TravMcKee/Satellite-UHF-Radio-Beacon-system/VIVA and Interim report/VIVA Presentation/solar panels.jpg

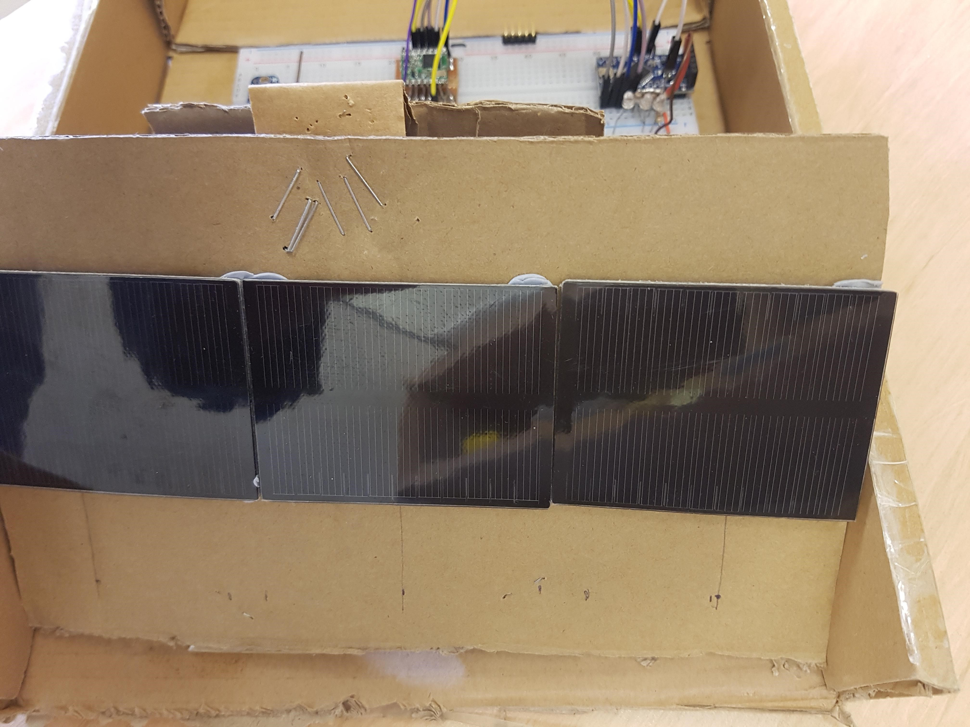
VIVA and Interim report/VIVA Presentation/solar panels.jpg
