TravMcKee/Satellite-UHF-Radio-Beacon-system/VIVA and Interim report/VIVA Presentation/complete system.jpg

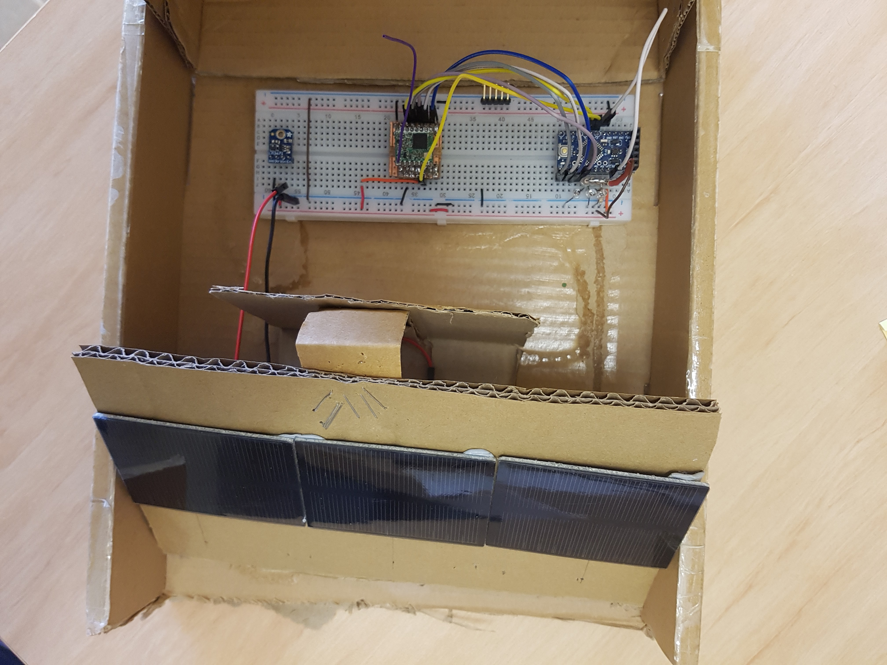
VIVA and Interim report/VIVA Presentation/complete system.jpg
