TravMcKee/Satellite-UHF-Radio-Beacon-system/README.md

# Satellite-UHF-Radio-Beacon-system
Satellite UHF Radio Beacon system for Identification, Telemetry, Tracking and Control

This repository provides all the data, testing files, results, softwar programs and documentation that was produced as part of the thesis project.
