TravMcKee/Satellite-UHF-Radio-Beacon-system/Additional resources/LoRa RFM95 Breadboard/RFM95LORA_Breadboard-master/README.md

# RFM95LORA_Breadboard
This is a KICAD project to create a RFM95 Breadboard PCB for LORAWAN operations

Here are the diagram and gerber files
