TravMcKee/Satellite-UHF-Radio-Beacon-system/project seminar/presentation.pdf

4/06/2020

# Design of a small satellite UHF radio

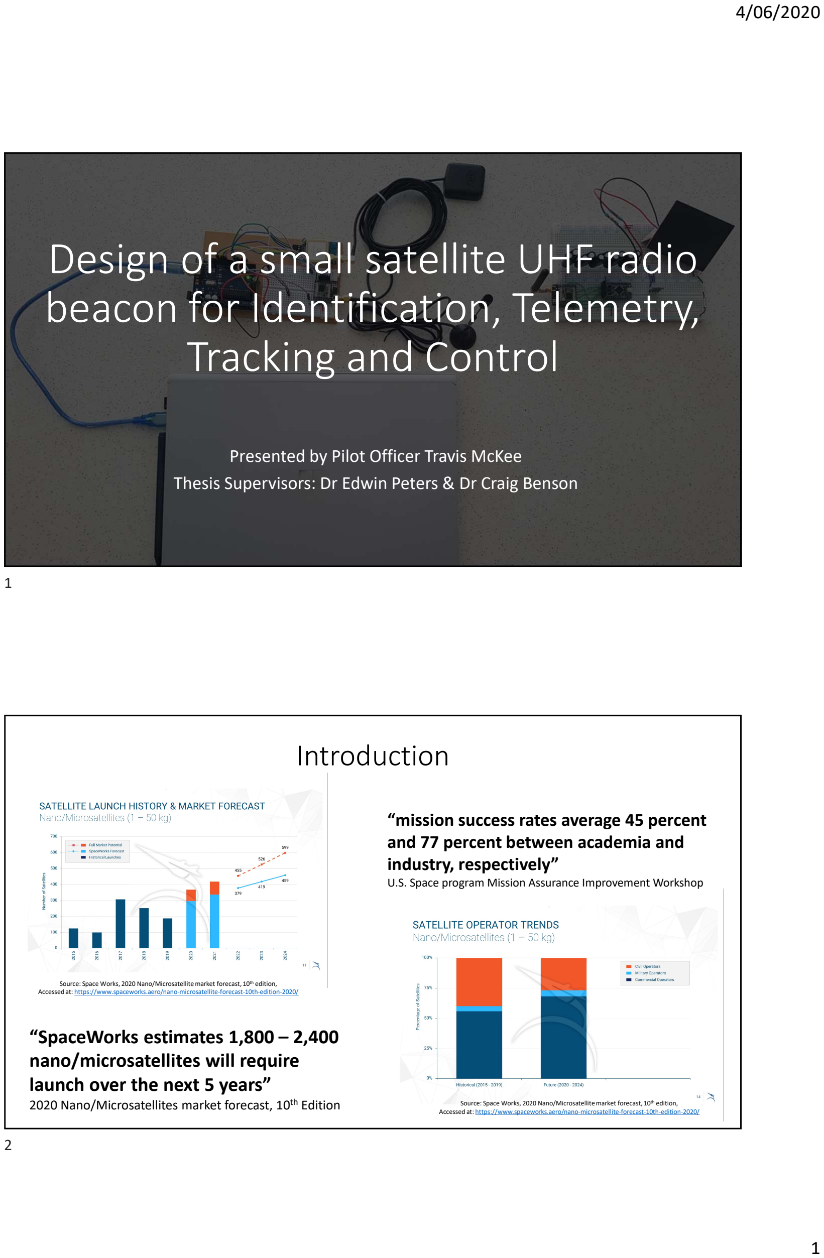
[picture p20: page 1]

1

beacon for Identification, Telemetry,

# Tracking and Control

### Presented by Pilot Officer Travis McKee Thesis Supervisors: Dr Edwin Peters & Dr Craig Benson

# Introduction

Source: Space Works, 2020 Nano/Microsatellite market forecast, 10th edition,
Accessed at: https://www.spaceworks.aero/nano-microsatellite-forecast-10th-edition-2020/ “SpaceWorks estimates 1,800 – 2,400

## nano/microsatellites will require launch over the next 5 years”

2020 Nano/Microsatellites market forecast, 10th Edition

### “mission success rates average 45 percent and 77 percent between academia and industry, respectively”

U.S. Space program Mission Assurance Improvement Workshop

Source: Space Works, 2020 Nano/Microsatellite market forecast, 10th edition, Accessed at: https://www.spaceworks.aero/nano-microsatellite-forecast-10th-edition-2020/

1

2

2

# Introduction

## 1. Increased demand on resource expensive space monitoring equipment to maintain Space situational awareness (SSA)

## 2. An increase in space debris due to a large failure rate of small satellites

## 3. Difficulties in identifying small objects in the LEO environment

## Additional challenges for monitoring and operating in the Low Earth Orbit (LEO) environment:

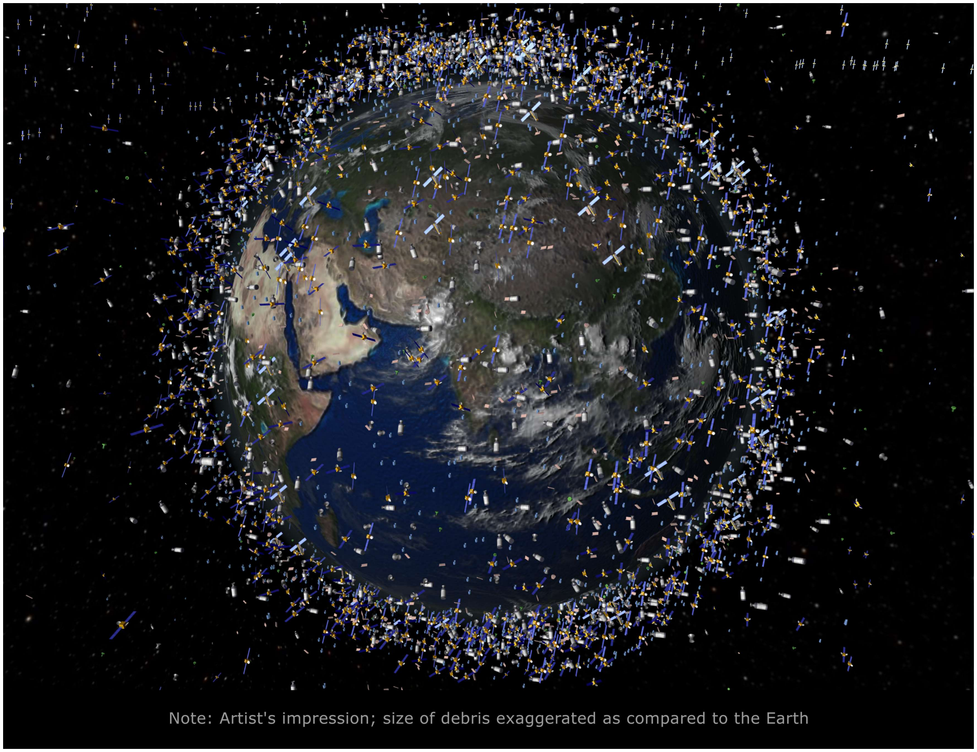
[picture p21: figure]

Image source: Universe Today, Space and astronomy news
Accessed at: https://www.universetoday.com/85322/what-is-low-earth-orbit/

# Introduction

The purpose of this project is to design a satellite UHF radio beacon system which provides: 1. A better technique of uniquely identifying an object in LEO 2. A cost-effective system of tracking objects 3. A method of obtaining satellite telemetry data irrespective of a failure in any other system 4. An alternative communications pathway for satellite control

3

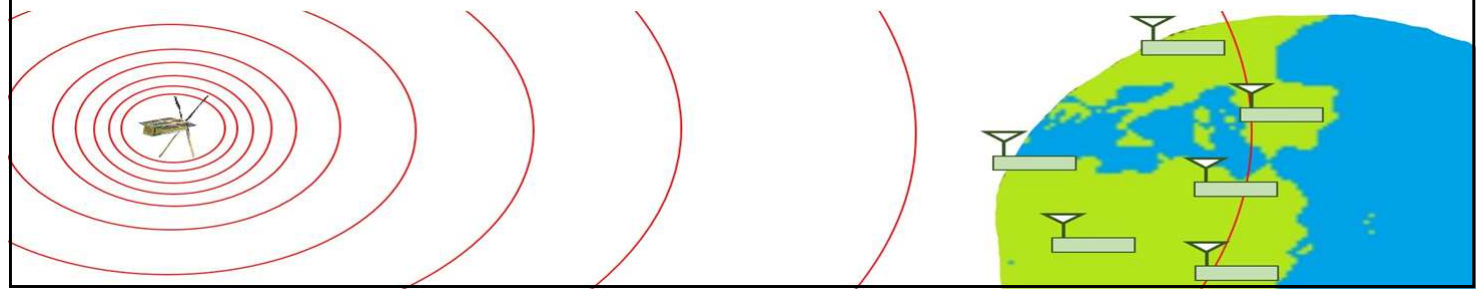
[picture p22: figure]

4

3

# Theory

of

# Operation

The Satellite UHF radio beacon system will be separated into 3 components: • The satellite radio beacon – A self-sustained system that can operate

independently of all other satellite systems

- The communications link – Supports the transmission of data from the radio beacon in LEO to a ground receiving station (2000km slant range) • The ground receiving station – Captures the transmitted data, records

the precise time of arrival (TOA) and passes data to a peripheral device.

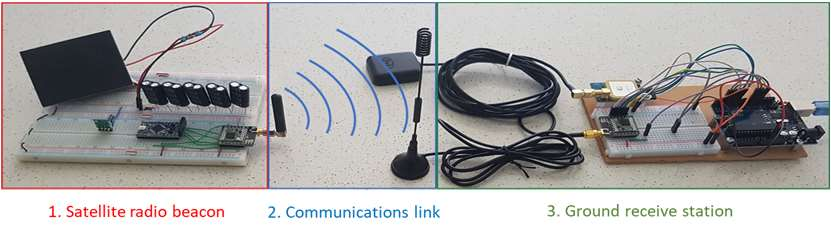
[picture p23: figure]

# Theory of operation

### - The satellite beacon periodically transmits the collected

telemetry data and a unique address from the UHF radio • Followed by a period where command data can be received

### - The transmitted data is collected with the measured time of

arrival at multiple graphically dispersed ground stations • The collected data and timestamps are passed along to a

peripheral device for processing. • The time difference of arrival (TDOA) between the three

### ground stations allows for the calculation of the satellites estimated position

5

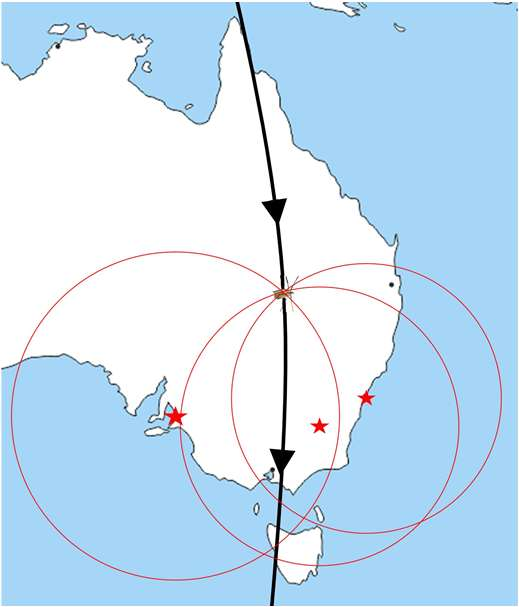
[picture p24: figure]

6

4

# Satellite Radio Beacon

The satellite radio beacon must be self-sustaining and independent of all other satellite systems

To achieve these aims the beacon contains its own: • Processor –Arduino Pro Mini (APM) module containing an ATMEGA328

processor • Radio Transceiver –RFM96 LoRa radio module, which uses an ultra-long

range spread spectrum communication techniques

- Power Generation, Storage and Regulation – 0.5W Silicon solar panel, super-capacitor storage system and a buck converter regulator

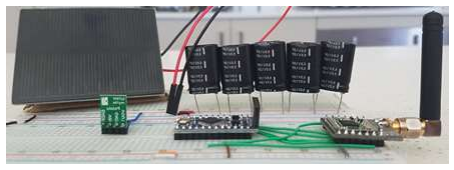
[picture p25: figure]

# Satellite Radio Beacon

The software cycle for the satellite radio beacon was developed to comply with the following requirements: • Maintain radio silence 30 minutes after release from

the launch vehicle

- A receive period to receive a command to cease radio transmissions as required by ACMA and ITU
- A variable period for the power down phase to prevent transmission synchronisation

7

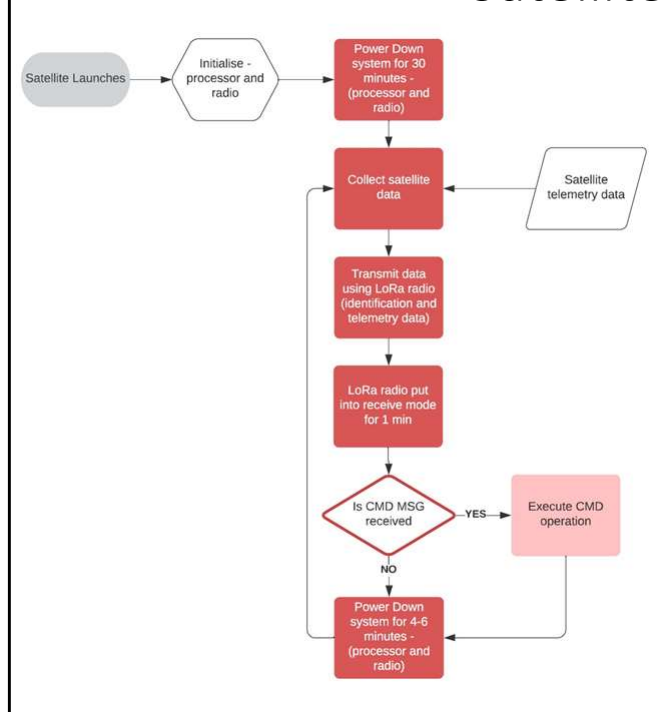
[picture p26: figure]

8

5

# Satellite Radio Beacon

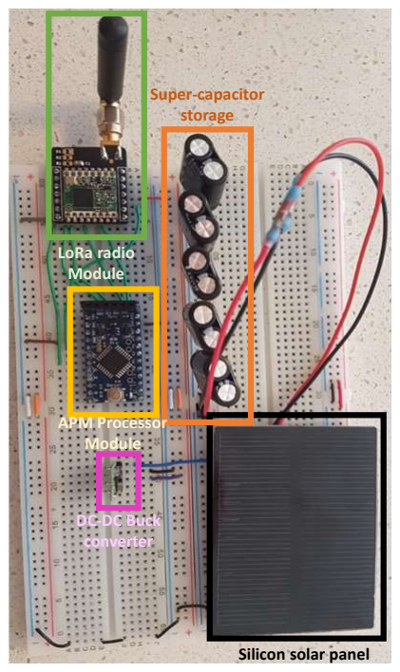
[picture p27: figure]
Super-capacitor storage; LoRa radio Module; APM Processor Module; DC-DC Buck converter; Silicon solar panel

### Manufacture of the satellite radio beacon prototype (see right) was a result of the testing carried out to minimise the Size, Weight and Power (SWaP) of each component

Methods to reduce the beacon current consumption: • Placing the LoRa module into sleep mode • Placing the processor into low power mode

- Minimizing the receive and transmit phase • Decreasing the TX power and data packet size

Additional observations during the testing: • One solar panel could not support beacon operation without

supplementary power • The super-capacitors introduce an 8 and ½ min delay to initialisation • Several radio packets were dropped by the LoRa radio module

(investigated in the communications link testing)

# Satellite Radio Beacon

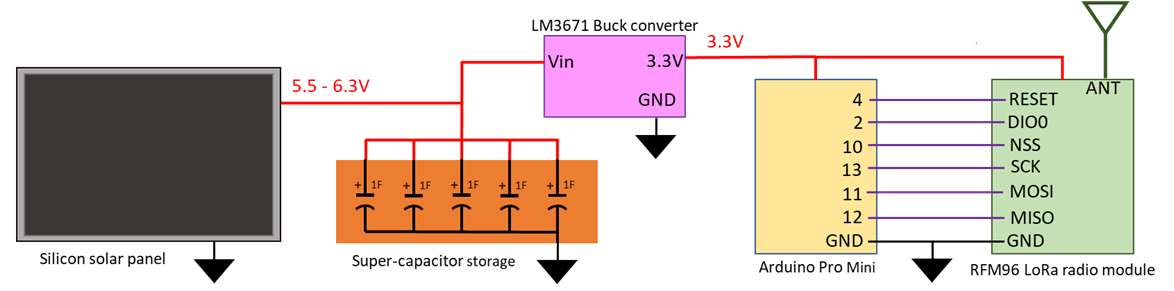
[picture p28: figure]

## Satellite UHF radio beacon conclusion

- A single solar panel can sustain beacon operation when using the super-capacitor storage
- The power storage system provides 74 minutes of operation when no power is being generated
- A combination of connections remaining to collect satellite telemetry data
- Over 50% of the system memory remains for additional software development

### Investigation of space-ready components and a PCB design is required before mission-readiness testing can be commenced

9

10

6

# Communications Link

The parameters for the communication link testing are based on a sun-synchronous LEO orbit with an orbital height of 600km and a 98° inclination.

Resultant Orbital characteristics: • 90-minute orbital period

- ~9-minute view window
- 2000km maximum slant range
- 151.3dB Free Space Path Loss (at 2000km)

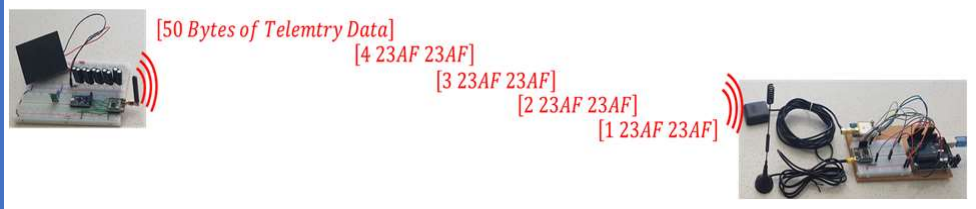
[picture p29: figure]

# Communications Link

First investigation
Determine why the LoRa radio module was dropping received packets

Result • The reason could not be determined due to proprietary nature of the LoRa module software • No methods could be found to bypass the LoRa software receive process

- Analysing over 1 million Bytes of data found a Packet Error Rate (PER) of ~1%

Mitigation
- The PER changed how the identification and address data was transmitted
- Separating the data packets results in a 0.00001% probability of not receiving the identification data

11

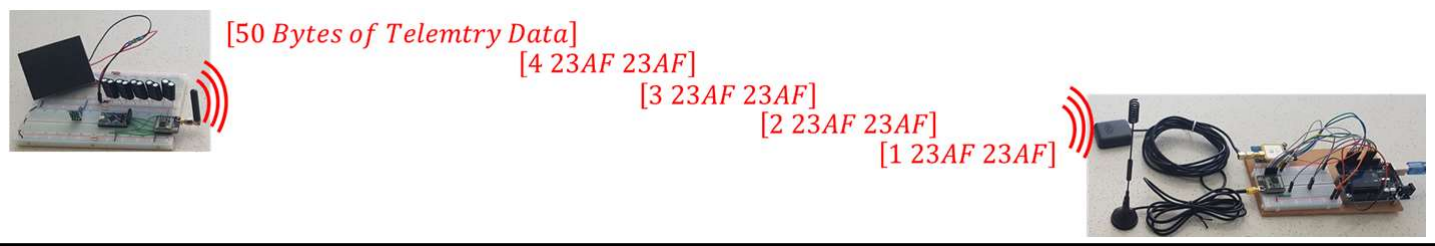
[picture p30: figure]

12

7

# Communications Link

Second investigation
Verify the UHF communications link for a 2000km slant range (151.3dB FSPL) and determine the LoRa radio software settings and TX power.

Testing procedure
1. Receiver sensitivity estimated using the LoRa modem calculator tool (available from Semtech)

### 2. The link budget was calculated for various TX power (5, 10, 15 and 20dBm) 3. The results were verified with the ground-based testing

The radio settings used for testing were from the open-sourced RadioHead library default settings

RadioHead default setting | LoRa module radio configuration | Bandwidth | Coding rate | Spreading factor | Preamble length | Estimated Bit rate | Estimated receiver sensistivity
(0) | Medium range & data rate | 125 kHz | 4/5 | 7 (128 chips/symbol) | 12 | 5469 bps | -124 dBm
(2) | Long range, slow data rate | 31.25 kHz | 4/8 | 10 (512 chips/symbol) | 12 | 152.59 bps | -139.4 dBm
(3) | Long range, slow data rate | 125 kHz | 4/8 | 12 (4096 chips/symbol) | 12 | 183.11 bps | -138 dBm

# Communications Link

Assumptions: • LoRa module has a 0.5dB feeder loss

- 290k ground temperature • 3.5dBi helix transmitter antenna
- 3.5dBi helix receiver antenna (noting there is a 12dBi antenna that could be used) • Maximum bit rate (f) obtained using the LoRa modem calculator tool (proven using hand calculations)

### Link Budget Calculations

C

= Pamp − Lft + Gt − LFS − LA

C
N0

= C − 10. log k +

G
Te − Lfr

Eb
N0 =

C
N0

− 10. log (fb)

### Calculated values for the communications link budget

| (0) Medium Range Settings | (2) Long Range Settings | (3) Long Range Settings
RadioHead default settings Parameter Transmitter Power, Pamp (dBm) | -8.73 5 -3.73 10 1.27 15 6.27 20 | 4.38 5 9.38 10 Downlink 14.38 15 20.38 20 | 3.59 5 8.59 10 Downlink 13.59 15 18.59 Downlink 20 Bit Enegy/Noise Density Ratio, Eb/No

Link Budget calculations for the satellite radio beacon communications link at 2000kms

13

14

8

# Communications Link

Ground-Based Testing
Two LoRa modules were connected with coaxial cables and attenuation that represents the maximum FSPL (and calculated range) for the consistent reception of data packets

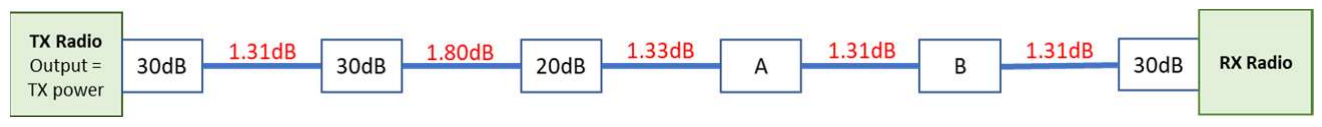
[picture p31: figure]

### Results of the ground-based communication link testing

## Communications link conclusion

The RadioHead (2) default setting with a 15dBm TX power was selected for the LoRa radio module

These settings balance the satellite beacon power consumption, received E/N (14.38) and data rate

Transmit power (dBm) | | 10 | 15 | 20 5
RadioHead default setting | Reciever sensitivity (dB) | Total attenuation (dB) | Distance (kms) | Total attenuation (dB) | Distance (kms) | Total attenuation (dB) | Distance (kms) | Total attenuation (dB) | Distance (kms)
(0) | -124 | 131.14 | 195 | 137.14 | 390 | 141.14 | 620 | 145.14 | 980
(2) | -139.2 | 146.14 | 1100 | 151.14 | 1950 | 155.14 | 3100 | 161.14 | 6200
(3) | -138 | 144.14 | 880 | 150.14 | 1750 | 155.14 | 3100 | 160.14 | 5500

Largest measured FSPL attenuation and distance for consistent data reception

# Ground Receiving Station

The ground receiving station must be able to capture the transmitted data, record the precise time of arrival of the RF signals, determine its global location and pass data to a peripheral device.

To achieve these aims the ground receiving station contains: • Processor module – Arduino Uno development board with an

ATMEGA328P processor and 16MHz oscillator • Radio Module – RFM96 LoRa radio module

- GPS Module – U-Blox NEO-7M GNSS module with a Pulse-per-Second signal synchronized to Coordinated Universal Time (UTC)

15

16

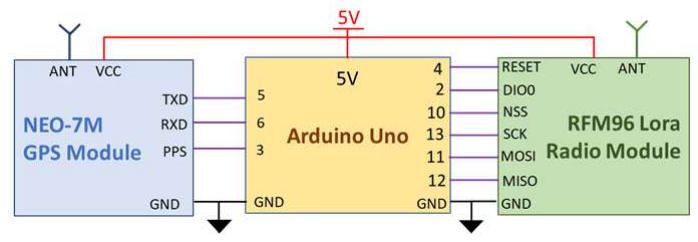
[picture p32: figure]

9

# Ground receiving station

### Ground receiving station software cycle

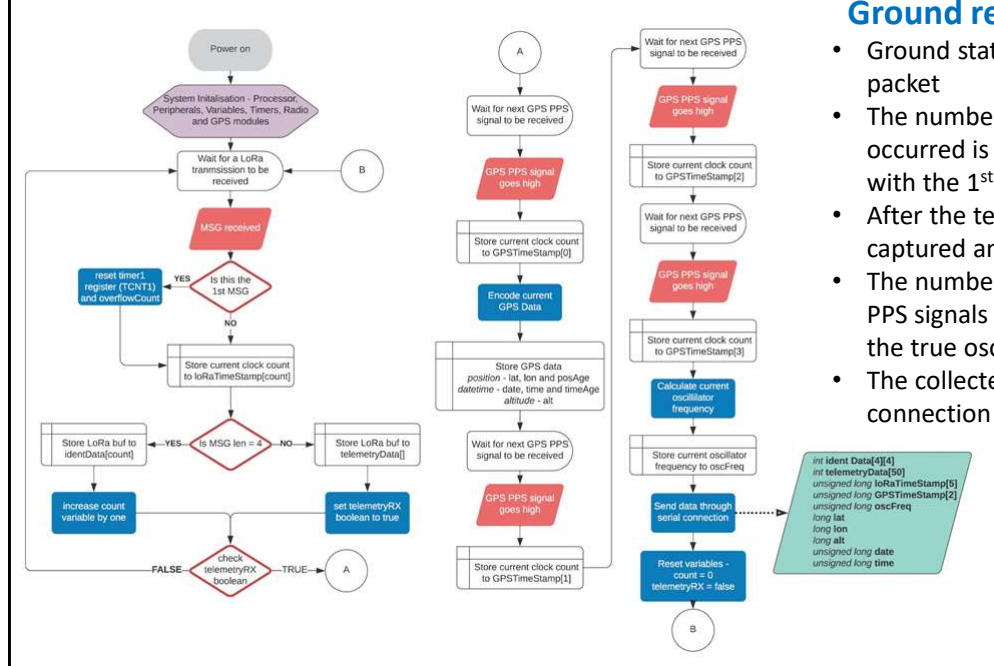
[picture p33: figure]

- Ground station captures the data from each received packet • The number of processor clock cycles that have

occurred is timestamped (the clock count is reset with the 1st Received signal) • After the telemetry data is received, the GNSS data is

captured and timestamped at the next PPS pulse, • The number of clock cycles between the next 3 GNSS

PPS signals are collected and averaged to determine the true oscillator frequency
- The collected data is passed through the serial connection to a peripheral device
- The true oscillator frequency is used to determine the length of the processors clock cycle
- This value is used to calculate the time of arrival of each timestamp with reference to the captured UTC

# Ground receiving station

First Investigation
To test and quantify the identified sources of uncertainty in measuring time/distance:
1. 4µs Resolution of the Arduino timing function, micros() – led to using the clock counting technique
2. Error in TIMER1 processor clock counting technique, ±3 clock cycles ~187.5ns (equates to 56.5m)
3. Number of clock cycles taken for an Interrupt Service Routine (ISR), no error time difference

### 4. External oscillator drift and tolerances, < 2fs (negligible) 5. GNSS PPS signal tolerance, 30ns (9m) 6. GNSS position tolerance, 10m 7. Difference in LoRa software receive processing time, 5µs (1.5km)

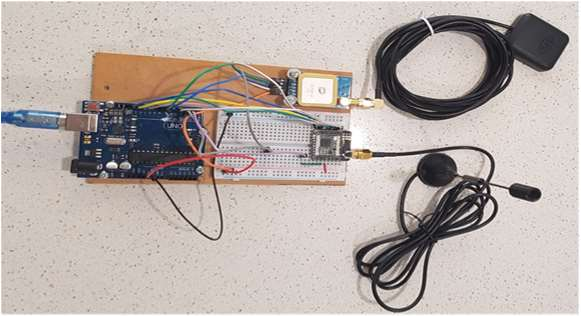
[picture p34: figure]

Results
The total estimated uncertainty in the time difference of arrival between two ground stations was 5.25µs. This equates to an uncertainty of 1.58km when estimating the

position using the TDOA calculation technique.

17

18

10

# Ground receiving station

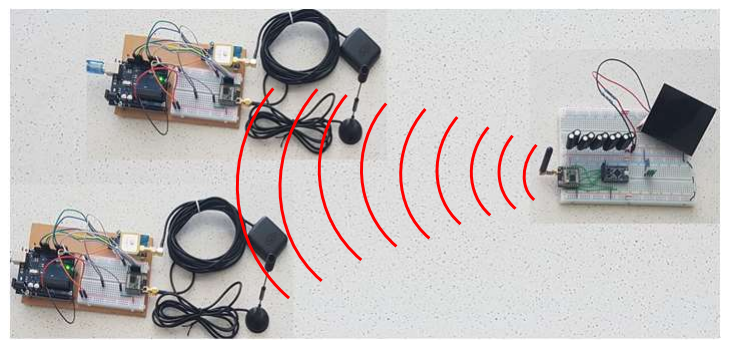
[picture p35: figure]

## Ground Receiving station conclusion

The estimated uncertainty in satellite position was 1.58km, the verification test revealed an uncertainty of 510km

The mostly likely cause of the large uncertainty is the implementation of the processor clock counting ISR

The clock counting technique requires examination with a focus on timer capture mode, before a reliable TDOA algorithm can be used to estimate the satellites position.

Final verification Testing
Two ground stations were uniformly connected to a single radio beacon
The measured time difference of arrival is the level of uncertainty in measuring time

Results
Total measured uncertainty was 1.7ms, which equates to TDOA distance calculation error is 510km

# Conclusion

## Project aim: Prototype design for a self-contained and independent radio beacon Project extension: Prototype design for a ground receiving station

The Satellite UHF radio beacon system has been tested and verified to:

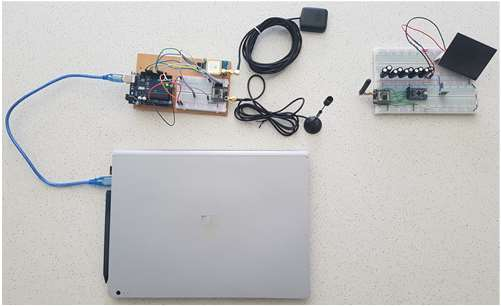
[picture p36: figure]

### - The initial design for the small satellite UHF radio beacon system has proven the concept for the small satellite beacon Identification, Telemetry and Control

### - Further investigation is required to obtain a reliable and accurate tracking function

- Sustain beacon operation without any input • Operate for a 2000km range
- Transmit the satellite identification to the ground station
- Transmit satellite telemetry and health data
- Execute a satellite control command from a ground station
- Measure a signal Time of Arrival with a 1.7ms tolerance (510km position calculation uncertainty)

19

20

11

# Recommendations

### Further investigation is required to reduce the uncertainty of time measurement, with a focus processor Timer1 clock counting implementation in the ground station software

If the uncertainty of time measurement is reduced, then the next step is to: • Implement a TDOA algorithm that calculates estimated position based on Lat/Long

### position - Develop a user interface program for the ground receiving station - Develop a server system for the collection and processing of ground station data - Produce a satellite radio beacon design ready for space mission readiness testing

21

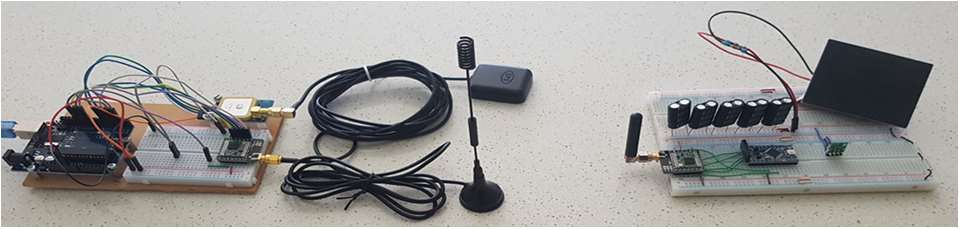
[picture p37: figure]
