TravMcKee/Satellite-UHF-Radio-Beacon-system/VIVA and Interim report/Appendix A - Project Gantt chart.xlsx

Sheet: ProjectSchedule
Create a Project Schedule in this worksheet. Enter title of this project in cell B1. Information about how to use this worksheet, including instructions for screen readers and the author of this workbook is in the About worksheet. Continue navigating down column A to hear further instructions. | Small Sat UHF Identification and TT&C radio beacon
Enter Company Name in cell B2. | UNINSW Canberra - Thesis project |  |  |  |  | https://www.vertex42.com/ExcelTemplates/simple-gantt-chart.html
Enter the name of the Project Lead in cell B3. Enter the Project Start date in cell E3. Pooject Start: label is in cell C3. | Travis MCKee | Project Start: |  | 2019-07-17 |  | Week 1 |  |  |  |  |  |  | Week 2 |  |  |  |  |  |  | Week 3 |  |  |  |  |  |  | Week 4 |  |  |  |  |  |  | Week 5 |  |  |  |  |  |  | Week 6 |  |  |  |  |  |  | Week 7 |  |  |  |  |  |  | W8 - Break
The Display Week in cell E4 represents the starting week to display in the project schedule in cell I4. The project start date is considered Week 1. To change the display week, simply enter a new week number in cell E4. The starting date for each week, starting with the display week from cell E4, starts in cell I4 and is auto calculated. There are 8 weeks represented in this view from cell I4 through cell BF4. You should not modify these cells. Display Week: label is in cell C4. |  | Display Week: |  | 1 |  | 2019-07-15 |  |  |  |  |  |  | 2019-07-22 |  |  |  |  |  |  | 2019-07-29 |  |  |  |  |  |  | 2019-08-05 |  |  |  |  |  |  | 2019-08-12 |  |  |  |  |  |  | 2019-08-19 |  |  |  |  |  |  | 2019-08-26 |  |  |  |  |  |  | 2019-09-02
Cells I5 through BL5 contain the day number for the week represented in the cell block above each date cell and are auto calculated. You should not modify these cells. Today's date is outlined in Red (hex #AD3815) from today's date in row 5 through the entire date column to the end of the project schedule. |  |  |  |  |  | 2019-07-15 | 2019-07-16 | 2019-07-17 | 2019-07-18 | 2019-07-19 | 2019-07-20 | 2019-07-21 | 2019-07-22 | 2019-07-23 | 2019-07-24 | 2019-07-25 | 2019-07-26 | 2019-07-27 | 2019-07-28 | 2019-07-29 | 2019-07-30 | 2019-07-31 | 2019-08-01 | 2019-08-02 | 2019-08-03 | 2019-08-04 | 2019-08-05 | 2019-08-06 | 2019-08-07 | 2019-08-08 | 2019-08-09 | 2019-08-10 | 2019-08-11 | 2019-08-12 | 2019-08-13 | 2019-08-14 | 2019-08-15 | 2019-08-16 | 2019-08-17 | 2019-08-18 | 2019-08-19 | 2019-08-20 | 2019-08-21 | 2019-08-22 | 2019-08-23 | 2019-08-24 | 2019-08-25 | 2019-08-26 | 2019-08-27 | 2019-08-28 | 2019-08-29 | 2019-08-30 | 2019-08-31 | 2019-09-01 | 2019-09-02 | 2019-09-03 | 2019-09-04
This row contains headers for the project schedule that follows below them. Navigate from B6 through BL 6 to hear the content. The first letter of each day of the week for the date above that heading, starts in cell I6 and continues through cell BL6. All project timeline charting is auto generated based on the start and end dates entered, using conditional formats. Do not modify content in cells within columns after column I starting with cell I7. | TASK | ASSIGNED TO | PROGRESS | START | END | M | T | W | T | F | S | S | M | T | W | T | F | S | S | M | T | W | T | F | S | S | M | T | W | T | F | S | S | M | T | W | T | F | S | S | M | T | W | T | F | S | S | M | T | W | T | F | S | S | M | T | W
Cell B8 contains the Phase 1 sample title. Enter a new Title in cell B8. Enter a name to assign the phase to, if it applies for your project, in cell C8. Enter Progress for the entire phase, if it applies for your project, in cell D8. Enter the start and end dates for the entire phase, if it applies for your project, in cells E8 and F8. The Gantt chart will automatically fill in the appropriate dates and shade according to the progress entered. To delete the phase and work only from tasks, simply delete this row. | Planning
Cell B9 contains the sample task "Task 1." Enter a new task name in cell B9. Enter a person to assign the task to in cell C9. Enter progres of the task in cell D9. A progress bar appears in the cell and is shaded according to the number in the cell. For example, 50 percent progress would shade half of the cell. Enter task start date in cell E9. Enter task end date in cell F9. A status bar shaded for the dates entered appears in blocks starting from cell I9 through BL9. | Scope Determination |  | 100% | 2019-07-15 | 2019-08-04
Rows 10 through 13 repeat the pattern from row 9. Repeat the instructions from cell A9 for all task rows in this worksheet. Overwrite any sample data. A sample of another phase starts in cell A14. Continue entering tasks in cells A10 through A13 or go to cell A14 to learn more. | Literture Review |  | 100% | 2019-06-15 | 2019-10-04
 | General Research |  | 100% | 2019-07-15 | 2019-09-01
The cell at right contains the Phase 2 sample title. You can create a new phase at any time within column B. This project schedule does not require phases. To remove the phase, simply delete the row. To create a new phase block in this row, enter a new Title in cell at right. To continue adding tasks to the phase above, enter a new row above this one and fill in the task data as in cell A9's instruction. Update the Phase details in cell at right based on cell A8's instruction. Continue navigating down column A cells to learn more. If you haven't added any new rows in this worksheet, you will find 2 additional sample phase blocks have been created for you in cells B20 and B26. Otherwise, navigate through column A cells to find the additional blocks. Repeat the instructions from cells A8 and A9 whenever you need to. | Breadboard design and build
 | Initial system design |  | 100% | 2019-08-12 | 2019-08-25
 | Processor and comms build |  | 100% | 2019-08-26 | 2019-09-15
 | Ground Solar generation and regulation build |  | 100% | 2019-09-16 | 2019-09-22
 | Full breadboard intergration |  | 100% | 2019-09-23 | 2019-10-04
 | breadboard extra peripherals design and build |  | 100% | 2019-09-26 | 2019-10-17
Sample phase title block | Testing and Evaluation
 | Initial testing |  | 100% | 2019-09-16 | 2019-09-22
 | Power cycle testing |  | 100% | 2019-09-22 | 2019-09-29
 | Solar Power Testing |  | 100% | 2019-09-26 | 2019-09-29
 | Short and full beacon cycle testing |  | 100% | 2019-09-29 | 2019-10-04
 | Extra peripherals testing |  | 100% | 2019-09-29 | 2019-10-04
 | VIVA presentation testing |  | 100% | 2019-10-04 | 2019-10-07
 | Initial testing plan |  | 0% | 2019-10-07 | 2019-12-08
 | Final testing plan |  | 0% | 2019-12-09 | 2020-01-31
Sample phase title block | Incremental development milestones
 | breadboard Model for VIVA presentation |  | 100% | 2019-08-12 | 2019-10-07
 | Initial software development |  | 100% | 2019-08-12 | 2019-10-07
 | Initial breadboard testing |  | 100% | 2019-09-29 | 2019-10-07
 | Finial breadboard testing |  | 0% | 2019-10-07 | 2019-12-08
 | Intial PCB Design |  | 0% | 2019-10-07 | 2019-12-23
 | Initial PCB prototype |  | 0% | 2019-12-23 | 2020-01-19
 | Initial PCB testing |  | 0% | 2020-01-19 | 2020-01-26
 | Build, Test, Evaluate and Redesign cycle |  | 0% | 2020-01-16 | 2020-05-25
 | 1st deliverable working PCB model |  | 0% | 2020-02-10 | 2020-02-10
 | Final PCB model |  | 0% | 2020-05-25 | 2020-05-25
 | Final model tested and complete |  | 0% | 2020-05-25 | 2020-05-31
 | Final software design for PCB model (seminar presentation) |  | 0% | 2020-06-01 | 2020-06-06
The cell at right contains the Phase 2 sample title. You can create a new phase at any time within column B. This project schedule does not require phases. To remove the phase, simply delete the row. To create a new phase block in this row, enter a new Title in cell at right. To continue adding tasks to the phase above, enter a new row above this one and fill in the task data as in cell A9's instruction. Update the Phase details in cell at right based on cell A8's instruction. Continue navigating down column A cells to learn more. If you haven't added any new rows in this worksheet, you will find 2 additional sample phase blocks have been created for you in cells B20 and B26. Otherwise, navigate through column A cells to find the additional blocks. Repeat the instructions from cells A8 and A9 whenever you need to. | Documentation
 | Access approval forms |  | 100% | 2019-07-16 | 2019-07-16
 | TSG/WHS/Ethics plan |  | 100% | 2019-08-16 | 2019-08-16
 | Interim Report |  | 100% | 2019-10-04 | 2019-10-04
 | VIVA |  | 100% | 2019-10-07 | 2019-10-18
 | Final Report |  | 0% | 2020-06-09 | 2020-06-09
 | Deliverables |  | 0% | 2020-06-15 | 2020-06-15
 | Project Seminar |  | 0% | 2020-05-25 | 2020-06-05
Sample phase title block | Extension
 | Full SSA system concept, design and protype |  | 0% | 2019-11-11 | 2020-06-08
 | Full Control intergration |  | 0% | 2019-11-11 | 2020-06-08
 | LEO tracking system concept and design |  | 0% | 2019-11-11 | 2020-06-08
 | Amatuer tracking system |  | 0% | 2019-11-11 | 2020-06-08
This is an empty row
This row marks the end of the Project Schedule. DO NOT enter anything in this row. Insert new rows ABOVE this one to continue building out your Project Schedule. | Insert new rows ABOVE this one

Sheet: About
SIMPLE GANTT CHART by Vertex42.com (https://www.vertex42.com/ExcelTemplates/simple-gantt-chart.html)
https://www.vertex42.com/ExcelTemplates/simple-gantt-chart.html
About This Template
This template provides a simple way to create a Gantt chart to help visualize and track your project. Simply enter your tasks and start and end dates - no formulas required. The bars in the Gantt chart represent the duration of the task and are displayed using conditional formatting. Insert new tasks by inserting new rows.
Guide for Screen Readers
There are 2 worksheets in this workbook. TimeSheet About The instructions for each worksheet are in the A column starting in cell A1 of each worksheet. They are written with hidden text. Each step guides you through the information in that row. Each subsequent step continues in cell A2, A3, and so on, unless otherwise explicitly directed. For example, instruction text might say "continue to cell A6" for the next step. This hidden text will not print. To remove these instructions from the worksheet, simply delete column A.
Additional Help
Click on the link below to visit vertex42.com and learn more about how to use this template, such as how to calculate days and work days, create task dependencies, change the colors of the bars, add a scroll bar to make it easier to change the display week, extend the date range displayed in the chart, etc.
How to Use the Simple Gantt Chart (https://www.vertex42.com/ExcelTemplates/simple-gantt-chart.html)
More Project Management Templates
Visit Vertex42.com to download other project management templates, including different types of project schedules, Gantt charts, tasks lists, etc.
Project Management Templates (https://www.vertex42.com/ExcelTemplates/excel-project-management.html)
About Vertex42
Vertex42.com provides over 300 professionally designed spreadsheet templates for business, home, and education - most of which are free to download. Their collection includes a variety of calendars, planners, and schedules as well as personal finance spreadsheets for budgeting, debt reduction, and loan amortization.
Businesses will find invoices, time sheets, inventory trackers, financial statements, and project planning templates. Teachers and students will find resources such as class schedules, grade books, and attendance sheets. Organize your family life with meal planners, checklists, and exercise logs. Each template is thoroughly researched, refined, and improved over time through feedback from thousands of users.
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
