TravMcKee/Satellite-UHF-Radio-Beacon-system/VIVA and Interim report/Sem 1, 2020 resources/Copy of Sample Asssessment Planner (1).xlsx

Sheet: Sem version 1
Units and assessment | Week 1 | Week 2 | Week 3 | Week 4 | Week 5 | Week 6 | Week 7 | Mid-Session Break | Mid-Session Break | Week 8 | Week 9 | Week 10 | Week 11 | Week 12 | Week 13 | Exam Period
ZQRS101 | ZQRS101 | ZQRS101 | ZQRS101 | ZQRS101 | ZQRS101 | ZQRS101 | ZQRS101 | ZQRS101 | ZQRS101 | ZQRS101 | ZQRS101 | ZQRS101 | ZQRS101 | ZQRS101 | ZQRS101 | ZQRS101
Meetings with supervisor/panel | Arrange meeting with supervisor | Have first meeting with supervisor | First meeting with panel | Meeting with supervisor |  | Meeting with supervisor | Second meeting with panel | Meeting with supervisor |  | Meeting with supervisor | Third meeting with panel | Meeting with supervisor |  | Meeting with supervisor | Fourth meeting with panel
Research Proposal | Conduct research for proposal | Start writing first draft of proposal | Revise drafts of proposal | Research Proposal due
Research Report | Define the problem; Develop answerable research questions; research how others have approached these questions; narrow the topic further | Define the research variables; Define a hypothesis; | Design experiement; think clearly about controls needed; Locate and finalise measurement instruments; | Start designing stimuli | Complete design of stimuli | Expand on literature review for research report; Collect data; write methodology section | Finish collecting data | Revise understanding of statistical tests needed for data analysis; | Finish analysing data | Draw conclusions based on findings; think about suggestions for further research | Write up results section | Ensure whole report is coherent | Research Report due
Oral Defence |  |  |  |  |  |  |  |  |  |  |  |  | Start preparing oral defence | Complete oral defence | Practice oral defence | Oral Defence due
ZABC123 | ZABC123 | ZABC123 | ZABC123 | ZABC123 | ZABC123 | ZABC123 | ZABC123 | ZABC123 | ZABC123 | ZABC123 | ZABC123 | ZABC123 | ZABC123 | ZABC123 | ZABC123 | ZABC123
Class Test 20% |  |  |  | Test self on theory and formulas | Test self on theory and formulas | Class Test 20%
Assignment 20% |  |  |  |  |  |  | Start research for assignment | Start writing assignment | Finish first draft of assignment | Finish final draft of assignment |  | Assignment 20%
Final Exam 60% | Read textbook or readings; revise lecture content; practice formulas and calculations | Read textbook or readings; revise lecture content; practice formulas and calculations | Read textbook or readings; revise lecture content; practice formulas and calculations | Read textbook or readings; revise lecture content; practice formulas and calculations | Read textbook or readings; revise lecture content; practice formulas and calculations | Read textbook or readings; revise lecture content; practice formulas and calculations | Read textbook or readings; revise lecture content; practice formulas and calculations |  |  | Read textbook or readings; revise lecture content; practice formulas and calculations | Read textbook or readings; revise lecture content; practice formulas and calculations | Read textbook or readings; revise lecture content; practice formulas and calculations | Read textbook or readings; revise lecture content; practice formulas and calculations | Read textbook or readings; revise lecture content; practice formulas and calculations | Read textbook or readings; revise lecture content; practice formulas and calculations | Exam 60%
ZBBB100 | ZBBB100 | ZBBB100 | ZBBB100 | ZBBB100 | ZBBB100 | ZBBB100 | ZBBB100 | ZBBB100 | ZBBB100 | ZBBB100 | ZBBB100 | ZBBB100 | ZBBB100 | ZBBB100 | ZBBB100 | ZBBB100
Weekly Homework 15% |  | Finish weekly homework 1.25% | Finish weekly homework 1.25% | Finish weekly homework 1.25% | Finish weekly homework 1.25% | Finish weekly homework 1.25% | Finish weekly homework 1.25% |  |  | Finish weekly homework 1.25% | Finish weekly homework 1.25% | Finish weekly homework 1.25% | Finish weekly homework 1.25% | Finish weekly homework 1.25% | Finish weekly homework 1.25%
Class Test 25% |  |  |  |  |  |  |  |  |  | Test self on theory and formulas | Test self on theory and formulas | Class Test 15%
Final Exam 55% | Read textbook or readings; revise lecture content; practice formulas and calculations | Read textbook or readings; revise lecture content; practice formulas and calculations | Read textbook or readings; revise lecture content; practice formulas and calculations | Read textbook or readings; revise lecture content; practice formulas and calculations | Read textbook or readings; revise lecture content; practice formulas and calculations | Read textbook or readings; revise lecture content; practice formulas and calculations | Read textbook or readings; revise lecture content; practice formulas and calculations |  |  | Read textbook or readings; revise lecture content; practice formulas and calculations | Read textbook or readings; revise lecture content; practice formulas and calculations | Read textbook or readings; revise lecture content; practice formulas and calculations | Read textbook or readings; revise lecture content; practice formulas and calculations | Attempt past exams | Attempt past exams | Exam 55%
ZXYZ100 | ZXYZ100 | ZXYZ100 | ZXYZ100 | ZXYZ100 | ZXYZ100 | ZXYZ100 | ZXYZ100 | ZXYZ100 | ZXYZ100 | ZXYZ100 | ZXYZ100 | ZXYZ100 | ZXYZ100 | ZXYZ100 | ZXYZ100 | ZXYZ100
Assignment 1500 words 30% | Start research for assignment | Start writing assignment | Finish first draft of assignment | Finish assignment | Assignment 30%
Class Test 30% | Read textbook or readings; revise lecture content; practice formulas and calculations | Read textbook or readings; revise lecture content; practice formulas and calculations | Read textbook or readings; revise lecture content; practice formulas and calculations | Read textbook or readings; revise lecture content; practice formulas and calculations | Read textbook or readings; revise lecture content; practice formulas and calculations | Read textbook or readings; revise lecture content; practice formulas and calculations | Read textbook or readings; revise lecture content; practice formulas and calculations |  |  | Read textbook or readings; revise lecture content; practice formulas and calculations | Read textbook or readings; revise lecture content; practice formulas and calculations | Read textbook or readings; revise lecture content; practice formulas and calculations | Class Test 30%
Presentation 20% |  |  |  |  |  | Start researching presentation | Research for presentation and brainstorm ideas | Final planning for presentation | Practice delivery of presentation | Presentation 20%
Assignment 3000 words 20% |  |  |  |  |  |  |  |  |  | Start research for assignment | Start writing assignment | Write assignment | Write assignment | Finish first draft of assignment | Finish assignment | Assignment 20%

Sheet: Sem version 2
UNIT | ZQRS101 | ZQRS101 | ZQRS101 | ZQRS102 | ZABC123 | ZABC123 | ZABC123 | ZBBB100 | ZBBB100 | ZBBB100 | ZXYZ100 | ZXYZ100 | ZXYZ100 | ZXYZ100
Assessment | Meetings with supervisor/panel | Research Proposal | Research Report | Oral Defence | Final Exam 60% | Class Test 20% | Assignment 20% | Final Exam 55% | Class Test 25% | Weekly Homework 15% | Assignment 1500 words 30% | Class Test 30% | Presentation 20% | Assignment 3000 words 20%
Week 1 | Arrange meeting with supervisor | Conduct research for proposal | Define the problem; Develop answerable research questions; research how others have approached these questions; narrow the topic further |  | Read textbook or readings; revise lecture content; practice formulas and calculations |  |  | Read textbook or readings; revise lecture content; practice formulas and calculations |  |  | Start research for assignment | Read textbook or readings; revise lecture content; practice formulas and calculations
Week 2 | Have first meeting with supervisor | Start writing first draft of proposal | Define the research variables; Define a hypothesis; |  | Read textbook or readings; revise lecture content; practice formulas and calculations |  |  | Read textbook or readings; revise lecture content; practice formulas and calculations |  | Finish weekly homework 1.25% | Start writing assignment | Read textbook or readings; revise lecture content; practice formulas and calculations
Week 3 | First meeting with panel | Revise drafts of proposal | Design experiement; think clearly about controls needed; Locate and finalise measurement instruments; |  | Read textbook or readings; revise lecture content; practice formulas and calculations |  |  | Read textbook or readings; revise lecture content; practice formulas and calculations |  | Finish weekly homework 1.25% | Finish first draft of assignment | Read textbook or readings; revise lecture content; practice formulas and calculations
Week 4 | Meeting with supervisor | Research Proposal due | Design stimuli |  | Read textbook or readings; revise lecture content; practice formulas and calculations | Test self on theory and formulas |  | Read textbook or readings; revise lecture content; practice formulas and calculations |  | Finish weekly homework 1.25% | Finish assignment | Read textbook or readings; revise lecture content; practice formulas and calculations
Week 5 |  |  | Design stimuli; expand on literature review for research report |  | Read textbook or readings; revise lecture content; practice formulas and calculations | Test self on theory and formulas |  | Read textbook or readings; revise lecture content; practice formulas and calculations |  | Finish weekly homework 1.25% | Assignment 30% | Read textbook or readings; revise lecture content; practice formulas and calculations
Week 6 | Meeting with supervisor |  | Collect data; write methodology section |  | Read textbook or readings; revise lecture content; practice formulas and calculations | Class Test 20% |  | Read textbook or readings; revise lecture content; practice formulas and calculations |  | Finish weekly homework 1.25% |  | Read textbook or readings; revise lecture content; practice formulas and calculations | Start researching presentation
Week 7 | Second meeting with panel |  | Collect data; |  | Read textbook or readings; revise lecture content; practice formulas and calculations |  | Start research for assignment | Read textbook or readings; revise lecture content; practice formulas and calculations |  | Finish weekly homework 1.25% |  | Read textbook or readings; revise lecture content; practice formulas and calculations | Research for presentation and brainstorm ideas
Mid-Session Break | Meeting with supervisor |  | Revise understanding of statistical tests needed for data analysis; |  |  |  | Start writing assignment |  |  |  |  |  | Final planning for presentation
Mid-Session Break |  |  | Analyse data; |  |  |  | Finish first draft of assignment |  |  |  |  |  | Practice delivery of presentation
Week 8 | Meeting with supervisor |  | Draw conclusions based on findings; think about suggestions for further research |  | Read textbook or readings; revise lecture content; practice formulas and calculations |  | Finish final draft of assignment | Read textbook or readings; revise lecture content; practice formulas and calculations | Test self on theory and formulas | Finish weekly homework 1.25% |  | Read textbook or readings; revise lecture content; practice formulas and calculations | Presentation 20% | Start research for assignment
Week 9 | Third meeting with panel |  | Write up results section |  | Read textbook or readings; revise lecture content; practice formulas and calculations |  |  | Read textbook or readings; revise lecture content; practice formulas and calculations | Test self on theory and formulas | Finish weekly homework 1.25% |  | Read textbook or readings; revise lecture content; practice formulas and calculations |  | Start writing assignment
Week 10 | Meeting with supervisor |  | Ensure whole report is coherent |  | Read textbook or readings; revise lecture content; practice formulas and calculations |  | Assignment 20% | Read textbook or readings; revise lecture content; practice formulas and calculations | Class Test 15% | Finish weekly homework 1.25% |  | Read textbook or readings; revise lecture content; practice formulas and calculations |  | Write assignment
Week 11 |  |  | Research Report due | Start preparing oral defence | Read textbook or readings; revise lecture content; practice formulas and calculations |  |  | Read textbook or readings; revise lecture content; practice formulas and calculations |  | Finish weekly homework 1.25% |  | Class Test 30% |  | Write assignment
Week 12 | Meeting with supervisor |  |  | Complete oral defence | Read textbook or readings; revise lecture content; practice formulas and calculations |  |  | Attempt past exams |  | Finish weekly homework 1.25% |  |  |  | Finish first draft of assignment
Week 13 | Fourth meeting with panel |  |  | Practice oral defence | Read textbook or readings; revise lecture content; practice formulas and calculations |  |  | Attempt past exams |  | Finish weekly homework 1.25% |  |  |  | Finish assignment
Exam Period |  |  |  | Oral Defence due | Exam 60% |  |  | Exam 55% |  |  |  |  |  | Assignment 20%

Sheet: Weekly
 | Monday | Tuesday | Wednesday | Thursday | Friday | Saturday | Sunday
7:00 – 8:00 | Breakfast | Breakfast | Breakfast | Breakfast | Breakfast
8:00 – 9:00 | Commute | Commute | Commute | Commute | Commute | Breakfast
9:00 – 10:00 | ZABC123 lab | ZQRS101 research project | ZABC123 lect | ZQRS101 research project | Study ZYYZ100 | Write first assignment draft | Breakfast
10:00 – 11:00 | ZABC123 lab | ZQRS101 research project | ZABC123 lect | ZQRS101 research project | Study ZYYZ100 | Write first assignment draft
11:00 – 12:00 | ZABC123 lab | Gym | Revise lecture notes | Gym | ZABC123 lect |  | Gym
12:00 – 13:00 | Lunch | Lunch | Lunch | Lunch | ZABC123 lect | Lunch | Lunch
13:00 – 14:00 | ZBBB100 lect | ZQRS101 research project | ZXYZ100 lect | Define variables, think about controls needed | Lunch | Training | Prep for ZBBB100 tute
14:00 – 15:00 | ZBBB100 lect | ZQRS101 research project | ZXYZ100 lect | Finalise measurement instruments | Prep for tute | Training
15:00 – 16:00 | ZBBB100 lect | ZQRS101 research project | Revise lect notes | ZBBB100 lab | ZXYZ100 tute | Training
16:00 – 17:00 | Revise lect notes | ZQRS101 research project | Commute/ dinner | ZBBB100 lab | Study ZXYZ100 | Training
17:00 – 18:00 | Commute | Commute | Training | Commute | Commute | Training
18:00 – 19:00 | Relax | Relax | Training | Relax | Relax
19:00 – 20:00 | Dinner | Dinner | Relax | Dinner | Dinner
20:00 – 21:00 |  | Read before lect | Relax | Study ZBBB100
21:00 – 22:00 |  |  | Relax
