TravMcKee/Satellite-UHF-Radio-Beacon-system/Final report/Version 3/ZEIT4501 - Summary Report - McKee z5157307.pdf

Final Project Report 2020, UNSW Canberra, ADFA

1

# Design of a small satellite UHF radio beacon for Identification, Telemetry, Tracking and Control

Travis J McKee¹

The University of New South Wales at the Australian Defence Force Academy

The reduced cost of designing, manufacturing, launching and operating small satellites has seen a significant increase in the number of objects deployed into the low earth orbit space environment. Small satellites operated by organizations with little space experience has resulted in a large failure rate, increasing the number of space debris and creating more reliance on expensive space monitoring equipment to maintain space situational awareness. The aim of this study is to provide a concept design for a self-sustained satellite radio beacon that can send a unique identification and telemetry data, independent of any satellite system failures, to multiple dispersed ground stations which allows for tracking of the satellites position through trilateration. The satellite radio beacon system allows for:
1) the collection of telemetry data for fault analysis which could decrease the current satellite failure rate; and, 2) a radio signal for tracking using cost-effective ground stations irrespective of satellite system failures to reduce the reliance on resource-expensive ground monitoring equipment. The study will utilize an agile, iterative design approach in which each component of the small satellite UHF radio beacon system (satellite radio beacon, communications link and ground receiving station) will be designed, tested and verified in sequential order. This study has produced a solderless breadboard prototype design for the satellite radio beacon that is capable of self-sustained operation in a ground environment. The communications link, using a LoRa radio module, is capable of the reliable transfer of data for the distances expected for a small satellite operational mission in a low earth orbit. The ground receiving station has proven the capability to receive the identification data, telemetry data and transmit a command for satellite control. Further investigation to reduce the uncertainty in the time measurement techniques by the ground receiving station is required to create an accurate tracking capability which would allow the continued development of the satellite radio beacon system.

Contents
I. | Introduction | 3
II. Aim | 3
III. Background | 4
IV. The present study | 4
| A. Satellite radio beacon segment | 4
| 1. Materials and methods | 5
| 2. Results | 5
| 3. Discussion | 6
| B. Communications link | 7
| 1. Materials and methods | 8
| 2. Results | 8
| 3. Discussion | 9
| C. Ground receiving segment | 10
| 1. Materials and methods | 10
| 2. Results | 11
| 3. Discussion | 11
V. Conclusion | 12
VI. Recommendations | 12
VII. Acknowledgements | 13
| References | 14

1
PLTOFF, School of Engineering & Information Technology. ZEIT4501 & ZEIT4297.

2

APPENDICES
Appendix A. Arduino Pro Mini processor testing method and results | A1
Appendix B. RFM96 LoRa radio module testing method and results | B1
Appendix C. Satellite radio beacons software flow chart and design considerations | C1
Appendix D. Satellite beacon electrical power regulation testing method and results | D1
Appendix E. Total beacon electrical power requirements and generation testing method and results | E1
Appendix F. Satellite beacon electrical power storage testing method and results | F1
Appendix G. Communication link testing method and results | G1
Appendix H. Communication link budget calculations | H1
Appendix I. Ground receiving station software flow chart | J1
Appendix J. Ground receiving station time measurement error investigation, testing and results | K1
Appendix K. Ground receiving station final verification testing method and results | L1

Nomenclature

Terms, Abbreviations and Acronyms:
ACMA | = Australian communications and media authority
APM | = Arduino pro mini
BW | = Bandwidth
CR | = Coding rate
CRC | = Cyclic redundancy check
EEPROM = Electrically erasable programmable read-only memory
EIRP | = Effective isotropic radiated power
FPGA | = Field-programmable gate array
FSPL | = Free-space path loss
GNSS | = Global navigation satellite system
IDE | = Integrated development environment
ISR | = Interrupt service routine
ITU | = International telecommunication union
LDO | = Low dropout
LED | = Light emitting diode
LEO | = Low earth orbit
LPWAN = Low-power wide area network NB-IoT = Narrowband – Internet of things
PPS | = Pulse per second
RF | = Radio frequency
RTL-SDR = Realtek - software defined radio
RX | = Receive
SDR | = Software defined radio
SF | = Spreading factor
SMA | = SubMiniature version a connector
SRAM | = Static random access memory
SSA | = Space situational awareness
TDOA | = Time difference of arrival
TT&C | = Telemetry, tracking and control
TX | = Transmit
UART | = Universal asynchronous receiver-transmitter
UHF | = Ultra high frequency
USB | = Universal serial bus
UTC | = Coordinated universal time

3

I. Introduction
The reduction in economic and resource cost of designing, manufacturing, and launching a small satellite has led to an increased number of small satellites being operated in the Low Earth Orbit (LEO) space environment¹ .
A greater number of objects in the LEO environment has resulted in new challenges for space situational awareness (SSA) with an increase in the number of space debris, which leads to a larger reliance on resource expensive ground station monitoring equipment to maintain situational awareness in the LEO environment. The reduced cost of launching a small satellite into the LEO environment is a result of releasing multiple small satellites from a single launch platform, this is commonly known as ride sharing. Ride sharing has resulted in upwards of 100 small satellites being released from the same launch vehicle in a small-time frame²
. This has
resulted in a reduction in SSA immediately after the launch of small satellites and throughout their operational life cycle due to difficulties in identifying individual satellites. The difficulties of identifying small satellites in the LEO space environment results in a greater demand on the limited ground-based optical and radar monitoring resources to maintain an SSA capability. The standardisation of small satellite manufacture has reduced the cost of production allowing government, educational and commercial organisations with little to no space mission experience to create and produce small satellite designs. The unique development and design process to meet the organisation requirements for each satellite has resulted in a 55% failure rate for academic institutions and a 23% failure rate for commercial industry³
. The cause of a small satellite failure is difficult to determine as the failure can reduce the quantity of satellite telemetry data available for fault-finding. A deficiency of telemetry data can result in the determination of satellite failure being contributed to several causes of possible failure (typically 5-10 possible causes). The ride sharing launch produces additional difficulties in identifying an individual satellite immediately after release by the ground monitoring stations which leads to an increase in failure rates due to difficulties in creating the initial communication link with the individual satellite⁴
. A satellite failure can result in the satellite becoming uncontrollable and/or difficult to track causing it to become a space debris object leading to an increased risk of a collision with other objects within the LEO space environment.
To reduce the small satellite failure rate, increase SSA in the LEO environment and reduce the reliance on ground monitoring equipment a solution needs to be investigated that aims to provide better methods of obtaining satellite identification and telemetry data and provide a cost-effective method of tracking space debris, active and end of life satellites in the LEO space environment.
The purpose of this project will be to design a self-sufficient, independent satellite radio beacon system that can transmit satellite identification and telemetry data and receive control commands using a UHF radio signal that is capable of being tracked using multiple geographically dispersed, cost-effective ground receiving stations. The satellite radio beacon shall primarily allow for the identification of an individual satellite after launch and its operational life cycle providing greater SSA which leads to a lower risk of collisions in the LEO environment. Multiple graphically dispersed ground mounting stations constructed using low-cost, commercially available components are to be utilised to track the satellite via the beacon radio signal allowing the existing ground-based monitoring systems to focus on other LEO space objects. The beacon will have a secondary function that can provide telemetry data for satellite on-orbit fault finding to facilitate the determination of causes of failure. Determining the actual cause of failure as opposed to having several possible causes of failure is expected to reduce the number of failures in future launches and operations. This system can be extended to include an alternative communications pathway that can be used to provide limited control of the other satellite systems to offer a redundancy system to correct on-orbit failures. Correcting an on-orbit failure can result in regaining control of the small satellite reducing the number of space debris objects in the LEO environment.
II. Aim
The aim of this project is to design and produce a ground-tested satellite UHF radio beacon prototype and a cost-effective ground monitoring station prototype that can sustain a communications link for the distances required of a satellite in LEO. In order to achieve this aim, three aspects will be investigated, firstly the satellite radio beacon that is to be a self-sustained UHF communication system capable of operating independently of all other satellite systems for the duration of the satellites operation mission (until deorbit). Secondly, the UHF communications link which must be able to support the reliable transfer of satellite identification and telemetry data up to 2000kms to support the operation and monitoring of satellites in the LEO space environment. Finally, the ground monitoring station which must be capable of capturing the satellites identification data, telemetry data, recording the precise time of arrival of the radio signal and determining its global location. The ground station will be able to pass on the captured data and measurements to a peripheral device for post processing using the time difference of arrival (TDOA) to determine the position of the satellite through trilateration calculations.

4

IV. Background
The theory of operation of the satellite beacon system is that the system contains its own power, processing and radio subsystems to ensure that it is self-contained and independent for the satellite. Each radio beacon system contains a unique identifier in the form of a 16-bit address which allows for 65,536 unique addresses to be used simultaneously. Each radio beacon processor has the capability to be linked to other systems within the satellite to allow for the collection of satellite telemetry and health data or to pass a received command to another system within the satellite. The 16-bit identification address and collected telemetry data are sent via the beacon radio to a ground receiving station to uniquely identify the small satellite and provide satellite telemetry data for tracking and fault-finding purposes. The radio beacon system can receive data from a ground receiving station to provide control of the beacon system and emergency control of the small satellite.
The ground station can receive and process the identification and
telemetry data as well as providing a precise time of arrival of the
received signal. The precise time of arrival for a unique small satellite beacon signal being received at three globally dispersed ground receiving stations allows the position of the satellite to be calculated. The global position of each ground station must be known with each station being synchronized to the same clock timing to allow for the TDOA calculation technique to approximate the satellites position as shown in Figure 1 (see right). The trilateration of position from three stations reduces the possible position of the satellite to two spatial locations with one being discarded as unfeasible due to it being below the surface of the earth.
A review of the current systems available has shown that
solutions are provided for individual aspects of SSA in the LEO

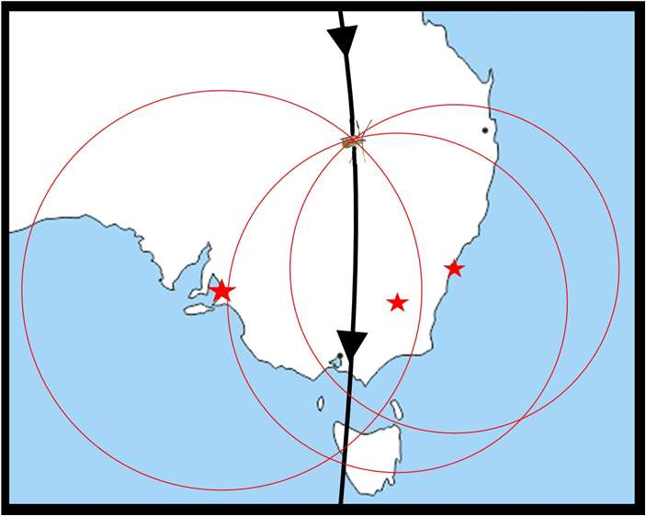
[picture p152: figure]

environment, but they do not take a holistic approach to the key parameters of a satellite telemetry, tracking and control (TT&C) system which include satellite identification. There are several systems available that provide identification (CUBIT⁵

, SOARS, Passive RF tag⁶

, ELROI⁷

and LEDSAT⁸

) or telemetry (safety radio beacon⁹ )
and some which provide identification and telemetry (HyELT, RILDOS¹⁰ and IRASAT1¹¹). The existing systems deliver solutions for one or two parameters of the TT&C system which address either, but not both problems highlighted in the introduction. The proposed satellite radio beacon system will implement solutions for all four key parameters of a TT&C system that will address both identified problems.
The major orbital parameters that will be used for this project are based on a generic small satellite mission in the LEO environment. The most common orbits for a small satellite mission are sun-synchronous with an orbital height of 300-400kms and inclination of 52° or an orbital height of 500-800kms and inclination of 98°¹² with the later parameters used for the testing of this system. The orbital parameters used for testing results in an orbital period of roughly 90 minutes with the view window of each pass being in the vicinity of 8-10 minutes in which the satellite and ground station have a slant range of between 500kms to 2000kms.
A key goal of this project is to ensure that the design of the ground monitoring station can be carried out such that the costs, difficulty of construction and the difficulty in operating the equipment is minimized. The result of minimizing these components of the design will allow a broader spectrum of the public, particularly the growing space enthusiast’s community, to create their own ground monitoring stations. This allows a larger number of ground stations that are more geographically dispersed which has a two-fold effect of increasing the footprint and tracking reliability of the ground stations and increasing the public awareness and engagement.
V. The present study
The design of the satellite radio beacon system will be broken up into three major components: the satellite radio beacon, the communication link and the ground receiving station. The satellite radio beacon contains three sub-systems: (1) Computer processing, (2) Radio transceiver, and (3) Power generation, storage, and regulation. The communication link is a standalone component while the ground receiving station will be separated into three sub-components: (1) Computer processing, (2) Radio transceiver, and (3) GNSS module.
A. Satellite Radio Beacon
The first component of the system to be investigated is the feasibility of a satellite radio beacon that is a self-sustaining system and independent of all other satellite systems. The beacon must contain its own processor, radio and power generation, storage and regulation system to ensure it is self-sustained and can continue independent operation if there is a failure in another satellite system. The major constraint for the design is that the electrical power generated can meet the electrical requirements of each sub-system. The components used in each subsystem will be selected to ensure self-sufficiency, independence, cost-efficiency, ease of operation and minimization of size and weight.

Figure 1 - Visual representation of TDOA trilateration with 3 stations


5

### 1. Materials and Methods

The first decision in the design process was to select the components for the initial design of the radio beacon with the focus being on components that have low power consumption and can meet the requirements of each sub-system. The solutions researched for the processor were a Teensy based microcontroller, an Arduino based microcontroller, a raspberry Pi and using a FPGA board with the 3.3V, 8MHz Arduino Pro Mini module (APM) using a ATMEGA328P¹³ processor being selected for the initial design. The APM was selected as it fit all the requirements of the processor system: it has a proven space heritage, it is well resourced and can be operated with a low supply voltage and clock speed to reduce power consumption. The APM module contains an in-built power regulation system using a Low Dropout (LDO) voltage regulator which will be used in the initial design. Three radio systems that are capable of long-range communications were found during the initial investigation for the radio design solution: The LoRa spread spectrum system, SIGFOX Low-Power Wide Area Network (LPWAN) system and the NB-IoT LPWAN system. The LoRa radio system¹⁴ was the selected medium for the initial design for it provided a superior point-to-point communications protocol, high immunity to noise and doppler shift, greater software support and can operate in the 70cm (430MHz, RFM96 module) and 33cm (915MHz, RFM95 module) band radio spectrum. A LoRa module breakout board designed by Boyan Nedkov¹⁵ was used to allow for compatibility with a prototyping solderless breadboard. Solar power was the only system considered for the power generation system due to the difficulties of operating other power sources (Lithium-ion batteries, hydrogen fuels cells, nuclear power, thermo-photovoltaic cells, etc.) in a space environment. The solar panel selected for ground testing is a 0.5W, monocrystalline silicon panel from Seeed¹⁶ which can produce a load output of 5.5V with a current of 90mA at 17% solar conversion efficiency. A capacitor-based energy storage system was selected for the initial design due to the launch isolation and ground testing requirements of a battery-based system.
The initial design of the satellite radio beacon system was constructed on a prototyping breadboard (refer Figure 2 to the left) using Arduino IDE¹⁷ software to operate the APM module with the LoRa radio module being driven by the
Radiohead | library | developed | by
Airspayce¹⁸. To ensure that the beacon can meet the self-sufficient and independent requirements, the initial focus of the testing was to minimize the current consumption of the beacon sub-systems to reduce the number and size of solar panels required. The first set of tests carried out were to support the investigation of minimizing the current consumption of the processing sub-system (APM module) with the testing method and results detailed in Appendix A. The next investigation was to determine methods of minimizing the current consumption of the LoRa radio module which was supported by the testing method and results shown in Appendix B. The next step in the design process was to develop the software that will be utilised in the satellite radio beacon which is based upon the software flow chart and design considerations in Appendix C. The final investigation for current consumption minimization was carried out on the power regulation system with the testing method and results presented in Appendix D. At the conclusion of the current minimization investigation, testing was carried out to determine the total current requirements of the beacon system and methods to reduce the number solar panels required for the successful operation of the satellite radio beacon system which is set out in Appendix E. The final investigation of the beacon design was to develop the electrical power storage sub-system with the testing method and results shown in Appendix F.

### 2. Results

Table 1 - Average current consumption for APM module processor and built-in regulator

A summary of the results from testing the APM module is shown above in Table 1 with the results indicating a higher than expected current measurement for the ATMEGA32P processor by 10mA for all modes, which is attributed to a green LED that constantly consumes up to 10mA when power is applied. The results show a significant increase in the APM current consumption if the supply input voltage is increased from 3.3V to 5V. The current consumed by the APM module is shown to be reduced when utilising the power saving modes of the lowpower.h library with the largest reduction occurring when the powerDown or powerSave modes are used.

Input Voltage and resistor | RAW=5.0V,1Ω | RAW=3.3V,1Ω | Vcc=3.3V,1Ω | Vcc=3.3V,10Ω | Vcc=3.3V,20Ω
power on current (mA) | 50.67 | 13.78 | 13.51 | 14.66 | 14.40
powerDown current (mA) | 42.25 | 10.00 | 10.00 | 11.43 | 11.94
powerSave current (mA) | 42.30 | 10.00 | 10.00 | 11.43 | 12.10
powerStandby current (mA) | 42.59 | 10.41 | 10.09 | 11.53 | 12.20
powerExtStandby (mA) | 42.54 | 10.41 | 10.09 | 11.53 | 12.20
idle (mA) | 46.15 | 10.86 | 10.58 | 11.94 | 12.50

### Average current consumption for APM module power modes

Figure 2 - Satellite radio beacon prototype design for initial testing

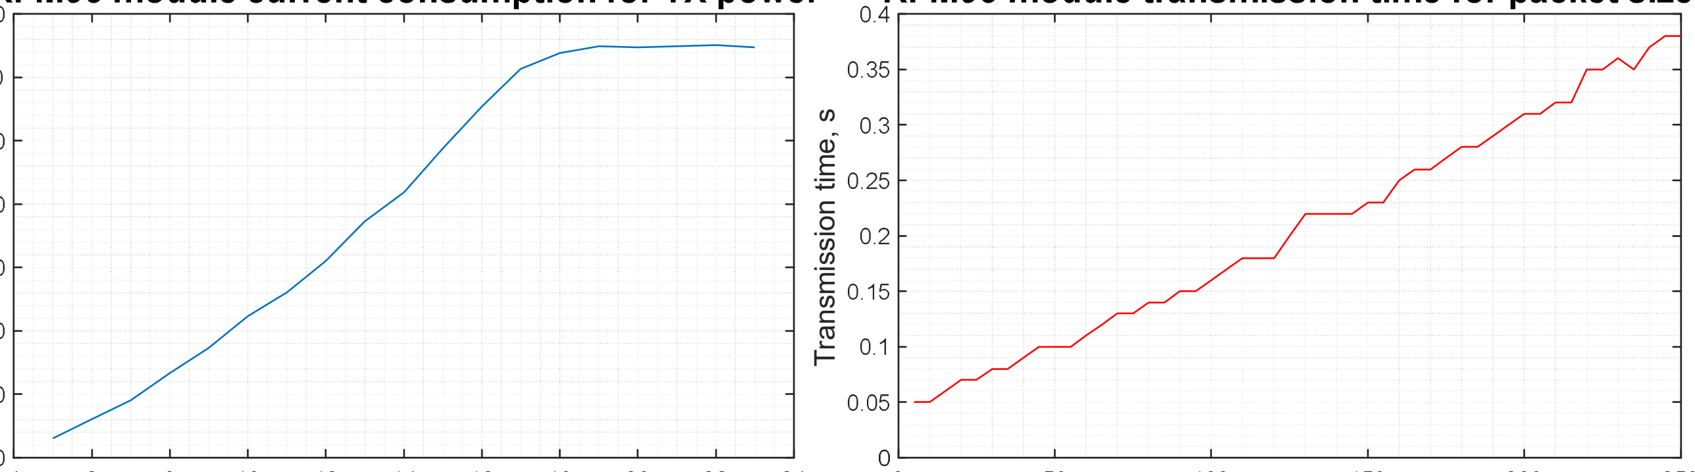
[picture p153: figure]

6

Table 2 - RFM96 LoRa module average current consumption for each mode of operation

The results for testing the current consumption of each mode of operation for the LoRa radio module is summarized above in Table 2 and the results show that the RFM96 LoRa module consumes the smallest amount of current when it is in sleep mode and the largest in the receive mode (unless radio packets are being transmitted).

Figure 3 - RFM96 module current consumption for TX power level and transmission time for radio packet size results The results of the current consumption measurements detailed above in Figure 3 shows the LoRa module current increases linearly (4.5mA/dBm) as the TX power increases until 17dBm is reached in which it plateaus at 117mA. The results indicate that the transmission time increases linearly by 10ms when the radio packet size increases by 5 bytes when using the (0) default RadioHead radio settings (medium data rate and range).

Figure 4 - Satellite radio beacon software cycle The development of the software program for the satellite radio beacon is based upon the software cycle shown above in Figure 4. The validation process of the software cycle discovered that a small number of packets were not being received by a second LoRa module (The transmission of the radio packet was verified using an RTL-SDR¹⁹ USB dongle driven by the Gqrx SDR²⁰ receiver software) with further investigation being carried out during the testing of the communications link. The receive function of the beacon software cycle was tested successfully with the radio beacon able to receive and execute a command. The APM module required 6 pins to be utilised (not including power, ground or connections for gathering telemetry data) for the successful operation of the satellite radio beacon software cycle developed.
Table 3 - Beacon total current consumption utilising different voltage regulators

The results for the regulator testing is detailed above in Table 3 and reveal that the LM1086²¹ and TS2940CZ²² LDO regulators have a much higher current consumption than the MC5205²³ LDO regulator and LM3671²⁴ Step-Down DC-DC converter (buck converter) during all phases of the software cycle. The inbuilt regulator and buck converter have similar quiescent currents throughout the software cycle except for during the transmit phase in which the LM3671 buck converter consumes 27mA less current.
Table 4 - Total current consumption measurements of the satellite radio beacon
Series resistor value (Ω) | 1 | 10 | 20
Sleep current (mA) | 0.70 | 0.62 | -0.09
Receive current (mA) | 11.00 | 10.00 | 11.67
No data transmit current (mA) | 2.00 | 2.00 | 4.40
Idle current (mA) | 2.00 | 2.00 | 2.00

### RFM96 LoRa module current

measurements for each mode Current, mA | Transmission time, s
Software cycle | MC5205 | LM1086 | LM3671 | TS2940CZ
Launch (mA) | 0.75 | 6.12 | 1.13 | 3.02
Collect Data (mA) | 7.71 | 11.76 | 5.11 | 8.30
Transmit data (mA) | 115.73 | 125.76 | 88.75 | 126.25
Receive mode (mA) | 16.62 | 20.58 | 11.67 | 17.38
Idle mode (mA) | 1.82 | 6.67 | 1.18 | 3.69
Software cycle | 1Ω resistor | 2Ω resistor | Average
Initialisation (mA) | 55.58 | 55.40 | 55.49
Launch (mA) | 1.50 | 0.75 | 1.13
Collect Data (mA) | 5.41 | 4.89 | 5.15
Transmit data (mA) | 88.75 | 88.66 | 88.70
Receive mode (mA) | 11.94 | 9.82 | 10.88
low-power mode (mA) | 1.48 | 1.12 | 1.30


7

The total current consumption of the satellite radio beacon for each phase is summarized on the previous page in Table 4 with tests showing that a single solar panel could not support operation if the TX power level were set above 10dBm without using an additional energy. When 11mF of electrolytic capacitance was used to supply energy to support the transmit phase then the radio beacon could be operated up to the maximum TX power (23dBm) when connected to one solar panel.
If the electrolytic capacitors are replaced with a single 5.5V,1F super-capacitor then the beacon system can be supported through all phases of the software cycle but a delay to the start of the software cycle was introduced. If a single super-capacitor is used, there is a 1-minute delay between when the solar panel starts to generate electrical power until there is enough energy to power all the sub-systems (2.6V potential) which increases to 8 minute and 20 seconds if the number of super-capacitors is increased to 5. The super-capacitor storage system reaches it full electrical potential after 27 minutes when the software cycle is 19 minutes into the launch phase. The average potential of the super-capacitor storage system after a one charging cycle was 6.3V which equates to 101 Joules of energy stored. The super-capacitor storage system, when fully charged, can support 1 hour and 14 minutes of beacon operations when no electrical power is being generated by the solar panels.

### 3. Discussion

The results of the investigation into the minimization of the current consumption of the satellite radio beacon has shown that the beacon is self-sustaining and can operate independent of all other satellite systems. The testing carried out found the following methods to minimize the total current consumption of the beacon system:
- Place the ATMEGA328P processor into powerDown or powerSave low power modes where possible and remove all superfluous components
- Place the LoRa radio into sleep mode where possible and reduce the length of the receive and transmit phase to the shortest time required
- Reduce the radio transmission power to as low as possible
- decrease the size of radio packets to the smallest size to transfer data
- Utilize a more efficient voltage regulator, LM3671 Buck converter

Figure 5 - Satellite beacon system configuration and connections for ground testing One solar panel could not sustain operation of the beacon system without using an electrical storage system to support the spike in current consumed during the transmit phase. The energy required to sustain a radio transmission was greater that the energy that could be supplied by one silicon solar panel. This led to the design of an energy storage system using five 1F super-capacitors that can support the maximum transmission power with one solar panel and can meet the no power to be stored requirements of the launch providers²⁵. The storage system allows for 73 minutes of beacon operation when no power is being generated in low irradiance conditions and minimizes the space required of the satellite beacon by reducing the number of solar panels. The final design for the breadboard-based satellite radio beacon prototype is shown above in Figure 5.
The software cycle developed was based upon the software flow presented in Figure 4 on page 6 which must include a 30-minute period of radio silence immediately after release from the launch vehicle to meet the requirements of the launch provider in which the delay caused by the super-capacitors can be included. The radio beacon must have the ability to accept a command to silence the radio to meet the RF spectrum requirements²⁶ set by the ACMA and ITU which dictates that the software cycle must contain a receive phase. The communication link testing is required to be conducted to determine the LoRa radio settings and the format of the radio packet data before the satellite radio beacon software code could be finalized.
The connections to the APM module required to operate the beacon are shown above in Figure 5 which allows for a combination of analogue, digital and serial connections to other satellite systems to collect telemetry data. The basic software program uses 28% of flash memory and 50% of SRAM with 22k bytes of flash memory, 1k bytes of SRAM and 1k bytes of EEPROM remaining for use in the telemetry collection programming.
A waterfall design approach for the development of the satellite radio beacon system led to each component of the system to be researched, designed and tested has ensured the beacon is self-sustained and independent from all other satellite systems. The beacon system can be constructed using a solderless breadboard with the final software configuration to be determined after the communication link testing which is the next step in the process.

8

B. Communications Link
The communications link between the satellite radio beacon and ground receiving station must be able to sustain the reliable transfer of data for the expected slant range for a satellite in LEO. The orbital parameters for the missions in the LEO environment determine that the maximum distance to be supported by the data link is 2000kms which equates to a signal free-space path loss of 151.3dB. The TX power and radio configuration settings of the LoRa module will be determined based on the results of the link budget calculations.

### 1. Materials and Methods

The first set of tests to be carried out for the communication link is to investigate the dropped radio packets that was found during the software testing and determine if there are methods to mitigate these losses. A detailed description of the methods used to carry out the testing is found in Appendix G with the tests first determining if changing the settings of the RFM96 LoRa radio module or test conditions affects the number of packets dropped, which is known as the Packet Error Rate (PER). Secondly, a set of tests were conducted to analyze the presence of bit errors in the transferred data. The final set of tests will utilize functions within the RHGenericDriver.h and RH_RF95.h files utilised in the RadioHead library that monitor the quality of transmitted and received data packets.
The next step in the communication link testing is to determine the radio settings that will allow the reliable transfer of data to a satellite in LEO. The first step was to calculate the receiver sensitivity and link budget for the default and long-range radio settings available in the RadioHead library and compare against the values from the LoRa modem calculator tool available from Semtech²⁷. A transmitter and receiver LoRa module were then connected with a series of cables and attenuators which simulate the Free Space Path Loss (FSPL) to verify the results of the calculations and determine the reliability of the transfer of data for the distance expected in an LEO mission. The methods used for testing and the results is detailed in Appendix G with the results and current RF regulations used to determine the radio settings and TX power that will be used for the final testing.
The final step in the testing of the communications link is to perform all the necessary calculations to determine the link budget and compare against the estimates of the LoRa modem calculator tool. The method in which the communications link budget was calculated is detailed in Appendix H with the results of the link budget determining the TX power level and radio settings selected for LoRa radio module during the prototype testing.
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
