TravMcKee/Satellite-UHF-Radio-Beacon-system/Additional resources/LoRa RFM95 Breadboard/RFM95LORA_Breadboard-master/conception1650624_n.jpg

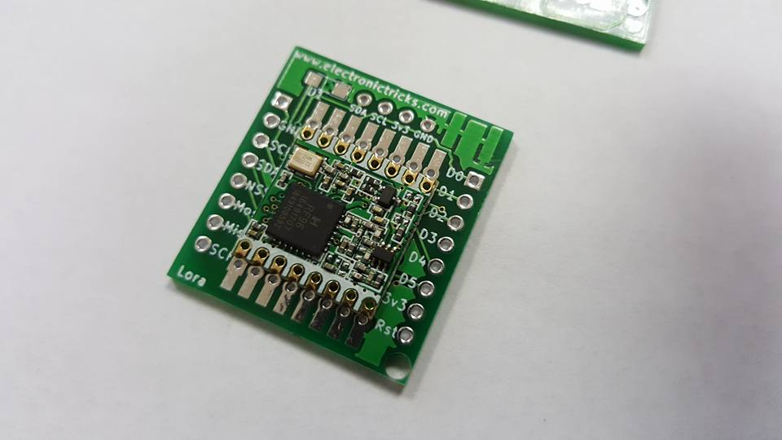
Additional resources/LoRa RFM95 Breadboard/RFM95LORA_Breadboard-master/conception1650624_n.jpg
