TravMcKee/Satellite-UHF-Radio-Beacon-system/VIVA and Interim report/VIVA Presentation/bradboard.jpg

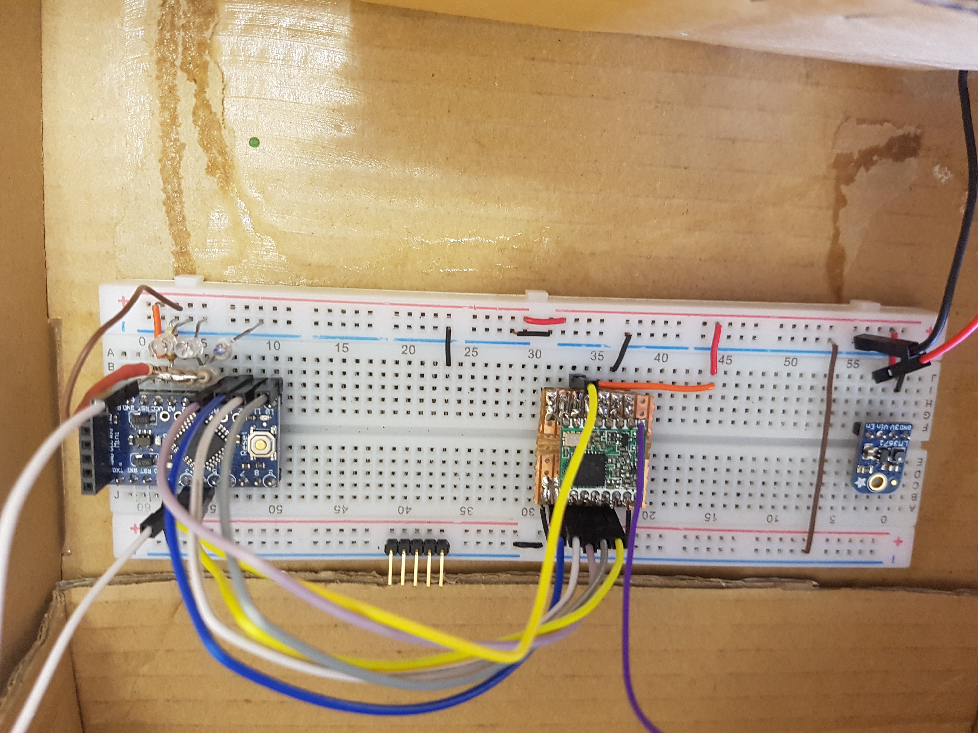
VIVA and Interim report/VIVA Presentation/bradboard.jpg
