TravMcKee/Satellite-UHF-Radio-Beacon-system/Testing/Satellite beacon testing/current draw measurements.xlsx

Sheet: power usage estimates
Estimated current consumption of the sub-systems
Software phase | Cycle time (s) | Regulation (mA) | Processor (mA) | RFM 95 (mA) | Total current (mA) | supply voltage (V) | Energy required (Joules)
Collect Data | 5 | 5 | 40 | 0.2 | 45.2 | 3.3 | 0.7458
Transmit Data | 0.1 | 5 | 10 | 73 | 88 | 3.3 | 0.02904
Receive Command | 60 | 5 | 10 | 11 | 26 | 3.3 | 5.148
Low Power mode | 300 | 5 | 1 | 0.2 | 6.2 | 3.3 | 6.138
 |  |  |  |  |  | total | 12.06084

Sheet: total current consumption
Satellite beacon total current measurements
1Ω tester resistor |  |  |  |  |  |  |  |  | Software cycle | 1Ω resistor | 2Ω resistor | Average
Cycle number | 1 | 2 | 3 | 4 | 5 | 6 | 7 | Avg | Initialisation (mA) | 55.58 | 55.40 | 55.49
Initialisation (mA) | 55.58 |  |  |  |  |  |  | 55.58 | Launch (mA) | 1.50 | 0.75 | 1.12
Launch (mA) | 1.50 |  |  |  |  |  |  | 1.50 | Collect Data (mA) | 5.41 | 4.89 | 5.15
Collect Data (mA) | 5.44 | 5.44 | 5.14 | 5.46 | 5.46 | 5.46 | 5.46 | 5.41 | Transmit data (mA) | 88.75 | 88.66 | 88.70
Transmit data (mA) | 88.83 | 88.88 | 88.70 | 88.56 | 88.56 | 88.83 | 88.88 | 88.75 | Receive mode (mA) | 11.94 | 9.82 | 10.88
Receive mode (mA) | 12.17 | 12.17 | 11.83 | 11.83 | 11.84 | 11.84 | 11.87 | 11.94 | low-power mode (mA) | 1.48 | 1.12 | 1.30
low-power mode (mA) | 1.48 | 1.48 | 1.48 | 1.48 | 1.48 | 1.48 | 1.48 | 1.48
2Ω tester resistor
Cycle number | 1 | 2 | 3 | 4 | 5 | 6 | 7 | Avg
Initialisation (mA) | 55.4 |  |  |  |  |  |  | 55.4
Launch (mA) | 0.75 |  |  |  |  |  |  | 0.75
Collect Data (mA) | 4.91 | 4.90 | 4.91 | 4.90 | 4.92 | 4.92 | 4.75 | 4.89
Transmit data (mA) | 88.56 | 88.73 | 88.73 | 88.56 | 88.73 | 88.56 | 88.73 | 88.66
Receive mode (mA) | 11.46 | 11.29 | 11.46 | 11.62 | `11.46 | 11.46 | 11.46 | 9.82
low-power mode (mA) | 1.08 | 1.08 | 1.08 | 1.08 | 1.24 | 1.25 | 1.00 | 1.12

Sheet: Regulator checks
Satellite beacon current consumption using different regulators
MC5205 in-built regulator - 1 Ohm resistor |  |  |  |  |  |  |  |  |  | MC5205 in-built regulator - 2 Ohm resistor |  |  |  |  |  |  |  |  |  | Software cycle | MC5205 | LM1086 | LM3671 | TS2940CZ
Cycle number | 1 | 2 | 3 | 4 | 5 | 6 | 7 | 8 | Avg | Cycle number | 1 | 2 | 3 | 4 | 5 | 6 | 7 | 8 | Avg | Launch (mA) | 0.75 | 6.12 | 1.13 | 3.02
Launch (mA) | 1.51 |  |  |  |  |  |  |  | 1.51 | Launch (mA) | 0..4 |  |  |  |  |  |  |  | 0.00 | Collect Data (mA) | 7.71 | 11.76 | 5.11 | 8.30
Collect Data (mA) | 8.48 | 8.15 | 8.15 | 7.82 | 7.82 | 8.15 | 8.07 | 8.14 | 8.10 | Collect Data (mA) | 7.43 | 7.26 | 7.26 | 7.26 | 7.26 | 7.43 | 7.26 | 7.44 | 7.33 | Transmit data (mA) | 115.72 | 125.76 | 88.75 | 126.25
Transmit data (mA) | 116.70 | 116.00 | 116.00 | 116.00 | 116.00 | 115.70 | 116.00 | 116.00 | 116.05 | Transmit data (mA) | 115.40 | 115.40 | 115.40 | 115.40 | 115.40 | 115.40 | 115.40 | 115.40 | 115.40 | Receive mode (mA) | 16.62 | 20.58 | 11.67 | 17.38
Receive mode (mA) | 17.20 | 16.87 | 16.86 | 16.86 | 16.86 | 16.86 | 16.87 | 16.86 | 16.91 | Receive mode (mA) | 16.32 | 16.31 | 16.32 | 16.32 | 16.48 | 16.32 | 16.32 | 16.32 | 16.34 | Idle mode (mA) | 1.82 | 6.67 | 1.18 | 3.69
Idle mode (mA) | 2.13 | 2.13 | 1.79 | 2.13 | 2.13 | 2.14 | 1.80 | 2.13 | 2.05 | Idle mode (mA) | 1.73 | 1.57 | 1.56 | 1.40 | 1.74 | 1.57 | 1.57 | 1.57 | 1.59
LM1086 external regulator - 1 Ohm resistor |  |  |  |  |  |  |  |  |  | LM1086 external regulator - 2 Ohm resistor
Cycle number | 1 | 2 | 3 | 4 | 5 | 6 | 7 | 8 | Avg | Cycle number | 1 | 2 | 3 | 4 | 5 | 6 | 7 | 8 | Avg
Launch (mA) | 6.48 |  |  |  |  |  |  |  | 6.48 | Launch (mA) | 5.75 |  |  |  |  |  |  |  | 5.75
Collect Data (mA) | 11.85 | 12.17 | 11.84 | 12.18 | 12.18 | 12.18 | 12.18 | 12.18 | 12.10 | Collect Data (mA) | 11.46 | 11.29 | 11.29 | 11.46 | 11.46 | 11.61 | 11.46 | 11.29 | 11.41
Transmit data (mA) | 126.70 | 126.70 | 126.70 | 126.70 | 126.70 | 126.70 | 126.70 | 126.40 | 126.66 | Transmit data (mA) | 124.90 | 124.90 | 124.80 | 124.80 | 124.80 | 124.90 | 124.90 | 124.80 | 124.85
Receive mode (mA) | 20.89 | 20.88 | 20.89 | 20.89 | 20.89 | 20.89 | 20.88 | 20.89 | 20.89 | Receive mode (mA) | 20.34 | 20.34 | 20.17 | 20.34 | 20.34 | 20.34 | 20.18 | 20.17 | 20.28
Idle mode (mA) | 6.81 | 7.15 | 7.14 | 7.15 | 6.82 | 6.82 | 7.15 | 7.15 | 7.02 | Idle mode (mA) | 6.42 | 6.26 | 6.25 | 6.26 | 6.43 | 6.25 | 6.43 | 6.26 | 6.32
LM3671 external regulator - 1 Ohm resistor |  |  |  |  |  |  |  |  |  | LM3671 external regulator - 2 Ohm resistor
Cycle number | 1 | 2 | 3 | 4 | 5 | 6 | 7 | 8 | Avg | Cycle number | 1 | 2 | 3 | 4 | 5 | 6 | 7 | 8 | Avg
Launch (mA) | 1.51 |  |  |  |  |  |  |  | 1.51 | Launch (mA) | 0.75 |  |  |  |  |  |  |  | 0.75
Collect Data (mA) | 5.47 | 5.45 | 5.47 | 5.13 | 5.46 | 5.13 | 5.12 | 5.15 | 5.30 | Collect Data (mA) | 4.91 | 4.92 | 4.91 | 4.91 | 5.08 | 4.91 | 4.75 | 4.91 | 4.91
Transmit data (mA) | 88.83 | 88.83 | 88.49 | 88.83 | 88.83 | 88.83 | 88.83 | 88.82 | 88.79 | Transmit data (mA) | 88.73 | 88.73 | 88.73 | 88.73 | 88.73 | 88.73 | 88.56 | 88.73 | 88.71
Receive mode (mA) | 11.83 | 11.83 | 11.83 | 11.83 | 11.84 | 11.83 | 11.83 | 11.84 | 11.83 | Receive mode (mA) | 11.46 | 11.46 | 11.46 | 11.62 | 11.63 | 11.46 | 11.46 | 11.46 | 11.50
Idle mode (mA) | 1.48 | 1.49 | 1.14 | 1.13 | 1.15 | 1.15 | 1.48 | 1.15 | 1.27 | Idle mode (mA) | 1.08 | 1.08 | 1.08 | 1.41 | 1.08 | 0.91 | 1.08 | 1.08 | 1.10
TS2940CZ external regulator - 1 Ohm resistor |  |  |  |  |  |  |  |  |  | TS2940CZ external regulator - 2 Ohm resistor
Cycle number | 1 | 2 | 3 | 4 | 5 | 6 | 7 | 8 | Avg | Cycle number | 1 | 2 | 3 | 4 | 5 | 6 | 7 | 8 | Avg
Launch (mA) | 3.47 |  |  |  |  |  |  |  | 3.47 | Launch (mA) | 2.58 |  |  |  |  |  |  |  | 2.58
Collect Data (mA) | 9.16 | 9.16 | 9.17 | 9.17 | 9.50 | 9.49 | 9.16 | 9.16 | 9.25 | Collect Data (mA) | 7.42 | 7.43 | 7.26 | 7.26 | 7.43 | 7.43 | 7.26 | 7.29 | 7.35
Transmit data (mA) | 127.40 | 127.40 | 127.00 | 127.40 | 127.40 | 127.40 | 127.40 | 127.40 | 127.35 | Transmit data (mA) | 125.10 | 125.30 | 125.10 | 124.90 | 125.10 | 125.10 | 125.30 | 125.30 | 125.15
Receive mode (mA) | 17.87 | 18.21 | 18.20 | 18.21 | 18.21 | 18.20 | 18.21 | 18.21 | 18.17 | Receive mode (mA) | 16.31 | 18.32 | 16.48 | 16.32 | 16.32 | 16.32 | 16.32 | 16.32 | 16.59
Idle mode (mA) | 3.81 | 3.80 | 5.08 | 4.14 | 4.13 | 4.14 | 3.81 | 3.80 | 4.09 | Idle mode (mA) | 3.24 | 3.25 | 3.24 | 3.25 | 3.42 | 3.41 | 3.24 | 3.25 | 3.29

Sheet: solar panel check
Satellite beacon total current measurements
3 Solar panels connected - Solar panel current |  |  |  |  |  |  |  |  | Software cycle | 3 panels | 2 panels | Average
Cycle number | 1 | 2 | 3 | 4 | 5 | 6 | 7 | Avg | Initialisation (mA) | 71.65 | 74.35 | 73.00
Initialisation (mA) | 71.65 |  |  |  |  |  |  | 71.65 | Launch (mA) | 3.67 | 3.67 | 3.67
Launch (mA) | 3.67 |  |  |  |  |  |  | 3.67 | Collect Data (mA) | 6.32 | 7.04 | 6.68
Collect Data (mA) | 6.47 | 6.13 | 6.13 | 6.47 | 6.47 | 6.13 | 6.47 | 6.32 | Transmit data (mA) | 66.70 | 68.09 | 67.39
Transmit data (mA) | 66.27 | 66.61 | 66.61 | 66.61 | 66.94 | 66.94 | 66.94 | 66.70 | Receive mode (mA) | 18.56 | 18.01 | 18.28
Receive mode (mA) | 17.13 | 17.13 | 17.13 | 17.13 | 17.13 | 17.13 | 27.13 | 18.56 | low-power mode (mA) | 3.34 | 7.68 | 5.51
low-power mode (mA) | 3.34 | 3.34 | 3.34 | 3.34 | 3.34 | 3.34 | 3.34 | 3.34
2 Solar panels connected - Solar panel current
Cycle number | 1 | 2 | 3 | 4 | 5 | 6 | 7 | Avg
Initialisation (mA) | 74.35 |  |  |  |  |  |  | 74.35
Launch (mA) | 3.67 |  |  |  |  |  |  | 3.67
Collect Data (mA) | 7.01 | 7.08 | 7.10 | 7.07 | 6.98 | 7.10 | 6.96 | 7.04
Transmit data (mA) | 68.97 | 67.80 | 67.92 | 68.02 | 68.02 | 68.00 | 67.88 | 68.09
Receive mode (mA) | 18.14 | 17.96 | 18.02 | 17.96 | 17.96 | 18.04 | 17.98 | 18.01
low-power mode (mA) | 3.36 | 3.34 | 3.38 | 3.34 | 13.46 | 13.42 | 13.48 | 7.68

Sheet: Solar panel and Regulator
Solar panel generation and regulator current measurements
3 Solar panels connected - Solar panel current |  |  |  |  |  |  |  |  | 3 Solar panels connected - Regulator current |  |  |  |  |  |  |  |  | Software cycle | 3 Solar panel current | 3 panel regulator current | 2 Solar panel current | 2 panel regulator current
Cycle number | 1 | 2 | 3 | 4 | 5 | 6 | 7 | Avg | Cycle number | 1 | 2 | 3 | 4 | 5 | 6 | 7 | Avg | Initialisation (mA) | 81.65 | 84.35 | 78.56 | 81.58
Initialisation (mA) | 81.65 |  |  |  |  |  |  | 81.65 | Initialisation (mA) | 78.56 |  |  |  |  |  |  | 78.56 | Launch (mA) | 13.67 | 14.06 | 11.10 | 11.10
Launch (mA) | 13.67 |  |  |  |  |  |  | 13.67 | Launch (mA) | 11.10 |  |  |  |  |  |  | 11.10 | Collect Data (mA) | 16.32 | 17.04 | 16.32 | 17.04
Collect Data (mA) | 16.47 | 16.13 | 16.13 | 16.47 | 16.47 | 16.13 | 16.47 | 16.32 | Collect Data (mA) | 16.47 | 16.47 | 16.13 | 16.13 | 16.47 | 16.13 | 16.47 | 16.32 | Transmit data (mA) | 76.70 | 78.09 | 74.15 | 78.09
Transmit data (mA) | 76.27 | 76.61 | 76.61 | 76.61 | 76.94 | 76.94 | 76.94 | 76.70 | Transmit data (mA) | 73.86 | 74.20 | 74.20 | 74.20 | 74.20 | 74.20 | 74.20 | 74.15 | Receive mode (mA) | 27.13 | 26.58 | 24.86 | 26.58
Receive mode (mA) | 27.13 | 27.13 | 27.13 | 27.13 | 27.13 | 27.13 | 27.13 | 27.13 | Receive mode (mA) | 24.86 | 24.86 | 24.86 | 24.86 | 24.86 | 24.86 | 24.86 | 24.86 | low-power mode (mA) | 13.34 | 13.40 | 11.10 | 13.40
low-power mode (mA) | 13.34 | 13.34 | 13.34 | 13.34 | 13.34 | 13.34 | 13.34 | 13.34 | low-power mode (mA) | 11.10 | 11.10 | 11.10 | 11.10 | 11.10 | 11.10 | 11.10 | 11.10
2 Solar panels connected - Solar panel current |  |  |  |  |  |  |  |  | 2 Solar panels connected - Regulator current
Cycle number | 1 | 2 | 3 | 4 | 5 | 6 | 7 | Avg | Cycle number | 1 | 2 | 3 | 4 | 5 | 6 | 7 | Avg
Initialisation (mA) | 84.35 |  |  |  |  |  |  | 84.35 | Initialisation (mA) | 81.58 |  |  |  |  |  |  | 81.58
Launch (mA) | 14.06 |  |  |  |  |  |  | 14.06 | Launch (mA) | 11.10 |  |  |  |  |  |  | 11.10
Collect Data (mA) | 17.01 | 17.08 | 17.10 | 17.07 | 16.98 | 17.10 | 16.96 | 17.04 | Collect Data (mA) | 17.01 | 17.08 | 17.10 | 17.07 | 16.98 | 17.10 | 16.96 | 17.04
Transmit data (mA) | 78.97 | 77.80 | 77.92 | 78.02 | 78.02 | 78.00 | 77.88 | 78.09 | Transmit data (mA) | 78.97 | 77.80 | 77.92 | 78.02 | 78.02 | 78.00 | 77.88 | 78.09
Receive mode (mA) | 28.14 | 27.96 | 18.02 | 27.96 | 27.96 | 28.04 | 27.98 | 26.58 | Receive mode (mA) | 28.14 | 27.96 | 18.02 | 27.96 | 27.96 | 28.04 | 27.98 | 26.58
low-power mode (mA) | 13.36 | 13.34 | 13.38 | 13.34 | 13.46 | 13.42 | 13.48 | 13.40 | low-power mode (mA) | 13.36 | 13.34 | 13.38 | 13.34 | 13.46 | 13.42 | 13.48 | 13.40

Sheet: processor power mode
Arduino Pro Mini power mode current consumption measurements and averages |  |  |  |  |  |  |  |  |  |  |  |  |  |  |  |  |  | Average current consumption for APM module power modes
1 Ohm Resistor measurement with Unregulated voltage (5V) on RAW pin |  |  |  |  |  |  |  |  | 10 Ohm Resistor measurement |  |  |  |  |  |  |  |  | Input Voltage and resistor | RAW=5.0V,1Ω | RAW=3.3V,1Ω | Vcc=3.3V,1Ω | Vcc=3.3V,10Ω | Vcc=3.3V,20Ω
Cycle number | 1 | 2 | 3 | 4 | 5 | 6 | 7 | Avg | Cycle number | 1 | 2 | 3 | 4 | 5 | 6 | 7 | Avg | power on current (mA) | 50.67 | 13.78 | 13.51 | 14.66 | 14.40
power on current (mA) | 50.76 | 50.43 | 51.10 | 51.10 | 50.09 | 50.76 | 50.43 | 50.67 | power on current (mA) | 15.00 | 14.60 | 14.60 | 14.60 | 14.60 | 14.60 | 14.60 | 14.66 | powerDown current (mA) | 42.25 | 10.00 | 10.00 | 11.43 | 11.94
powerDown current (mA) | 42.01 | 42.01 | 42.35 | 42.35 | 42.35 | 42.35 | 42.35 | 42.25 | powerDown current (mA) | 11.60 | 11.40 | 11.40 | 11.40 | 11.40 | 11.40 | 11.40 | 11.43 | powerSave current (mA) | 42.30 | 10.00 | 10.00 | 11.43 | 12.10
powerSave current (mA) | 42.01 | 42.35 | 42.35 | 42.35 | 42.35 | 42.35 | 42.35 | 42.30 | powerSave current (mA) | 11.60 | 11.40 | 11.40 | 11.40 | 11.40 | 11.40 | 11.40 | 11.43 | powerStandby current (mA) | 42.59 | 10.41 | 10.09 | 11.53 | 12.20
powerStandby current (mA) | 42.35 | 42.35 | 42.69 | 42.69 | 42.69 | 42.69 | 42.69 | 42.59 | powerStandby current (mA) | 11.70 | 11.50 | 11.50 | 11.50 | 11.50 | 11.50 | 11.50 | 11.53 | powerExtStandby (mA) | 42.54 | 10.41 | 10.09 | 11.53 | 12.20
powerExtStandby (mA) | 42.35 | 42.35 | 42.69 | 42.69 | 42.69 | 42.69 | 42.29 | 42.54 | powerExtStandby (mA) | 11.70 | 11.50 | 11.50 | 11.50 | 11.50 | 11.50 | 11.50 | 11.53 | idle (mA) | 46.15 | 10.86 | 10.58 | 11.94 | 12.50
idle (mA) | 46.05 | 45.72 | 46.05 | 46.05 | 46.39 | 46.39 | 46.39 | 46.15 | idle (mA) | 12.20 | 11.90 | 11.90 | 11.90 | 11.90 | 11.90 | 11.90 | 11.94
1 Ohm Resistor measurement with Regulated voltage (3.3V) on RAW pin |  |  |  |  |  |  |  |  | 20 Ohm Resistor measurement
Cycle number | 1 | 2 | 3 | 4 | 5 | 6 | 7 | Avg | Cycle number | 1 | 2 | 3 | 4 | 5 | 6 | 7 | Avg
power on current (mA) | 13.78 | 13.78 | 13.78 | 13.78 | 13.78 | 13.78 | 13.78 | 13.78 | power on current (mA) | 14.40 | 14.40 | 14.40 | 14.40 | 14.40 | 14.40 | 14.40 | 14.40
powerDown current (mA) | 10.09 | 10.09 | 9.76 | 10.09 | 10.09 | 9.76 | 10.09 | 10.00 | powerDown current (mA) | 11.00 | 12.10 | 12.10 | 12.10 | 12.10 | 12.10 | 12.10 | 11.94
powerSave current (mA) | 10.09 | 10.09 | 9.76 | 10.09 | 10.09 | 9.76 | 10.09 | 10.00 | powerSave current (mA) | 12.10 | 12.10 | 12.10 | 12.10 | 12.10 | 12.10 | 12.10 | 12.10
powerStandby current (mA) | 10.41 | 10.41 | 10.41 | 10.41 | 10.41 | 10.41 | 10.41 | 10.41 | powerStandby current (mA) | 12.20 | 12.20 | 12.20 | 12.20 | 12.20 | 12.20 | 12.20 | 12.20
powerExtStandby (mA) | 10.41 | 10.41 | 10.41 | 10.41 | 10.41 | 10.41 | 10.41 | 10.41 | powerExtStandby (mA) | 12.20 | 12.20 | 12.20 | 12.20 | 12.20 | 12.20 | 12.20 | 12.20
idle (mA) | 11.09 | 11.09 | 10.77 | 11.09 | 11.09 | 10.43 | 10.47 | 10.86 | idle (mA) | 12.50 | 12.50 | 12.50 | 12.50 | 12.50 | 12.50 | 12.50 | 12.50
1 Ohm Resistor measurement with Regulated voltage (3.3V) on Vcc pin
Cycle number | 1 | 2 | 3 | 4 | 5 | 6 | 7 | Avg
power on current (mA) | 13.46 | 13.46 | 13.46 | 13.46 | 13.46 | 13.80 | 13.46 | 13.51
powerDown current (mA) | 10.09 | 10.09 | 10.09 | 9.76 | 10.09 | 9.76 | 10.09 | 10.00
powerSave current (mA) | 10.09 | 10.09 | 10.09 | 9.76 | 10.09 | 9.76 | 10.09 | 10.00
powerStandby current (mA) | 10.09 | 10.09 | 10.09 | 10.09 | 10.09 | 10.09 | 10.09 | 10.09
powerExtStandby (mA) | 10.09 | 10.09 | 10.09 | 10.09 | 10.09 | 10.09 | 10.09 | 10.09
idle (mA) | 10.43 | 10.43 | 10.77 | 10.77 | 10.43 | 10.43 | 10.77 | 10.58
power on current (mA) | 13.78 | 13.78 | 13.78 | 13.78 | 13.78 | 13.78 | 13.78 | 13.78
powerDown current (mA) | 10.09 | 10.09 | 9.76 | 10.09 | 10.09 | 9.76 | 10.09 | 10.00
powerSave current (mA) | 10.09 | 10.09 | 9.76 | 10.09 | 10.09 | 9.76 | 10.09 | 10.00
powerStandby current (mA) | 10.41 | 10.41 | 10.41 | 10.41 | 10.41 | 10.41 | 10.41 | 10.41
powerExtStandby (mA) | 10.41 | 10.41 | 10.41 | 10.41 | 10.41 | 10.41 | 10.41 | 10.41
idle (mA) | 11.09 | 11.09 | 10.77 | 11.09 | 11.09 | 10.43 | 10.77 | 10.90

Sheet: radio power mode
RFM96 LoRa radio module power mode current consumption measurements |  |  |  |  |  |  |  |  |  |  | RFM96 LoRa module current measurements for each mode
1 Ohm Resistor measurement
Cycle number | 1 | 2 | 3 | 4 | 5 | 6 | 7 | 8 | 9 | AVG
Sleep current (A) | 0.00070 | 0.00070 | 0.00070 | 0.00070 | 0.00070 | 0.00070 | 0.00070 | 0.00070 | 0.00070 | 0.00070 | Series resistor value (Ω) | 1 | 10 | 20
Recieve current (A) | 0.011 | 0.011 | 0.011 | 0.011 | 0.011 | 0.011 | 0.011 | 0.011 | 0.011 | 0.011 | Sleep current (mA) | 0.70 | 0.62 | -0.09
No data transmit current (A) | 0.002 | 0.002 | 0.002 | 0.002 | 0.002 | 0.002 | 0.002 | 0.002 | 0.002 | 0.002 | Receive current (mA) | 11.00 | 10.00 | 11.67
Idle current (A) | 0.002 | 0.002 | 0.002 | 0.002 | 0.002 | 0.002 | 0.002 | 0.002 | 0.002 | 0.002 | No data transmit current (mA) | 2.00 | 2.00 | 4.40
10 Ohm Resistor measurement |  |  |  |  |  |  |  |  |  |  | Idle current (mA) | 2.00 | 2.00 | 2.00
Cycle number | 1 | 2 | 3 | 4 | 5 | 6 | 7 | 8 | 9 | AVG
Sleep current (A) | 0.00036 | 0.00070 | 0.00070 | 0.00036 | 0.00070 | 0.00070 | 0.00070 | 0.00070 | 0.00070 | 0.00062
Recieve current (A) | 0.010 | 0.010 | 0.010 | 0.010 | 0.010 | 0.010 | 0.010 | 0.010 | 0.010 | 0.010
No data transmit current (A) | 0.002 | 0.002 | 0.002 | 0.002 | 0.002 | 0.002 | 0.002 | 0.002 | 0.002 | 0.002
Idle current (A) | 0.002 | 0.002 | 0.002 | 0.002 | 0.002 | 0.002 | 0.002 | 0.002 | 0.002 | 0.002
20 Ohm Resistor measurement
Cycle number | 1 | 2 | 3 | 4 | 5 | 6 | 7 | 8 | 9 | AVG
Sleep current (A) |  |  |  | -0.00032 | -0.00015 | -0.00015 | -0.00015 | 0.00012 | 0.00012 | -0.00009
Recieve current (A) |  |  |  | 0.010 | 0.012 | 0.012 | 0.012 | 0.012 | 0.012 | 0.012
No data transmit current (A) |  |  |  | 0.002 | 0.020 | 0.001 | 0.001 | 0.001 | 0.001 | 0.004
Idle current (A) |  |  |  | 0.002 | 0.002 | 0.002 | 0.002 | 0.002 | 0.002 | 0.002
LoRa Radio power mode currents
1 Ohm Resistor measurement
Cycle number | 1 | 2 | 3 | 4 | 5 | 6 | 7 | 8 | 9 | AVG
Sleep current (mA) | 0.70000 | 0.00070 | 0.00070 | 0.00070 | 0.00070 | 0.00070 | 0.00070 | 0.00070 | 0.00070 | 0.07840
Recieve current (mA) | 0.011 | 0.011 | 0.011 | 0.011 | 0.011 | 0.011 | 0.011 | 0.011 | 0.011 | 0.011
No data transmit current (mA) | 0.002 | 0.002 | 0.002 | 0.002 | 0.002 | 0.002 | 0.002 | 0.002 | 0.002 | 0.002
Idle current (mA) | 0.002 | 0.002 | 0.002 | 0.002 | 0.002 | 0.002 | 0.002 | 0.002 | 0.002 | 0.002
10 Ohm Resistor measurement
Cycle number | 1 | 2 | 3 | 4 | 5 | 6 | 7 | 8 | 9 | AVG
Sleep current (mA) | 0.00036 | 0.00070 | 0.00070 | 0.00036 | 0.00070 | 0.00070 | 0.00070 | 0.00070 | 0.00070 | 0.00062
Recieve current (mA) | 0.010 | 0.010 | 0.010 | 0.010 | 0.010 | 0.010 | 0.010 | 0.010 | 0.010 | 0.010
No data transmit current (mA) | 0.002 | 0.002 | 0.002 | 0.002 | 0.002 | 0.002 | 0.002 | 0.002 | 0.002 | 0.002
Idle current (mA) | 0.002 | 0.002 | 0.002 | 0.002 | 0.002 | 0.002 | 0.002 | 0.002 | 0.002 | 0.002
20 Ohm Resistor measurement
Cycle number | 1 | 2 | 3 | 4 | 5 | 6 | 7 | 8 | 9 | AVG
Sleep current (mA) |  |  |  | -0.00032 | -0.00015 | -0.00015 | -0.00015 | 0.00012 | 0.00012 | -0.00009
Recieve current (mA) |  |  |  | 0.010 | 0.012 | 0.012 | 0.012 | 0.012 | 0.012 | 0.012
No data transmit current (mA) |  |  |  | 0.002 | 0.020 | 0.001 | 0.001 | 0.001 | 0.001 | 0.004
Idle current (mA) |  |  |  | 0.002 | 0.002 | 0.002 | 0.002 | 0.002 | 0.002 | 0.002

Sheet: Radio Tx power
RFM96 LoRa radio module transmit power current consumption measurements
1 Ohm Resistor - Current (Amps) |  |  |  |  |  |  |  | 10 Ohm Resistor - Current (Amps) |  |  |  |  |  |  |  | 20 Ohm Resistor - Current (Amps)
Cycle no. | 1 | 2 | 3 | 4 | 5 | 6 | Avg | Cycle no. | 1 | 2 | 3 | 4 | 5 | 6 | Avg | Cycle no. | 1 | 2 | 3 | Avg
5dB | 0.055 | 0.055 | 0.055 | 0.051 | 0.050 | 0.055 | 0.053 | 5dB | 0.050 | 0.049 | 0.054 | 0.054 | 0.054 | 0.054 | 0.052 | 5dB | 0.048 | 0.048 | 0.048 | 0.048
6dB | 0.058 | 0.058 | 0.058 | 0.058 | 0.055 | 0.053 | 0.057 | 6dB | 0.057 | 0.054 | 0.051 | 0.057 | 0.057 | 0.057 | 0.056 | 6dB | 0.050 | 0.050 | 0.051 | 0.050
7dB | 0.050 | 0.062 | 0.062 | 0.062 | 0.062 | 0.059 | 0.059 | 7dB | 0.060 | 0.060 | 0.057 | 0.054 | 0.060 | 0.060 | 0.058 | 7dB | 0.053 | 0.053 | 0.054 | 0.053
8dB | 0.059 | 0.063 | 0.066 | 0.066 | 0.066 | 0.066 | 0.064 | 8dB | 0.064 | 0.064 | 0.064 | 0.061 | 0.057 | 0.064 | 0.062 | 8dB | 0.056 | 0.056 | 0.056 | 0.056
9dB | 0.070 | 0.064 | 0.066 | 0.071 | 0.071 | 0.071 | 0.069 | 9dB | 0.066 | 0.068 | 0.068 | 0.068 | 0.065 | 0.060 | 0.066 | 9dB | 0.059 | 0.059 | 0.059 | 0.059
10dB | 0.076 | 0.076 | 0.069 | 0.071 | 0.076 | 0.076 | 0.074 | 10dB | 0.068 | 0.072 | 0.071 | 0.072 | 0.072 | 0.069 | 0.071 | 10dB | 0.063 | 0.063 | 0.064 | 0.063
11dB | 0.080 | 0.080 | 0.080 | 0.074 | 0.075 | 0.080 | 0.078 | 11dB | 0.070 | 0.070 | 0.076 | 0.076 | 0.076 | 0.076 | 0.074 | 11dB | 0.066 | 0.066 | 0.067 | 0.066
12dB | 0.086 | 0.086 | 0.086 | 0.086 | 0.079 | 0.080 | 0.084 | 12dB | 0.080 | 0.075 | 0.074 | 0.080 | 0.080 | 0.080 | 0.078 | 12dB | 0.069 |  |  | 0.069
13dB | 0.090 | 0.092 | 0.092 | 0.092 | 0.092 | 0.086 | 0.091 | 13dB | 0.086 | 0.086 | 0.080 | 0.080 | 0.086 | 0.086 | 0.084 | 13dB |  |  |  | 0.000
14dB | 0.082 | 0.096 | 0.098 | 0.098 | 0.098 | 0.098 | 0.095 | 14dB | 0.091 | 0.091 | 0.091 | 0.084 | 0.084 | 0.091 | 0.089 | 14dB |  |  |  | 0.000
15dB | 0.105 | 0.093 | 0.102 | 0.106 | 0.106 | 0.106 | 0.103 | 15dB | 0.097 | 0.097 | 0.097 | 0.097 | 0.090 | 0.089 | 0.094 | 15dB |  |  |  | 0.000
16dB | 0.113 | 0.113 | 0.100 | 0.108 | 0.113 | 0.113 | 0.110 | 16dB | 0.098 | 0.103 | 0.103 | 0.103 | 0.103 | 0.095 | 0.101 | 16dB |  |  |  | 0.000
17dB | 0.119 | 0.120 | 0.120 | 0.106 | 0.114 | 0.120 | 0.116 | 17dB | 0.097 | 0.104 | 0.109 | 0.109 | 0.109 | 0.109 | 0.106 | 17dB |  |  |  | 0.000
18dB | 0.121 | 0.122 | 0.122 | 0.122 | 0.108 | 0.116 | 0.118 | 18dB | 0.112 | 0.100 | 0.107 | 0.112 | 0.112 | 0.112 | 0.109 | 18dB |  |  |  | 0.000
19dB | 0.122 | 0.122 | 0.122 | 0.122 | 0.122 | 0.110 | 0.120 | 19dB | 0.112 | 0.113 | 0.101 | 0.107 | 0.113 | 0.113 | 0.110 | 19dB |  |  |  | 0.000
20dB | 0.104 | 0.122 | 0.122 | 0.123 | 0.123 | 0.123 | 0.119 | 20dB | 0.112 | 0.113 | 0.113 | 0.101 | 0.108 | 0.113 | 0.110 | 20dB |  |  |  | 0.000
21dB | 0.122 | 0.104 | 0.123 | 0.123 | 0.123 | 0.123 | 0.120 | 21dB | 0.112 | 0.113 | 0.113 | 0.113 | 0.102 | 0.108 | 0.110 | 21dB |  |  |  | 0.000
22dB | 0.122 | 0.123 | 0.104 | 0.122 | 0.123 | 0.123 | 0.119 | 22dB | 0.111 | 0.113 | 0.113 | 0.113 | 0.113 | 0.101 | 0.111 | 22dB |  |  |  | 0.000
23dB | 0.122 | 0.122 | 0.123 | 0.105 | 0.121 | 0.123 | 0.119 | 23dB | 0.098 | 0.111 | 0.113 | 0.113 | 0.113 | 0.113 | 0.110 | 23dB |  |  |  | 0.000

Sheet: Radio TX size power
RFM 96 LoRa Radio tranmsission time measurements
Byte Size | TX time (Sec) | Byte Size | TX time (Sec) | Byte Size | TX time (Sec) | Byte Size | TX time (Sec) | 0.047 Ohm Resistor measurement
250 | 0.38 | 185 | 0.28 | 120 | 0.18 | 55 | 0.10 | Power | Current (Amps)
245 | 0.38 | 180 | 0.28 | 115 | 0.18 | 50 | 0.10 | 5dBm | 0.024
240 | 0.37 | 175 | 0.27 | 110 | 0.18 | 45 | 0.10 | 10dBm | 0.044
235 | 0.35 | 170 | 0.26 | 105 | 0.17 | 40 | 0.09 | 15dBm | 0.074
230 | 0.36 | 165 | 0.26 | 100 | 0.16 | 35 | 0.08 | 20dBm | 0.089
225 | 0.35 | 160 | 0.25 | 95 | 0.15 | 30 | 0.08 | 1 Ohm Resistor measurement
220 | 0.35 | 155 | 0.23 | 90 | 0.15 | 25 | 0.07 | Power | Current (Amps)
215 | 0.32 | 150 | 0.23 | 85 | 0.14 | 20 | 0.07 | 5dBm | 0.023
210 | 0.32 | 145 | 0.22 | 80 | 0.14 | 15 | 0.06 | 10dBm | 0.044
205 | 0.31 | 140 | 0.22 | 75 | 0.13 | 10 | 0.05 | 15dBm | 0.073
200 | 0.31 | 135 | 0.22 | 70 | 0.13 | 5 | 0.05 | 20dBm | 0.087
195 | 0.30 | 130 | 0.22 | 65 | 0.12 |  |  | 10 Ohm Resistor measurement
190 | 0.29 | 125 | 0.20 | 60 | 0.11 |  |  | Power | Current (Amps)
 |  |  |  |  |  |  |  | 5dBm | 0.018
 |  |  |  |  |  |  |  | 10dBm | 0.034
 |  |  |  |  |  |  |  | 15dBm | 0.055
 |  |  |  |  |  |  |  | 20dBm
