TravMcKee/Satellite-UHF-Radio-Beacon-system/User guide/User guide Diagrams.pptx

Small satellite UHF identification and TT&C radio beacon

Solar Panels

RFM96 Lora Radio Module

Power Storage

Microprocessor

Power Regulation

## Adafruit Feather 32U4 with RFM96 LoRa Radio

5V

Adafruit Feather
with 32U4 processor

4

RESET

RFM96 Lora
Radio Module

7

DIO0

8

NSS

13

SCK

11

MOSI

12

MISO

GND

GND

## Arduino Pro Mini with RFM96 LoRa Radio on the Red PCB Board or Breadboard

3.3 V

Silicon solar panels

5-6 V

Power Storage

Capacitor-Based storage

Vcc

RAW

Arduino Pro Mini

4

RESET

DIO0

NSS

SCK

MOSI

MISO

GND

RFM96 Lora radio

ANT

10

2

13

11

12

GND

Tester resistor

## Arduino Pro Mini with RFM96 LoRa Radio on the Red PCB Board or Breadboard

5 V

Vcc

RAW

Arduino Pro Mini

4

RESET

DIO0

NSS

SCK

MOSI

MISO

GND

RFM96 Lora radio

ANT

10

2

13

11

12

GND

Voltage potential

Supply voltage

Tester resistor

5 V

3.3 V

ANT

Vcc

RAW

Arduino Pro Mini

4

RESET

DIO0

NSS

SCK

MOSI

MISO

GND

RFM96 Lora radio

10

2

13

11

12

GND

## Slide 5

Satellite Radio Beacon

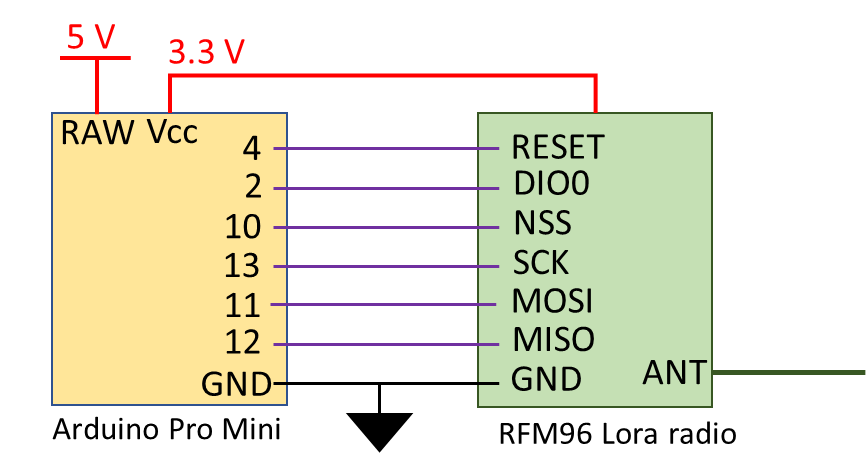
[picture p160: figure]
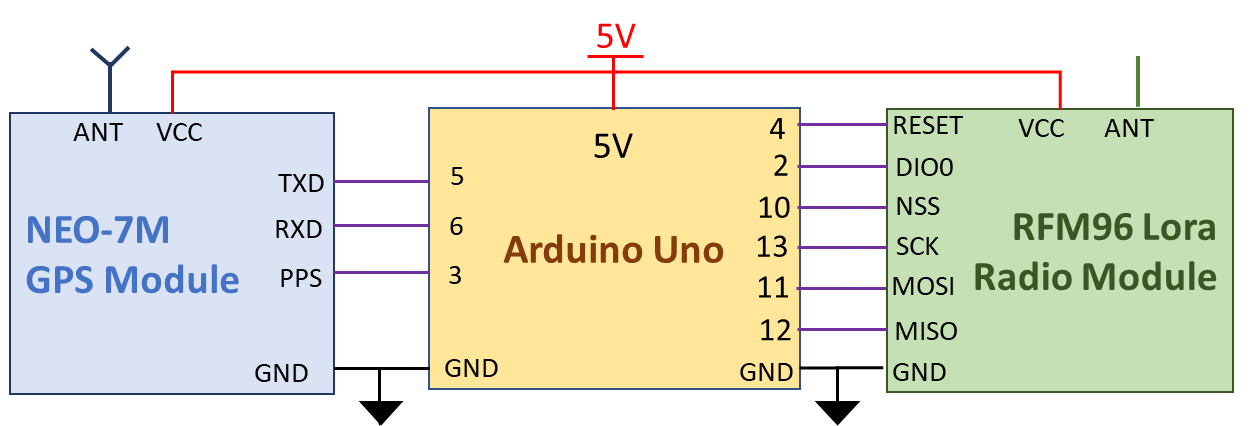
[picture p161: figure]

Ground receiving station #1

Ground receiving station #2

## Arduino Pro Mini with RFM96 LoRa Radio on the Red PCB Board or Breadboard

Supply voltage

RAW or Vcc

Arduino Pro Mini

Voltage potential

Tester resistor

## Arduino Uno with RFM96 LoRa Radio and Ublox GY-NEO6MV2 GPS module

5V

5V

NEO-7M
GPS Module

ANT

VCC

TXD

Arduino Uno

5

4

2

RESET

DIO0

RFM96 Lora
Radio Module

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
MOSI

NSS

SCK

GND

GND

GND

12

GND

MISO

## Slide 8

TX Radio
5dBm TX power

30dB

1.31dB

30dB

1.80dB

20dB

1.33dB

8dB

1.31dB

A

1.31dB

30dB

RX Radio
5dBm TX power

TX Radio
10dBm TX power

30dB

1.31dB

30dB

1.80dB

20dB

1.33dB

15dB

1.31dB

A

1.31dB

30dB

RX Radio
10dBm TX power

TX Radio
15dBm TX power

30dB

1.31dB

30dB

1.80dB

20dB

1.33dB

15dB

1.31dB

A

1.31dB

30dB

RX Radio
15dBm TX power

TX Radio
20dBm TX power

30dB

1.31dB

30dB

1.80dB

20dB

1.33dB

15dB

1.31dB

A

1.31dB

30dB

RX Radio
20dBm TX power

TX Radio
5dBm TX power

30dB

1.31dB

30dB

1.80dB

20dB

1.33dB

15dB

1.31dB

A

1.31dB

30dB

RX Radio
5dBm TX power

## Slide 9

TX Radio
Output = TX power

30dB

1.31dB

30dB

1.80dB

20dB

1.33dB

A

1.31dB

B

1.31dB

30dB

RX Radio

## RFM96 Breakout board Schematic

Ant

DIO3

DIO4

3.3V

DIO0

DIO1

DIO2

Antenna SMA plug

RFM96
Module

DIO5

RST

NSS

SCK

MOSI

MISO

GND

## Full satellite radio beacon system

LM3671 Buck converter

3.3V

ANT

Silicon solar panel

5.5 - 6.3V

Vin

GND

3.3V

GND

Arduino Pro Mini

4

RESET

DIO0

NSS

SCK

MOSI

MISO

GND

RFM96 LoRa radio module

Super-capacitor storage

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
Tester resistor

## Full satellite radio beacon system

5V power supply

Tester resistor

Power regulator

3.3V

ANT

Vin

GND

3.3V

GND

Arduino Pro Mini

4

RESET

DIO0

NSS

SCK

MOSI

MISO

GND

RFM96 LoRa radio module

10

2

13

11

12

## Slide 13

Satellite
Radio
Beacon

P_(amp)

L_(ft)

G_t

EIRP

L_(fs)

L_a

C′

G_r

Ground
Receiving
Station

G/(T_e)⇒C/N,C/(N_0),(E_b)/(N_0)

L_(fr)

2000kms

## Slide 14

Satellite launch

Processor and radio initialises

System Power Down - 30 Minutes

Collect Data

Transmit Data

Enter RX Mode – 30 seconds

Perform CMD operation if required

System Power down – 4-5 Minutes

## Slide 15

Satellite launch

Processor and radio initialises

System Power Down - 30 Minutes

Collect Data

Check Battery Voltage

Check Solar Panel Current

Transmit Data

Perform any other checks

Check Light sensing Diodes

Enter RX Mode - 1 minute

Perform CMD operation if required

System Power down – 4-5 Minutes

## Slide 16

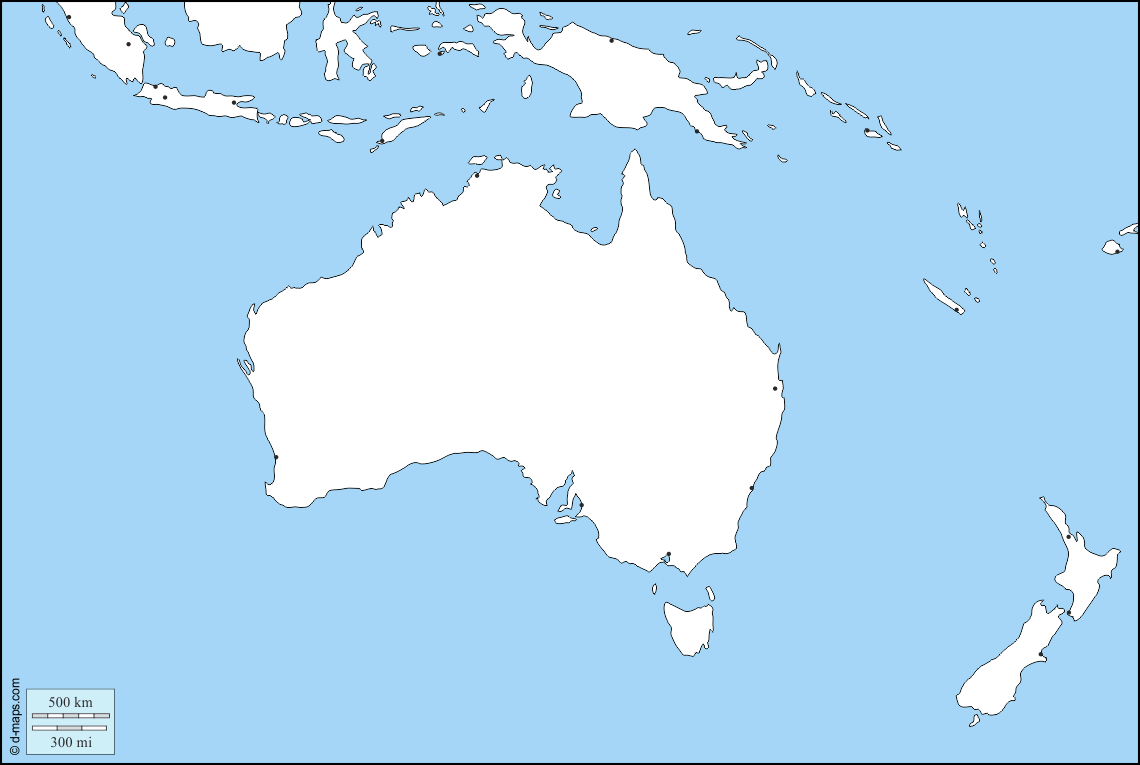
[picture p162: figure]

## Slide 17

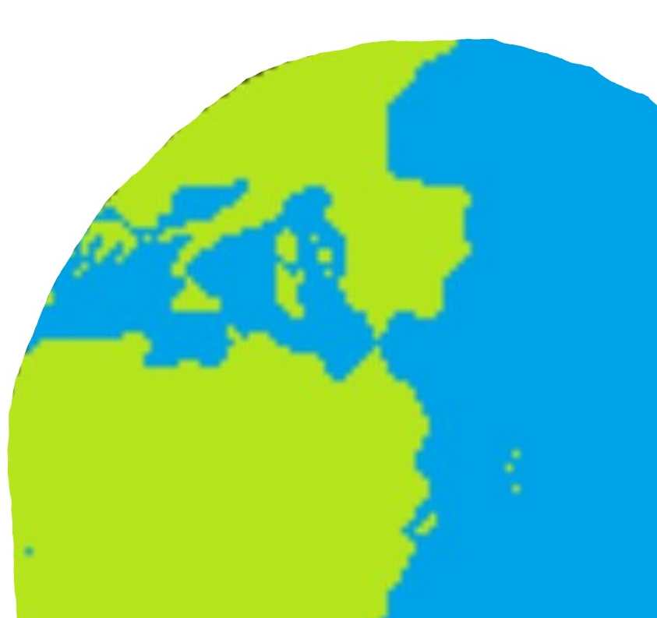
[picture p163: figure]

## Slide 18

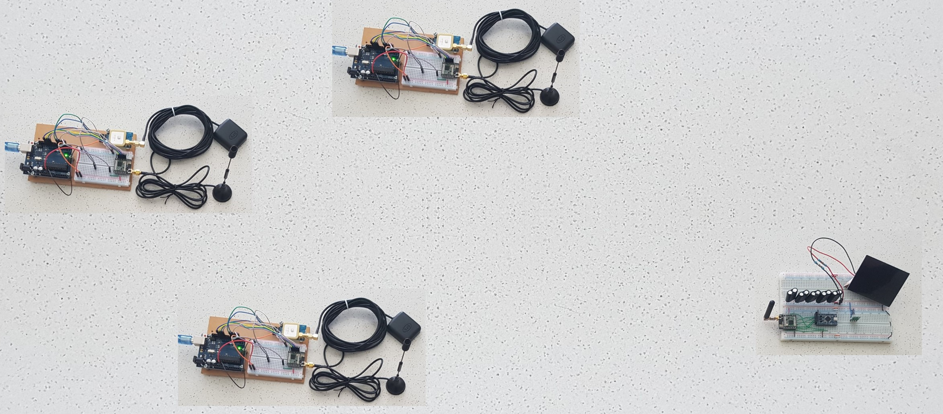
[picture p164: figure]
