TravMcKee/Satellite-UHF-Radio-Beacon-system/Testing/Satellite beacon testing/Power_Checks/POWER Testing.docx

POWER Testing

1Ω resistor – Microcontroller power modes

12:20:10.906 -> starts now

12:20:11.251 -> send radio to sleep

12:20:13.248 -> check powerDown

12:20:18.478 -> check powerSave

12:20:23.699 -> check powerStandby

12:20:28.879 -> check powerExtStandby

12:20:35.088 -> check idle

12:20:43.433 -> send radio to sleep

12:20:45.429 -> check powerDown

12:20:50.661 -> check powerSave

12:20:55.863 -> check powerStandby

12:21:01.088 -> check powerExtStandby

12:21:07.280 -> check idle

12:21:15.598 -> send radio to sleep

12:21:17.596 -> check powerDown

12:21:22.816 -> check powerSave

12:21:28.039 -> check powerStandby

12:21:33.242 -> check powerExtStandby

12:21:39.464 -> check idle

12:21:47.763 -> send radio to sleep

12:21:49.783 -> check powerDown

12:21:54.971 -> check powerSave

12:22:00.199 -> check powerStandby

12:22:05.414 -> check powerExtStandby

12:22:11.608 -> check idle

12:22:19.937 -> send radio to sleep

12:22:21.936 -> check powerDown

12:22:27.162 -> check powerSave

12:22:32.365 -> check powerStandby

12:22:37.565 -> check powerExtStandby

12:22:43.757 -> check idle

12:22:52.095 -> send radio to sleep

12:22:54.093 -> check powerDown

12:22:59.330 -> check powerSave

12:23:04.508 -> check powerStandby

12:23:09.736 -> check powerExtStandby

12:23:15.942 -> check idle

12:23:24.240 -> send radio to sleep

12:23:26.274 -> check powerDown

12:23:31.472 -> check powerSave

12:23:36.678 -> check powerStandby

12:23:41.875 -> check powerExtStandby

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

12:40:31.542 -> check powerDown

12:40:36.739 -> check powerSave

12:40:41.945 -> check powerStandby

12:40:47.138 -> check powerExtStandby

12:40:53.346 -> check idle

12:41:01.656 -> send radio to sleep

12:41:03.658 -> check powerDown

12:41:08.865 -> check powerSave

12:41:09.175 ->
