TravMcKee/Satellite-UHF-Radio-Beacon-system/Testing/Satellite beacon testing/Radio_TX_Power_checks/Radio TX Power checks.docx

Radio TX Power checks

Resistor - 1Ω - Sending 20 characters which includes end of msg/line

Transmitter

13:45:05.283 -> Feather LoRa TX Test!

13:45:05.422 -> LoRa radio init OK!

13:45:05.422 -> Set Freq to: 915.00

13:45:08.417 -> Transmitting...

13:45:09.426 -> Sending power 5

13:45:09.461 -> power Sent ------5

13:45:11.507 -> Sending power 6

13:45:11.542 -> power Sent ------6

13:45:13.583 -> Sending power 7

13:45:13.618 -> power Sent ------7

13:45:15.654 -> Sending power 8

13:45:15.688 -> power Sent ------8

13:45:17.772 -> Sending power 9

13:45:17.772 -> power Sent ------9

13:45:19.845 -> Sending power 10

13:45:19.845 -> power Sent ------10

13:45:21.913 -> Sending power 11

13:45:21.913 -> power Sent ------11

13:45:24.021 -> Sending power 12

13:45:24.021 -> power Sent ------12

13:45:26.096 -> Sending power 13

13:45:26.096 -> power Sent ------13

13:45:28.171 -> Sending power 14

13:45:28.171 -> power Sent ------14

13:45:30.251 -> Sending power 15

13:45:30.251 -> power Sent ------15

13:45:32.327 -> Sending power 16

13:45:32.327 -> power Sent ------16

13:45:34.404 -> Sending power 17

13:45:34.404 -> power Sent ------17

13:45:36.486 -> Sending power 18

13:45:36.520 -> power Sent ------18

13:45:38.561 -> Sending power 19

13:45:38.596 -> power Sent ------19

13:45:40.646 -> Sending power 20

13:45:40.681 -> power Sent ------20

13:45:42.722 -> Sending power 21

13:45:42.757 -> power Sent ------21

13:45:44.804 -> Sending power 22

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

14:19:25.316 -> power Sent ------8

14:19:27.360 -> Sending power 9

14:19:27.395 -> power Sent ------9

14:19:29.469 -> Sending power 10

14:19:29.469 -> power Sent ------10

14:19:31.534 -> Sending power 11

14:19:31.534 -> power Sent ------11

Receiver

14:19:19.102 -> Got: power Sent ------5

14:19:19.102 -> RSSI: -44

14:19:21.208 -> Got: power Sent ------6

14:19:21.208 -> RSSI: -42

14:19:23.274 -> Got: power Sent ------7

14:19:23.274 -> RSSI: -43

14:19:25.351 -> Got: power Sent ------8

14:19:25.351 -> RSSI: -42

14:19:27.430 -> Got: power Sent ------9

14:19:27.430 -> RSSI: -41

14:19:29.502 -> Got: power Sent ------10

14:19:29.502 -> RSSI: -37

14:19:31.602 -> Got: power Sent ------11

14:19:31.602 -> RSSI: -35
