TravMcKee/Satellite-UHF-Radio-Beacon-system/Testing/Satellite beacon testing/Regulator Testing/reguator test conditions.docx

Regulator test conditions

Input – 5V, 1.5A wall socket power supply

Radio settings – Tx Power 15dBm

Default (2) settings – slow & long range

- BW – 31.25kHz
- Coding rate – 4/8
- Spreading factor – 9 = 512 chips/symbol
- CRC on
