TravMcKee/Satellite-UHF-Radio-Beacon-system/Testing/Link Budget testing/Communications Link Budget Calculations.xlsx

Sheet: settings
RadioHead default setting | RadioHead default setting | LoRa module radio configuration | Bandwidth | Coding rate | Spreading factor | Preamble length | Estimated Bit rate | Estimated Link Budget with 5dBm TX power(dB) | Estimated receiver sensistivity (dBm)
(0) Bw125Cr45Sf128 | (0) | Medium range & data rate | 125 kHz | 4/5 | 7 (128 chips/symbol) | 12 | 5469 bps | 129 | -124
(2) Bw31_25Cr48Sf512 | (2) | Long range, slow data rate | 31.25 kHz | 4/8 | 10 (512 chips/symbol) | 12 | 152.59 bps | 144.4 | -139.4
(3) Bw125Cr48Sf4096 | (3) | Long range, slow data rate | 125 kHz | 4/8 | 12 (4096 chips/symbol) | 12 | 183.11 bps | 143 | -138
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
