TravMcKee/Satellite-UHF-Radio-Beacon-system/Testing/Satellite beacon testing/Solar Panel Checks.docx

Solar Panel Checks

Using 3 solar panels connected to feather with the Radio_TX_Size_Checks file where the packet size is decremented by 5 Bytes from 250 Bytes to 4 Bytes and the power increasing from 5 dBm to 20dBm in 5dBm increments. Results show that the LoRa radio transmits every 1.2 seconds approx. with nil drop out on 20Deg day in full sun

Receiver results

13:00:25.390 -> Feather LoRa RX Test!

13:00:25.518 -> LoRa radio init OK!

13:00:25.518 -> Set Freq to: 915.00

13:02:13.705 -> Got: aaaaaaaaaabbbbbbbbbbccccccccccddddddddddeeeeeeeeeeffffffffffgggggggggghhhhhhhhhhiiiiiiiiiijjjjjjjjjjkkkkkkkkkkllllllllllmmmmmmmmmmnnnnnnnnnnooooooooooppppppppppqqqqqqqqqqrrrrrrrrrrssssssssssttttttttttuuuuuuuuuuvvvvvvvvvvwwwwwwwwwwxxxxxxxxxxyyyyyyyyy

13:02:13.705 -> number of Bytes is: 250

13:02:15.091 -> Got: aaaaaaaaaabbbbbbbbbbccccccccccddddddddddeeeeeeeeeeffffffffffgggggggggghhhhhhhhhhiiiiiiiiiijjjjjjjjjjkkkkkkkkkkllllllllllmmmmmmmmmmnnnnnnnnnnooooooooooppppppppppqqqqqqqqqqrrrrrrrrrrssssssssssttttttttttuuuuuuuuuuvvvvvvvvvvwwwwwwwwwwxxxxxxxxxxyyyy

13:02:15.091 -> number of Bytes is: 245

13:02:16.511 -> Got: aaaaaaaaaabbbbbbbbbbccccccccccddddddddddeeeeeeeeeeffffffffffgggggggggghhhhhhhhhhiiiiiiiiiijjjjjjjjjjkkkkkkkkkkllllllllllmmmmmmmmmmnnnnnnnnnnooooooooooppppppppppqqqqqqqqqqrrrrrrrrrrssssssssssttttttttttuuuuuuuuuuvvvvvvvvvvwwwwwwwwwwxxxxxxxxx

13:02:16.511 -> number of Bytes is: 240

13:02:17.903 -> Got: aaaaaaaaaabbbbbbbbbbccccccccccddddddddddeeeeeeeeeeffffffffffgggggggggghhhhhhhhhhiiiiiiiiiijjjjjjjjjjkkkkkkkkkkllllllllllmmmmmmmmmmnnnnnnnnnnooooooooooppppppppppqqqqqqqqqqrrrrrrrrrrssssssssssttttttttttuuuuuuuuuuvvvvvvvvvvwwwwwwwwwwxxxx

13:02:17.903 -> number of Bytes is: 235

13:02:19.305 -> Got: aaaaaaaaaabbbbbbbbbbccccccccccddddddddddeeeeeeeeeeffffffffffgggggggggghhhhhhhhhhiiiiiiiiiijjjjjjjjjjkkkkkkkkkkllllllllllmmmmmmmmmmnnnnnnnnnnooooooooooppppppppppqqqqqqqqqqrrrrrrrrrrssssssssssttttttttttuuuuuuuuuuvvvvvvvvvvwwwwwwwww

13:02:19.305 -> number of Bytes is: 230

13:02:20.656 -> Got: aaaaaaaaaabbbbbbbbbbccccccccccddddddddddeeeeeeeeeeffffffffffgggggggggghhhhhhhhhhiiiiiiiiiijjjjjjjjjjkkkkkkkkkkllllllllllmmmmmmmmmmnnnnnnnnnnooooooooooppppppppppqqqqqqqqqqrrrrrrrrrrssssssssssttttttttttuuuuuuuuuuvvvvvvvvvvwwww

13:02:20.656 -> number of Bytes is: 225

13:02:22.050 -> Got: aaaaaaaaaabbbbbbbbbbccccccccccddddddddddeeeeeeeeeeffffffffffgggggggggghhhhhhhhhhiiiiiiiiiijjjjjjjjjjkkkkkkkkkkllllllllllmmmmmmmmmmnnnnnnnnnnooooooooooppppppppppqqqqqqqqqqrrrrrrrrrrssssssssssttttttttttuuuuuuuuuuvvvvvvvvv

13:02:22.050 -> number of Bytes is: 220

13:02:23.400 -> Got: aaaaaaaaaabbbbbbbbbbccccccccccddddddddddeeeeeeeeeeffffffffffgggggggggghhhhhhhhhhiiiiiiiiiijjjjjjjjjjkkkkkkkkkkllllllllllmmmmmmmmmmnnnnnnnnnnooooooooooppppppppppqqqqqqqqqqrrrrrrrrrrssssssssssttttttttttuuuuuuuuuuvvvv

13:02:23.400 -> number of Bytes is: 215

13:02:24.752 -> Got: aaaaaaaaaabbbbbbbbbbccccccccccddddddddddeeeeeeeeeeffffffffffgggggggggghhhhhhhhhhiiiiiiiiiijjjjjjjjjjkkkkkkkkkkllllllllllmmmmmmmmmmnnnnnnnnnnooooooooooppppppppppqqqqqqqqqqrrrrrrrrrrssssssssssttttttttttuuuuuuuuu

13:02:24.752 -> number of Bytes is: 210

13:02:26.104 -> Got: aaaaaaaaaabbbbbbbbbbccccccccccddddddddddeeeeeeeeeeffffffffffgggggggggghhhhhhhhhhiiiiiiiiiijjjjjjjjjjkkkkkkkkkkllllllllllmmmmmmmmmmnnnnnnnnnnooooooooooppppppppppqqqqqqqqqqrrrrrrrrrrssssssssssttttttttttuuuu

13:02:26.104 -> number of Bytes is: 205

13:02:27.431 -> Got: aaaaaaaaaabbbbbbbbbbccccccccccddddddddddeeeeeeeeeeffffffffffgggggggggghhhhhhhhhhiiiiiiiiiijjjjjjjjjjkkkkkkkkkkllllllllllmmmmmmmmmmnnnnnnnnnnooooooooooppppppppppqqqqqqqqqqrrrrrrrrrrssssssssssttttttttt

13:02:27.431 -> number of Bytes is: 200

13:02:28.790 -> Got: aaaaaaaaaabbbbbbbbbbccccccccccddddddddddeeeeeeeeeeffffffffffgggggggggghhhhhhhhhhiiiiiiiiiijjjjjjjjjjkkkkkkkkkkllllllllllmmmmmmmmmmnnnnnnnnnnooooooooooppppppppppqqqqqqqqqqrrrrrrrrrrsssssssssstttt

13:02:28.790 -> number of Bytes is: 195

13:02:30.084 -> Got: aaaaaaaaaabbbbbbbbbbccccccccccddddddddddeeeeeeeeeeffffffffffgggggggggghhhhhhhhhhiiiiiiiiiijjjjjjjjjjkkkkkkkkkkllllllllllmmmmmmmmmmnnnnnnnnnnooooooooooppppppppppqqqqqqqqqqrrrrrrrrrrsssssssss

13:02:30.084 -> number of Bytes is: 190

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

13:02:58.547 -> Got: aaaaaaaaaabbbbbbbbbbccccccccccddddddddddeeeeeeeeeeffffffffffgggggggggghhhh

13:02:58.547 -> number of Bytes is: 75

13:02:59.718 -> Got: aaaaaaaaaabbbbbbbbbbccccccccccddddddddddeeeeeeeeeeffffffffffggggggggg

13:02:59.718 -> number of Bytes is: 70

13:03:00.860 -> Got: aaaaaaaaaabbbbbbbbbbccccccccccddddddddddeeeeeeeeeeffffffffffgggg

13:03:00.860 -> number of Bytes is: 65

13:03:03.111 -> Got: aaaaaaaaaabbbbbbbbbbccccccccccddddddddddeeeeeeeeeeffff

13:03:03.111 -> number of Bytes is: 55

13:03:04.246 -> Got: aaaaaaaaaabbbbbbbbbbccccccccccddddddddddeeeeeeeee

13:03:04.246 -> number of Bytes is: 50

13:03:05.350 -> Got: aaaaaaaaaabbbbbbbbbbccccccccccddddddddddeeee

13:03:05.350 -> number of Bytes is: 45

13:03:06.447 -> Got: aaaaaaaaaabbbbbbbbbbccccccccccddddddddd

13:03:06.447 -> number of Bytes is: 40

13:03:07.538 -> Got: aaaaaaaaaabbbbbbbbbbccccccccccdddd

13:03:07.538 -> number of Bytes is: 35

13:03:08.655 -> Got: aaaaaaaaaabbbbbbbbbbccccccccc

13:03:08.655 -> number of Bytes is: 30

13:03:09.706 -> Got: aaaaaaaaaabbbbbbbbbbcccc

13:03:09.706 -> number of Bytes is: 25

13:03:10.801 -> Got: aaaaaaaaaabbbbbbbbb

13:03:10.801 -> number of Bytes is: 20

13:03:11.860 -> Got: aaaaaaaaaabbbb

13:03:11.860 -> number of Bytes is: 15

13:03:12.920 -> Got: aaaaaaaaa

13:03:12.920 -> number of Bytes is: 10

13:03:13.973 -> Got: aaaa

13:03:13.973 -> number of Bytes is: 5

13:03:16.398 -> Got: aaaaaaaaaabbbbbbbbbbccccccccccddddddddddeeeeeeeeeeffffffffffgggggggggghhhhhhhhhhiiiiiiiiiijjjjjjjjjjkkkkkkkkkkllllllllllmmmmmmmmmmnnnnnnnnnnooooooooooppppppppppqqqqqqqqqqrrrrrrrrrrssssssssssttttttttttuuuuuuuuuuvvvvvvvvvvwwwwwwwwwwxxxxxxxxxxyyyyyyyyy

13:03:16.398 -> number of Bytes is: 250

13:03:17.804 -> Got: aaaaaaaaaabbbbbbbbbbccccccccccddddddddddeeeeeeeeeeffffffffffgggggggggghhhhhhhhhhiiiiiiiiiijjjjjjjjjjkkkkkkkkkkllllllllllmmmmmmmmmmnnnnnnnnnnooooooooooppppppppppqqqqqqqqqqrrrrrrrrrrssssssssssttttttttttuuuuuuuuuuvvvvvvvvvvwwwwwwwwwwxxxxxxxxxxyyyy

13:03:17.804 -> number of Bytes is: 245

13:03:19.199 -> Got: aaaaaaaaaabbbbbbbbbbccccccccccddddddddddeeeeeeeeeeffffffffffgggggggggghhhhhhhhhhiiiiiiiiiijjjjjjjjjjkkkkkkkkkkllllllllllmmmmmmmmmmnnnnnnnnnnooooooooooppppppppppqqqqqqqqqqrrrrrrrrrrssssssssssttttttttttuuuuuuuuuuvvvvvvvvvvwwwwwwwwwwxxxxxxxxx

13:03:19.199 -> number of Bytes is: 240

13:03:20.580 -> Got: aaaaaaaaaabbbbbbbbbbccccccccccddddddddddeeeeeeeeeeffffffffffgggggggggghhhhhhhhhhiiiiiiiiiijjjjjjjjjjkkkkkkkkkkllllllllllmmmmmmmmmmnnnnnnnnnnooooooooooppppppppppqqqqqqqqqqrrrrrrrrrrssssssssssttttttttttuuuuuuuuuuvvvvvvvvvvwwwwwwwwwwxxxx

13:03:20.580 -> number of Bytes is: 235

13:03:21.965 -> Got: aaaaaaaaaabbbbbbbbbbccccccccccddddddddddeeeeeeeeeeffffffffffgggggggggghhhhhhhhhhiiiiiiiiiijjjjjjjjjjkkkkkkkkkkllllllllllmmmmmmmmmmnnnnnnnnnnooooooooooppppppppppqqqqqqqqqqrrrrrrrrrrssssssssssttttttttttuuuuuuuuuuvvvvvvvvvvwwwwwwwww

13:03:21.965 -> number of Bytes is: 230

13:03:23.362 -> Got: aaaaaaaaaabbbbbbbbbbccccccccccddddddddddeeeeeeeeeeffffffffffgggggggggghhhhhhhhhhiiiiiiiiiijjjjjjjjjjkkkkkkkkkkllllllllllmmmmmmmmmmnnnnnnnnnnooooooooooppppppppppqqqqqqqqqqrrrrrrrrrrssssssssssttttttttttuuuuuuuuuuvvvvvvvvvvwwww

13:03:23.362 -> number of Bytes is: 225

13:03:24.728 -> Got: aaaaaaaaaabbbbbbbbbbccccccccccddddddddddeeeeeeeeeeffffffffffgggggggggghhhhhhhhhhiiiiiiiiiijjjjjjjjjjkkkkkkkkkkllllllllllmmmmmmmmmmnnnnnnnnnnooooooooooppppppppppqqqqqqqqqqrrrrrrrrrrssssssssssttttttttttuuuuuuuuuuvvvvvvvvv

13:03:24.728 -> number of Bytes is: 220

13:03:26.092 -> Got: aaaaaaaaaabbbbbbbbbbccccccccccddddddddddeeeeeeeeeeffffffffffgggggggggghhhhhhhhhhiiiiiiiiiijjjjjjjjjjkkkkkkkkkkllllllllllmmmmmmmmmmnnnnnnnnnnooooooooooppppppppppqqqqqqqqqqrrrrrrrrrrssssssssssttttttttttuuuuuuuuuuvvvv

13:03:26.092 -> number of Bytes is: 215

13:03:27.436 -> Got: aaaaaaaaaabbbbbbbbbbccccccccccddddddddddeeeeeeeeeeffffffffffgggggggggghhhhhhhhhhiiiiiiiiiijjjjjjjjjjkkkkkkkkkkllllllllllmmmmmmmmmmnnnnnnnnnnooooooooooppppppppppqqqqqqqqqqrrrrrrrrrrssssssssssttttttttttuuuuuuuuu

13:03:27.436 -> number of Bytes is: 210

13:03:28.787 -> Got: aaaaaaaaaabbbbbbbbbbccccccccccddddddddddeeeeeeeeeeffffffffffgggggggggghhhhhhhhhhiiiiiiiiiijjjjjjjjjjkkkkkkkkkkllllllllllmmmmmmmmmmnnnnnnnnnnooooooooooppppppppppqqqqqqqqqqrrrrrrrrrrssssssssssttttttttttuuuu

13:03:28.787 -> number of Bytes is: 205

13:03:30.127 -> Got: aaaaaaaaaabbbbbbbbbbccccccccccddddddddddeeeeeeeeeeffffffffffgggggggggghhhhhhhhhhiiiiiiiiiijjjjjjjjjjkkkkkkkkkkllllllllllmmmmmmmmmmnnnnnnnnnnooooooooooppppppppppqqqqqqqqqqrrrrrrrrrrssssssssssttttttttt

13:03:30.127 -> number of Bytes is: 200

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

13:03:55.385 -> number of Bytes is: 100

13:03:56.603 -> Got: aaaaaaaaaabbbbbbbbbbccccccccccddddddddddeeeeeeeeeeffffffffffgggggggggghhhhhhhhhhiiiiiiiiiijjjj

13:03:56.603 -> number of Bytes is: 95

13:03:57.764 -> Got: aaaaaaaaaabbbbbbbbbbccccccccccddddddddddeeeeeeeeeeffffffffffgggggggggghhhhhhhhhhiiiiiiiii

13:03:57.764 -> number of Bytes is: 90

13:03:58.951 -> Got: aaaaaaaaaabbbbbbbbbbccccccccccddddddddddeeeeeeeeeeffffffffffgggggggggghhhhhhhhhhiiii

13:03:58.951 -> number of Bytes is: 85

13:04:00.119 -> Got: aaaaaaaaaabbbbbbbbbbccccccccccddddddddddeeeeeeeeeeffffffffffgggggggggghhhhhhhhh

13:04:00.119 -> number of Bytes is: 80

13:04:01.240 -> Got: aaaaaaaaaabbbbbbbbbbccccccccccddddddddddeeeeeeeeeeffffffffffgggggggggghhhh

13:04:01.240 -> number of Bytes is: 75

13:04:02.420 -> Got: aaaaaaaaaabbbbbbbbbbccccccccccddddddddddeeeeeeeeeeffffffffffggggggggg

13:04:02.420 -> number of Bytes is: 70

13:04:03.532 -> Got: aaaaaaaaaabbbbbbbbbbccccccccccddddddddddeeeeeeeeeeffffffffffgggg

13:04:03.532 -> number of Bytes is: 65

13:04:04.680 -> Got: aaaaaaaaaabbbbbbbbbbccccccccccddddddddddeeeeeeeeeefffffffff

13:04:04.680 -> number of Bytes is: 60

13:04:05.797 -> Got: aaaaaaaaaabbbbbbbbbbccccccccccddddddddddeeeeeeeeeeffff

13:04:05.797 -> number of Bytes is: 55

13:04:06.924 -> Got: aaaaaaaaaabbbbbbbbbbccccccccccddddddddddeeeeeeeee

13:04:06.924 -> number of Bytes is: 50

13:04:08.027 -> Got: aaaaaaaaaabbbbbbbbbbccccccccccddddddddddeeee

13:04:08.027 -> number of Bytes is: 45

13:04:09.162 -> Got: aaaaaaaaaabbbbbbbbbbccccccccccddddddddd

13:04:09.162 -> number of Bytes is: 40

13:04:10.222 -> Got: aaaaaaaaaabbbbbbbbbbccccccccccdddd

13:04:10.222 -> number of Bytes is: 35

13:04:11.347 -> Got: aaaaaaaaaabbbbbbbbbbccccccccc

13:04:11.347 -> number of Bytes is: 30

13:04:12.411 -> Got: aaaaaaaaaabbbbbbbbbbcccc

13:04:12.411 -> number of Bytes is: 25

13:04:13.496 -> Got: aaaaaaaaaabbbbbbbbb

13:04:13.496 -> number of Bytes is: 20

13:04:14.539 -> Got: aaaaaaaaaabbbb

13:04:14.539 -> number of Bytes is: 15

13:04:15.597 -> Got: aaaaaaaaa

13:04:15.597 -> number of Bytes is: 10

13:04:16.686 -> Got: aaaa

13:04:16.686 -> number of Bytes is: 5

13:04:19.076 -> Got: aaaaaaaaaabbbbbbbbbbccccccccccddddddddddeeeeeeeeeeffffffffffgggggggggghhhhhhhhhhiiiiiiiiiijjjjjjjjjjkkkkkkkkkkllllllllllmmmmmmmmmmnnnnnnnnnnooooooooooppppppppppqqqqqqqqqqrrrrrrrrrrssssssssssttttttttttuuuuuuuuuuvvvvvvvvvvwwwwwwwwwwxxxxxxxxxxyyyyyyyyy

13:04:19.076 -> number of Bytes is: 250

13:04:20.508 -> Got: aaaaaaaaaabbbbbbbbbbccccccccccddddddddddeeeeeeeeeeffffffffffgggggggggghhhhhhhhhhiiiiiiiiiijjjjjjjjjjkkkkkkkkkkllllllllllmmmmmmmmmmnnnnnnnnnnooooooooooppppppppppqqqqqqqqqqrrrrrrrrrrssssssssssttttttttttuuuuuuuuuuvvvvvvvvvvwwwwwwwwwwxxxxxxxxxxyyyy

13:04:20.508 -> number of Bytes is: 245

13:04:21.899 -> Got: aaaaaaaaaabbbbbbbbbbccccccccccddddddddddeeeeeeeeeeffffffffffgggggggggghhhhhhhhhhiiiiiiiiiijjjjjjjjjjkkkkkkkkkkllllllllllmmmmmmmmmmnnnnnnnnnnooooooooooppppppppppqqqqqqqqqqrrrrrrrrrrssssssssssttttttttttuuuuuuuuuuvvvvvvvvvvwwwwwwwwwwxxxxxxxxx

13:04:21.899 -> number of Bytes is: 240

13:04:23.290 -> Got: aaaaaaaaaabbbbbbbbbbccccccccccddddddddddeeeeeeeeeeffffffffffgggggggggghhhhhhhhhhiiiiiiiiiijjjjjjjjjjkkkkkkkkkkllllllllllmmmmmmmmmmnnnnnnnnnnooooooooooppppppppppqqqqqqqqqqrrrrrrrrrrssssssssssttttttttttuuuuuuuuuuvvvvvvvvvvwwwwwwwwwwxxxx

13:04:23.290 -> number of Bytes is: 235

13:04:24.676 -> Got: aaaaaaaaaabbbbbbbbbbccccccccccddddddddddeeeeeeeeeeffffffffffgggggggggghhhhhhhhhhiiiiiiiiiijjjjjjjjjjkkkkkkkkkkllllllllllmmmmmmmmmmnnnnnnnnnnooooooooooppppppppppqqqqqqqqqqrrrrrrrrrrssssssssssttttttttttuuuuuuuuuuvvvvvvvvvvwwwwwwwww

13:04:24.676 -> number of Bytes is: 230

13:04:26.051 -> Got: aaaaaaaaaabbbbbbbbbbccccccccccddddddddddeeeeeeeeeeffffffffffgggggggggghhhhhhhhhhiiiiiiiiiijjjjjjjjjjkkkkkkkkkkllllllllllmmmmmmmmmmnnnnnnnnnnooooooooooppppppppppqqqqqqqqqqrrrrrrrrrrssssssssssttttttttttuuuuuuuuuuvvvvvvvvvvwwww

13:04:26.051 -> number of Bytes is: 225

13:04:27.437 -> Got: aaaaaaaaaabbbbbbbbbbccccccccccddddddddddeeeeeeeeeeffffffffffgggggggggghhhhhhhhhhiiiiiiiiiijjjjjjjjjjkkkkkkkkkkllllllllllmmmmmmmmmmnnnnnnnnnnooooooooooppppppppppqqqqqqqqqqrrrrrrrrrrssssssssssttttttttttuuuuuuuuuuvvvvvvvvv

13:04:27.437 -> number of Bytes is: 220

13:04:28.799 -> Got: aaaaaaaaaabbbbbbbbbbccccccccccddddddddddeeeeeeeeeeffffffffffgggggggggghhhhhhhhhhiiiiiiiiiijjjjjjjjjjkkkkkkkkkkllllllllllmmmmmmmmmmnnnnnnnnnnooooooooooppppppppppqqqqqqqqqqrrrrrrrrrrssssssssssttttttttttuuuuuuuuuuvvvv

13:04:28.799 -> number of Bytes is: 215

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

13:04:53.277 -> number of Bytes is: 120

13:04:54.509 -> Got: aaaaaaaaaabbbbbbbbbbccccccccccddddddddddeeeeeeeeeeffffffffffgggggggggghhhhhhhhhhiiiiiiiiiijjjjjjjjjjkkkkkkkkkkllll

13:04:54.509 -> number of Bytes is: 115

13:04:55.686 -> Got: aaaaaaaaaabbbbbbbbbbccccccccccddddddddddeeeeeeeeeeffffffffffgggggggggghhhhhhhhhhiiiiiiiiiijjjjjjjjjjkkkkkkkkk

13:04:55.686 -> number of Bytes is: 110

13:04:56.922 -> Got: aaaaaaaaaabbbbbbbbbbccccccccccddddddddddeeeeeeeeeeffffffffffgggggggggghhhhhhhhhhiiiiiiiiiijjjjjjjjjjkkkk

13:04:56.922 -> number of Bytes is: 105

13:04:58.080 -> Got: aaaaaaaaaabbbbbbbbbbccccccccccddddddddddeeeeeeeeeeffffffffffgggggggggghhhhhhhhhhiiiiiiiiiijjjjjjjjj

13:04:58.080 -> number of Bytes is: 100

13:04:59.286 -> Got: aaaaaaaaaabbbbbbbbbbccccccccccddddddddddeeeeeeeeeeffffffffffgggggggggghhhhhhhhhhiiiiiiiiiijjjj

13:04:59.286 -> number of Bytes is: 95

13:05:00.482 -> Got: aaaaaaaaaabbbbbbbbbbccccccccccddddddddddeeeeeeeeeeffffffffffgggggggggghhhhhhhhhhiiiiiiiii

13:05:00.482 -> number of Bytes is: 90

13:05:01.646 -> Got: aaaaaaaaaabbbbbbbbbbccccccccccddddddddddeeeeeeeeeeffffffffffgggggggggghhhhhhhhhhiiii

13:05:01.646 -> number of Bytes is: 85

13:05:02.792 -> Got: aaaaaaaaaabbbbbbbbbbccccccccccddddddddddeeeeeeeeeeffffffffffgggggggggghhhhhhhhh

13:05:02.792 -> number of Bytes is: 80

13:05:03.940 -> Got: aaaaaaaaaabbbbbbbbbbccccccccccddddddddddeeeeeeeeeeffffffffffgggggggggghhhh

13:05:03.940 -> number of Bytes is: 75

13:05:05.103 -> Got: aaaaaaaaaabbbbbbbbbbccccccccccddddddddddeeeeeeeeeeffffffffffggggggggg

13:05:05.103 -> number of Bytes is: 70

13:05:06.269 -> Got: aaaaaaaaaabbbbbbbbbbccccccccccddddddddddeeeeeeeeeeffffffffffgggg

13:05:06.269 -> number of Bytes is: 65

13:05:07.374 -> Got: aaaaaaaaaabbbbbbbbbbccccccccccddddddddddeeeeeeeeeefffffffff

13:05:07.374 -> number of Bytes is: 60

13:05:08.501 -> Got: aaaaaaaaaabbbbbbbbbbccccccccccddddddddddeeeeeeeeeeffff

13:05:08.501 -> number of Bytes is: 55

13:05:09.629 -> Got: aaaaaaaaaabbbbbbbbbbccccccccccddddddddddeeeeeeeee

13:05:09.629 -> number of Bytes is: 50

13:05:10.760 -> Got: aaaaaaaaaabbbbbbbbbbccccccccccddddddddddeeee

13:05:10.760 -> number of Bytes is: 45

13:05:11.853 -> Got: aaaaaaaaaabbbbbbbbbbccccccccccddddddddd

13:05:11.853 -> number of Bytes is: 40

13:05:12.925 -> Got: aaaaaaaaaabbbbbbbbbbccccccccccdddd

13:05:12.925 -> number of Bytes is: 35

13:05:14.047 -> Got: aaaaaaaaaabbbbbbbbbbccccccccc

13:05:14.047 -> number of Bytes is: 30

13:05:15.115 -> Got: aaaaaaaaaabbbbbbbbbbcccc

13:05:15.115 -> number of Bytes is: 25

13:05:16.181 -> Got: aaaaaaaaaabbbbbbbbb

13:05:16.181 -> number of Bytes is: 20

13:05:17.232 -> Got: aaaaaaaaaabbbb

13:05:17.232 -> number of Bytes is: 15

13:05:18.337 -> Got: aaaaaaaaa

13:05:18.337 -> number of Bytes is: 10

13:05:19.384 -> Got: aaaa

13:05:19.384 -> number of Bytes is: 5

13:05:21.803 -> Got: aaaaaaaaaabbbbbbbbbbccccccccccddddddddddeeeeeeeeeeffffffffffgggggggggghhhhhhhhhhiiiiiiiiiijjjjjjjjjjkkkkkkkkkkllllllllllmmmmmmmmmmnnnnnnnnnnooooooooooppppppppppqqqqqqqqqqrrrrrrrrrrssssssssssttttttttttuuuuuuuuuuvvvvvvvvvvwwwwwwwwwwxxxxxxxxxxyyyyyyyyy

13:05:21.803 -> number of Bytes is: 250

13:05:23.192 -> Got: aaaaaaaaaabbbbbbbbbbccccccccccddddddddddeeeeeeeeeeffffffffffgggggggggghhhhhhhhhhiiiiiiiiiijjjjjjjjjjkkkkkkkkkkllllllllllmmmmmmmmmmnnnnnnnnnnooooooooooppppppppppqqqqqqqqqqrrrrrrrrrrssssssssssttttttttttuuuuuuuuuuvvvvvvvvvvwwwwwwwwwwxxxxxxxxxxyyyy

13:05:23.192 -> number of Bytes is: 245

13:05:24.597 -> Got: aaaaaaaaaabbbbbbbbbbccccccccccddddddddddeeeeeeeeeeffffffffffgggggggggghhhhhhhhhhiiiiiiiiiijjjjjjjjjjkkkkkkkkkkllllllllllmmmmmmmmmmnnnnnnnnnnooooooooooppppppppppqqqqqqqqqqrrrrrrrrrrssssssssssttttttttttuuuuuuuuuuvvvvvvvvvvwwwwwwwwwwxxxxxxxxx

13:05:24.597 -> number of Bytes is: 240

13:05:25.994 -> Got: aaaaaaaaaabbbbbbbbbbccccccccccddddddddddeeeeeeeeeeffffffffffgggggggggghhhhhhhhhhiiiiiiiiiijjjjjjjjjjkkkkkkkkkkllllllllllmmmmmmmmmmnnnnnnnnnnooooooooooppppppppppqqqqqqqqqqrrrrrrrrrrssssssssssttttttttttuuuuuuuuuuvvvvvvvvvvwwwwwwwwwwxxxx

13:05:25.994 -> number of Bytes is: 235

13:05:27.371 -> Got: aaaaaaaaaabbbbbbbbbbccccccccccddddddddddeeeeeeeeeeffffffffffgggggggggghhhhhhhhhhiiiiiiiiiijjjjjjjjjjkkkkkkkkkkllllllllllmmmmmmmmmmnnnnnnnnnnooooooooooppppppppppqqqqqqqqqqrrrrrrrrrrssssssssssttttttttttuuuuuuuuuuvvvvvvvvvvwwwwwwwww

13:05:27.371 -> number of Bytes is: 230

13:05:28.746 -> Got: aaaaaaaaaabbbbbbbbbbccccccccccddddddddddeeeeeeeeeeffffffffffgggggggggghhhhhhhhhhiiiiiiiiiijjjjjjjjjjkkkkkkkkkkllllllllllmmmmmmmmmmnnnnnnnnnnooooooooooppppppppppqqqqqqqqqqrrrrrrrrrrssssssssssttttttttttuuuuuuuuuuvvvvvvvvvvwwww

13:05:28.746 -> number of Bytes is: 225

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

13:05:51.068 -> number of Bytes is: 140

13:05:52.302 -> Got: aaaaaaaaaabbbbbbbbbbccccccccccddddddddddeeeeeeeeeeffffffffffgggggggggghhhhhhhhhhiiiiiiiiiijjjjjjjjjjkkkkkkkkkkllllllllllmmmmmmmmmmnnnn

13:05:52.302 -> number of Bytes is: 135

13:05:53.538 -> Got: aaaaaaaaaabbbbbbbbbbccccccccccddddddddddeeeeeeeeeeffffffffffgggggggggghhhhhhhhhhiiiiiiiiiijjjjjjjjjjkkkkkkkkkkllllllllllmmmmmmmmm

13:05:53.538 -> number of Bytes is: 130

13:05:54.768 -> Got: aaaaaaaaaabbbbbbbbbbccccccccccddddddddddeeeeeeeeeeffffffffffgggggggggghhhhhhhhhhiiiiiiiiiijjjjjjjjjjkkkkkkkkkkllllllllllmmmm

13:05:54.768 -> number of Bytes is: 125

13:05:55.961 -> Got: aaaaaaaaaabbbbbbbbbbccccccccccddddddddddeeeeeeeeeeffffffffffgggggggggghhhhhhhhhhiiiiiiiiiijjjjjjjjjjkkkkkkkkkklllllllll

13:05:55.961 -> number of Bytes is: 120

13:05:57.186 -> Got: aaaaaaaaaabbbbbbbbbbccccccccccddddddddddeeeeeeeeeeffffffffffgggggggggghhhhhhhhhhiiiiiiiiiijjjjjjjjjjkkkkkkkkkkllll

13:05:57.186 -> number of Bytes is: 115

13:05:58.381 -> Got: aaaaaaaaaabbbbbbbbbbccccccccccddddddddddeeeeeeeeeeffffffffffgggggggggghhhhhhhhhhiiiiiiiiiijjjjjjjjjjkkkkkkkkk

13:05:58.381 -> number of Bytes is: 110

13:05:59.584 -> Got: aaaaaaaaaabbbbbbbbbbccccccccccddddddddddeeeeeeeeeeffffffffffgggggggggghhhhhhhhhhiiiiiiiiiijjjjjjjjjjkkkk

13:05:59.584 -> number of Bytes is: 105

13:06:00.778 -> Got: aaaaaaaaaabbbbbbbbbbccccccccccddddddddddeeeeeeeeeeffffffffffgggggggggghhhhhhhhhhiiiiiiiiiijjjjjjjjj

13:06:00.778 -> number of Bytes is: 100

13:06:01.973 -> Got: aaaaaaaaaabbbbbbbbbbccccccccccddddddddddeeeeeeeeeeffffffffffgggggggggghhhhhhhhhhiiiiiiiiiijjjj

13:06:01.973 -> number of Bytes is: 95

13:06:03.170 -> Got: aaaaaaaaaabbbbbbbbbbccccccccccddddddddddeeeeeeeeeeffffffffffgggggggggghhhhhhhhhhiiiiiiiii

13:06:03.170 -> number of Bytes is: 90

13:06:04.327 -> Got: aaaaaaaaaabbbbbbbbbbccccccccccddddddddddeeeeeeeeeeffffffffffgggggggggghhhhhhhhhhiiii

13:06:04.327 -> number of Bytes is: 85

13:06:05.489 -> Got: aaaaaaaaaabbbbbbbbbbccccccccccddddddddddeeeeeeeeeeffffffffffgggggggggghhhhhhhhh

13:06:05.489 -> number of Bytes is: 80

13:06:06.633 -> Got: aaaaaaaaaabbbbbbbbbbccccccccccddddddddddeeeeeeeeeeffffffffffgggggggggghhhh

13:06:06.633 -> number of Bytes is: 75

13:06:07.783 -> Got: aaaaaaaaaabbbbbbbbbbccccccccccddddddddddeeeeeeeeeeffffffffffggggggggg

13:06:07.783 -> number of Bytes is: 70

13:06:08.933 -> Got: aaaaaaaaaabbbbbbbbbbccccccccccddddddddddeeeeeeeeeeffffffffffgggg

13:06:08.933 -> number of Bytes is: 65

13:06:10.070 -> Got: aaaaaaaaaabbbbbbbbbbccccccccccddddddddddeeeeeeeeeefffffffff

13:06:10.070 -> number of Bytes is: 60

13:06:11.184 -> Got: aaaaaaaaaabbbbbbbbbbccccccccccddddddddddeeeeeeeeeeffff

13:06:11.184 -> number of Bytes is: 55

13:06:12.303 -> Got: aaaaaaaaaabbbbbbbbbbccccccccccddddddddddeeeeeeeee

13:06:12.303 -> number of Bytes is: 50

13:06:13.435 -> Got: aaaaaaaaaabbbbbbbbbbccccccccccddddddddddeeee

13:06:13.435 -> number of Bytes is: 45

13:06:14.517 -> Got: aaaaaaaaaabbbbbbbbbbccccccccccddddddddd

13:06:14.517 -> number of Bytes is: 40

13:06:15.632 -> Got: aaaaaaaaaabbbbbbbbbbccccccccccdddd

13:06:15.632 -> number of Bytes is: 35

13:06:16.719 -> Got: aaaaaaaaaabbbbbbbbbbccccccccc

13:06:16.719 -> number of Bytes is: 30

13:06:17.819 -> Got: aaaaaaaaaabbbbbbbbbbcccc

13:06:17.819 -> number of Bytes is: 25

13:06:18.880 -> Got: aaaaaaaaaabbbbbbbbb

13:06:18.880 -> number of Bytes is: 20

13:06:19.945 -> Got: aaaaaaaaaabbbb

13:06:19.945 -> number of Bytes is: 15

13:06:21.013 -> Got: aaaaaaaaa

13:06:21.013 -> number of Bytes is: 10

13:06:22.047 -> Got: aaaa

13:06:22.047 -> number of Bytes is: 5
