TravMcKee/Satellite-UHF-Radio-Beacon-system/Testing/Satellite beacon testing/Radio_Mode_Checks/Radio mode power checks.docx

Radio mode power tests

Resistor - 20Ω - Channel 1 – MC, Channel 2 - LoRa

12:22:28.733 -> starts now

12:22:28.974 -> send radio to sleep

12:22:34.084 -> put radio in recieve mode

12:22:39.219 -> put radio in transmit mode

12:22:44.349 -> put radio in idle mode

12:22:49.440 -> send radio to sleep

12:22:54.564 -> put radio in recieve mode

12:22:59.693 -> put radio in transmit mode

12:23:04.804 -> put radio in idle mode

12:23:09.943 -> send radio to sleep

12:23:15.040 -> put radio in recieve mode

12:23:20.164 -> put radio in transmit mode

12:23:25.298 -> put radio in idle mode

12:23:30.432 -> send radio to sleep

12:23:35.539 -> put radio in recieve mode

12:23:40.663 -> put radio in transmit mode

12:23:45.795 -> put radio in idle mode

12:23:50.897 -> send radio to sleep

12:23:56.006 -> put radio in recieve mode

12:24:01.144 -> put radio in transmit mode

12:24:06.259 -> put radio in idle mode

12:24:11.369 -> send radio to sleep

12:24:16.510 -> put radio in recieve mode

Resistor - 10Ω - Channel 1 – MC, Channel 2 - LoRa

12:33:43.363 -> starts now

12:33:43.602 -> send radio to sleep

12:33:48.721 -> put radio in recieve mode

12:33:53.841 -> put radio in transmit mode

12:33:58.960 -> put radio in idle mode

12:34:04.081 -> send radio to sleep

12:34:09.215 -> put radio in recieve mode

12:34:14.316 -> put radio in transmit mode

12:34:19.461 -> put radio in idle mode

12:34:24.578 -> send radio to sleep

12:34:29.705 -> put radio in recieve mode

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

12:41:40.616 -> put radio in transmit mode

12:41:45.716 -> put radio in idle mode

12:41:50.856 -> send radio to sleep

12:41:55.938 -> put radio in recieve mode

12:42:01.083 -> put radio in transmit mode

12:42:06.188 -> put radio in idle mode

12:42:11.330 -> send radio to sleep
