TravMcKee/Satellite-UHF-Radio-Beacon-system/Testing/Satellite beacon testing/Radio_TX_Size_checks/TX packet size power checks.docx

TX packet size power checks

All resistors and powers the same messages

Transmitter

11:57:32.146 -> Feather LoRa TX Test!

11:57:32.319 -> LoRa radio init OK!

11:57:32.319 -> Set Freq to: 915.00

11:57:35.311 -> Transmitting...

11:57:36.303 -> Sending 249 Bytes

11:57:36.337 -> aaaaaaaaaabbbbbbbbbbccccccccccddddddddddeeeeeeeeeeffffffffffgggggggggghhhhhhhhhhiiiiiiiiiijjjjjjjjjjkkkkkkkkkkllllllllllmmmmmmmmmmnnnnnnnnnnooooooooooppppppppppqqqqqqqqqqrrrrrrrrrrssssssssssttttttttttuuuuuuuuuuvvvvvvvvvvwwwwwwwwwwxxxxxxxxxxyyyyyyyyy

11:57:37.958 -> Sending 244 Bytes

11:57:37.992 -> aaaaaaaaaabbbbbbbbbbccccccccccddddddddddeeeeeeeeeeffffffffffgggggggggghhhhhhhhhhiiiiiiiiiijjjjjjjjjjkkkkkkkkkkllllllllllmmmmmmmmmmnnnnnnnnnnooooooooooppppppppppqqqqqqqqqqrrrrrrrrrrssssssssssttttttttttuuuuuuuuuuvvvvvvvvvvwwwwwwwwwwxxxxxxxxxxyyyy

11:57:39.577 -> Sending 239 Bytes

11:57:39.577 -> aaaaaaaaaabbbbbbbbbbccccccccccddddddddddeeeeeeeeeeffffffffffgggggggggghhhhhhhhhhiiiiiiiiiijjjjjjjjjjkkkkkkkkkkllllllllllmmmmmmmmmmnnnnnnnnnnooooooooooppppppppppqqqqqqqqqqrrrrrrrrrrssssssssssttttttttttuuuuuuuuuuvvvvvvvvvvwwwwwwwwwwxxxxxxxxx

11:57:41.166 -> Sending 234 Bytes

11:57:41.200 -> aaaaaaaaaabbbbbbbbbbccccccccccddddddddddeeeeeeeeeeffffffffffgggggggggghhhhhhhhhhiiiiiiiiiijjjjjjjjjjkkkkkkkkkkllllllllllmmmmmmmmmmnnnnnnnnnnooooooooooppppppppppqqqqqqqqqqrrrrrrrrrrssssssssssttttttttttuuuuuuuuuuvvvvvvvvvvwwwwwwwwwwxxxx

11:57:42.748 -> Sending 229 Bytes

11:57:42.782 -> aaaaaaaaaabbbbbbbbbbccccccccccddddddddddeeeeeeeeeeffffffffffgggggggggghhhhhhhhhhiiiiiiiiiijjjjjjjjjjkkkkkkkkkkllllllllllmmmmmmmmmmnnnnnnnnnnooooooooooppppppppppqqqqqqqqqqrrrrrrrrrrssssssssssttttttttttuuuuuuuuuuvvvvvvvvvvwwwwwwwww

11:57:44.330 -> Sending 224 Bytes

11:57:44.365 -> aaaaaaaaaabbbbbbbbbbccccccccccddddddddddeeeeeeeeeeffffffffffgggggggggghhhhhhhhhhiiiiiiiiiijjjjjjjjjjkkkkkkkkkkllllllllllmmmmmmmmmmnnnnnnnnnnooooooooooppppppppppqqqqqqqqqqrrrrrrrrrrssssssssssttttttttttuuuuuuuuuuvvvvvvvvvvwwww

11:57:45.919 -> Sending 219 Bytes

11:57:45.919 -> aaaaaaaaaabbbbbbbbbbccccccccccddddddddddeeeeeeeeeeffffffffffgggggggggghhhhhhhhhhiiiiiiiiiijjjjjjjjjjkkkkkkkkkkllllllllllmmmmmmmmmmnnnnnnnnnnooooooooooppppppppppqqqqqqqqqqrrrrrrrrrrssssssssssttttttttttuuuuuuuuuuvvvvvvvvv

11:57:47.468 -> Sending 214 Bytes

11:57:47.468 -> aaaaaaaaaabbbbbbbbbbccccccccccddddddddddeeeeeeeeeeffffffffffgggggggggghhhhhhhhhhiiiiiiiiiijjjjjjjjjjkkkkkkkkkkllllllllllmmmmmmmmmmnnnnnnnnnnooooooooooppppppppppqqqqqqqqqqrrrrrrrrrrssssssssssttttttttttuuuuuuuuuuvvvv

11:57:48.990 -> Sending 209 Bytes

11:57:49.024 -> aaaaaaaaaabbbbbbbbbbccccccccccddddddddddeeeeeeeeeeffffffffffgggggggggghhhhhhhhhhiiiiiiiiiijjjjjjjjjjkkkkkkkkkkllllllllllmmmmmmmmmmnnnnnnnnnnooooooooooppppppppppqqqqqqqqqqrrrrrrrrrrssssssssssttttttttttuuuuuuuuu

11:57:50.541 -> Sending 204 Bytes

11:57:50.541 -> aaaaaaaaaabbbbbbbbbbccccccccccddddddddddeeeeeeeeeeffffffffffgggggggggghhhhhhhhhhiiiiiiiiiijjjjjjjjjjkkkkkkkkkkllllllllllmmmmmmmmmmnnnnnnnnnnooooooooooppppppppppqqqqqqqqqqrrrrrrrrrrssssssssssttttttttttuuuu

11:57:52.022 -> Sending 199 Bytes

11:57:52.057 -> aaaaaaaaaabbbbbbbbbbccccccccccddddddddddeeeeeeeeeeffffffffffgggggggggghhhhhhhhhhiiiiiiiiiijjjjjjjjjjkkkkkkkkkkllllllllllmmmmmmmmmmnnnnnnnnnnooooooooooppppppppppqqqqqqqqqqrrrrrrrrrrssssssssssttttttttt

11:57:53.535 -> Sending 194 Bytes

11:57:53.570 -> aaaaaaaaaabbbbbbbbbbccccccccccddddddddddeeeeeeeeeeffffffffffgggggggggghhhhhhhhhhiiiiiiiiiijjjjjjjjjjkkkkkkkkkkllllllllllmmmmmmmmmmnnnnnnnnnnooooooooooppppppppppqqqqqqqqqqrrrrrrrrrrsssssssssstttt

11:57:55.049 -> Sending 189 Bytes

11:57:55.049 -> aaaaaaaaaabbbbbbbbbbccccccccccddddddddddeeeeeeeeeeffffffffffgggggggggghhhhhhhhhhiiiiiiiiiijjjjjjjjjjkkkkkkkkkkllllllllllmmmmmmmmmmnnnnnnnnnnooooooooooppppppppppqqqqqqqqqqrrrrrrrrrrsssssssss

11:57:56.528 -> Sending 184 Bytes

11:57:56.528 -> aaaaaaaaaabbbbbbbbbbccccccccccddddddddddeeeeeeeeeeffffffffffgggggggggghhhhhhhhhhiiiiiiiiiijjjjjjjjjjkkkkkkkkkkllllllllllmmmmmmmmmmnnnnnnnnnnooooooooooppppppppppqqqqqqqqqqrrrrrrrrrrssss

11:57:57.978 -> Sending 179 Bytes

11:57:58.013 -> aaaaaaaaaabbbbbbbbbbccccccccccddddddddddeeeeeeeeeeffffffffffgggggggggghhhhhhhhhhiiiiiiiiiijjjjjjjjjjkkkkkkkkkkllllllllllmmmmmmmmmmnnnnnnnnnnooooooooooppppppppppqqqqqqqqqqrrrrrrrrr

11:57:59.429 -> Sending 174 Bytes

11:57:59.464 -> aaaaaaaaaabbbbbbbbbbccccccccccddddddddddeeeeeeeeeeffffffffffgggggggggghhhhhhhhhhiiiiiiiiiijjjjjjjjjjkkkkkkkkkkllllllllllmmmmmmmmmmnnnnnnnnnnooooooooooppppppppppqqqqqqqqqqrrrr

11:58:00.879 -> Sending 169 Bytes

11:58:00.879 -> aaaaaaaaaabbbbbbbbbbccccccccccddddddddddeeeeeeeeeeffffffffffgggggggggghhhhhhhhhhiiiiiiiiiijjjjjjjjjjkkkkkkkkkkllllllllllmmmmmmmmmmnnnnnnnnnnooooooooooppppppppppqqqqqqqqq

11:58:02.295 -> Sending 164 Bytes

11:58:02.330 -> aaaaaaaaaabbbbbbbbbbccccccccccddddddddddeeeeeeeeeeffffffffffgggggggggghhhhhhhhhhiiiiiiiiiijjjjjjjjjjkkkkkkkkkkllllllllllmmmmmmmmmmnnnnnnnnnnooooooooooppppppppppqqqq

11:58:03.704 -> Sending 159 Bytes

11:58:03.739 -> aaaaaaaaaabbbbbbbbbbccccccccccddddddddddeeeeeeeeeeffffffffffgggggggggghhhhhhhhhhiiiiiiiiiijjjjjjjjjjkkkkkkkkkkllllllllllmmmmmmmmmmnnnnnnnnnnooooooooooppppppppp

11:58:05.121 -> Sending 154 Bytes

11:58:05.155 -> aaaaaaaaaabbbbbbbbbbccccccccccddddddddddeeeeeeeeeeffffffffffgggggggggghhhhhhhhhhiiiiiiiiiijjjjjjjjjjkkkkkkkkkkllllllllllmmmmmmmmmmnnnnnnnnnnoooooooooopppp

11:58:06.504 -> Sending 149 Bytes

11:58:06.539 -> aaaaaaaaaabbbbbbbbbbccccccccccddddddddddeeeeeeeeeeffffffffffgggggggggghhhhhhhhhhiiiiiiiiiijjjjjjjjjjkkkkkkkkkkllllllllllmmmmmmmmmmnnnnnnnnnnooooooooo

11:58:07.886 -> Sending 144 Bytes

11:58:07.886 -> aaaaaaaaaabbbbbbbbbbccccccccccddddddddddeeeeeeeeeeffffffffffgggggggggghhhhhhhhhhiiiiiiiiiijjjjjjjjjjkkkkkkkkkkllllllllllmmmmmmmmmmnnnnnnnnnnoooo

11:58:09.264 -> Sending 139 Bytes

11:58:09.264 -> aaaaaaaaaabbbbbbbbbbccccccccccddddddddddeeeeeeeeeeffffffffffgggggggggghhhhhhhhhhiiiiiiiiiijjjjjjjjjjkkkkkkkkkkllllllllllmmmmmmmmmmnnnnnnnnn

11:58:10.613 -> Sending 134 Bytes

11:58:10.613 -> aaaaaaaaaabbbbbbbbbbccccccccccddddddddddeeeeeeeeeeffffffffffgggggggggghhhhhhhhhhiiiiiiiiiijjjjjjjjjjkkkkkkkkkkllllllllllmmmmmmmmmmnnnn

11:58:11.963 -> Sending 129 Bytes

11:58:11.963 -> aaaaaaaaaabbbbbbbbbbccccccccccddddddddddeeeeeeeeeeffffffffffgggggggggghhhhhhhhhhiiiiiiiiiijjjjjjjjjjkkkkkkkkkkllllllllllmmmmmmmmm

11:58:13.278 -> Sending 124 Bytes

11:58:13.278 -> aaaaaaaaaabbbbbbbbbbccccccccccddddddddddeeeeeeeeeeffffffffffgggggggggghhhhhhhhhhiiiiiiiiiijjjjjjjjjjkkkkkkkkkkllllllllllmmmm

11:58:14.595 -> Sending 119 Bytes

11:58:14.595 -> aaaaaaaaaabbbbbbbbbbccccccccccddddddddddeeeeeeeeeeffffffffffgggggggggghhhhhhhhhhiiiiiiiiiijjjjjjjjjjkkkkkkkkkklllllllll

11:58:15.875 -> Sending 114 Bytes

11:58:15.909 -> aaaaaaaaaabbbbbbbbbbccccccccccddddddddddeeeeeeeeeeffffffffffgggggggggghhhhhhhhhhiiiiiiiiiijjjjjjjjjjkkkkkkkkkkllll

11:58:17.154 -> Sending 109 Bytes

11:58:17.188 -> aaaaaaaaaabbbbbbbbbbccccccccccddddddddddeeeeeeeeeeffffffffffgggggggggghhhhhhhhhhiiiiiiiiiijjjjjjjjjjkkkkkkkkk

11:58:18.471 -> Sending 104 Bytes

11:58:18.471 -> aaaaaaaaaabbbbbbbbbbccccccccccddddddddddeeeeeeeeeeffffffffffgggggggggghhhhhhhhhhiiiiiiiiiijjjjjjjjjjkkkk

11:58:19.718 -> Sending 99 Bytes

11:58:19.752 -> aaaaaaaaaabbbbbbbbbbccccccccccddddddddddeeeeeeeeeeffffffffffgggggggggghhhhhhhhhhiiiiiiiiiijjjjjjjjj

11:58:20.957 -> Sending 94 Bytes

11:58:20.991 -> aaaaaaaaaabbbbbbbbbbccccccccccddddddddddeeeeeeeeeeffffffffffgggggggggghhhhhhhhhhiiiiiiiiiijjjj

11:58:22.199 -> Sending 89 Bytes

11:58:22.234 -> aaaaaaaaaabbbbbbbbbbccccccccccddddddddddeeeeeeeeeeffffffffffgggggggggghhhhhhhhhhiiiiiiiii

11:58:23.441 -> Sending 84 Bytes

11:58:23.441 -> aaaaaaaaaabbbbbbbbbbccccccccccddddddddddeeeeeeeeeeffffffffffgggggggggghhhhhhhhhhiiii

11:58:24.649 -> Sending 79 Bytes

11:58:24.649 -> aaaaaaaaaabbbbbbbbbbccccccccccddddddddddeeeeeeeeeeffffffffffgggggggggghhhhhhhhh

11:58:25.826 -> Sending 74 Bytes

11:58:25.859 -> aaaaaaaaaabbbbbbbbbbccccccccccddddddddddeeeeeeeeeeffffffffffgggggggggghhhh

11:58:27.029 -> Sending 69 Bytes

11:58:27.029 -> aaaaaaaaaabbbbbbbbbbccccccccccddddddddddeeeeeeeeeeffffffffffggggggggg

11:58:28.200 -> Sending 64 Bytes

11:58:28.235 -> aaaaaaaaaabbbbbbbbbbccccccccccddddddddddeeeeeeeeeeffffffffffgggg

11:58:29.370 -> Sending 59 Bytes

11:58:29.404 -> aaaaaaaaaabbbbbbbbbbccccccccccddddddddddeeeeeeeeeefffffffff

11:58:30.505 -> Sending 54 Bytes

11:58:30.540 -> aaaaaaaaaabbbbbbbbbbccccccccccddddddddddeeeeeeeeeeffff

11:58:31.641 -> Sending 49 Bytes

11:58:31.675 -> aaaaaaaaaabbbbbbbbbbccccccccccddddddddddeeeeeeeee

11:58:32.777 -> Sending 44 Bytes

11:58:32.811 -> aaaaaaaaaabbbbbbbbbbccccccccccddddddddddeeee

11:58:33.880 -> Sending 39 Bytes

11:58:33.915 -> aaaaaaaaaabbbbbbbbbbccccccccccddddddddd

11:58:34.978 -> Sending 34 Bytes

11:58:35.012 -> aaaaaaaaaabbbbbbbbbbccccccccccdddd

11:58:36.082 -> Sending 29 Bytes

11:58:36.117 -> aaaaaaaaaabbbbbbbbbbccccccccc

11:58:37.184 -> Sending 24 Bytes

11:58:37.219 -> aaaaaaaaaabbbbbbbbbbcccc

11:58:38.287 -> Sending 19 Bytes

11:58:38.287 -> aaaaaaaaaabbbbbbbbb

11:58:39.351 -> Sending 14 Bytes

11:58:39.386 -> aaaaaaaaaabbbb

11:58:40.408 -> Sending 9 Bytes

11:58:40.442 -> aaaaaaaaa

11:58:41.468 -> Sending 4 Bytes

11:58:41.501 -> aaaa

Receiver

11:57:36.935 -> Got: aaaaaaaaaabbbbbbbbbbccccccccccddddddddddeeeeeeeeeeffffffffffgggggggggghhhhhhhhhhiiiiiiiiiijjjjjjjjjjkkkkkkkkkkllllllllllmmmmmmmmmmnnnnnnnnnnooooooooooppppppppppqqqqqqqqqqrrrrrrrrrrssssssssssttttttttttuuuuuuuuuuvvvvvvvvvvwwwwwwwwwwxxxxxxxxxxyyyyyyyyy

11:57:36.935 -> number of Bytes is: 250

11:57:38.551 -> Got: aaaaaaaaaabbbbbbbbbbccccccccccddddddddddeeeeeeeeeeffffffffffgggggggggghhhhhhhhhhiiiiiiiiiijjjjjjjjjjkkkkkkkkkkllllllllllmmmmmmmmmmnnnnnnnnnnooooooooooppppppppppqqqqqqqqqqrrrrrrrrrrssssssssssttttttttttuuuuuuuuuuvvvvvvvvvvwwwwwwwwwwxxxxxxxxxxyyyy

11:57:38.551 -> number of Bytes is: 245

11:57:40.165 -> Got: aaaaaaaaaabbbbbbbbbbccccccccccddddddddddeeeeeeeeeeffffffffffgggggggggghhhhhhhhhhiiiiiiiiiijjjjjjjjjjkkkkkkkkkkllllllllllmmmmmmmmmmnnnnnnnnnnooooooooooppppppppppqqqqqqqqqqrrrrrrrrrrssssssssssttttttttttuuuuuuuuuuvvvvvvvvvvwwwwwwwwwwxxxxxxxxx

11:57:40.165 -> number of Bytes is: 240

11:57:41.752 -> Got: aaaaaaaaaabbbbbbbbbbccccccccccddddddddddeeeeeeeeeeffffffffffgggggggggghhhhhhhhhhiiiiiiiiiijjjjjjjjjjkkkkkkkkkkllllllllllmmmmmmmmmmnnnnnnnnnnooooooooooppppppppppqqqqqqqqqqrrrrrrrrrrssssssssssttttttttttuuuuuuuuuuvvvvvvvvvvwwwwwwwwwwxxxx

11:57:41.752 -> number of Bytes is: 235

11:57:43.333 -> Got: aaaaaaaaaabbbbbbbbbbccccccccccddddddddddeeeeeeeeeeffffffffffgggggggggghhhhhhhhhhiiiiiiiiiijjjjjjjjjjkkkkkkkkkkllllllllllmmmmmmmmmmnnnnnnnnnnooooooooooppppppppppqqqqqqqqqqrrrrrrrrrrssssssssssttttttttttuuuuuuuuuuvvvvvvvvvvwwwwwwwww

11:57:43.333 -> number of Bytes is: 230

11:57:44.891 -> Got: aaaaaaaaaabbbbbbbbbbccccccccccddddddddddeeeeeeeeeeffffffffffgggggggggghhhhhhhhhhiiiiiiiiiijjjjjjjjjjkkkkkkkkkkllllllllllmmmmmmmmmmnnnnnnnnnnooooooooooppppppppppqqqqqqqqqqrrrrrrrrrrssssssssssttttttttttuuuuuuuuuuvvvvvvvvvvwwww

11:57:44.891 -> number of Bytes is: 225

11:57:46.443 -> Got: aaaaaaaaaabbbbbbbbbbccccccccccddddddddddeeeeeeeeeeffffffffffgggggggggghhhhhhhhhhiiiiiiiiiijjjjjjjjjjkkkkkkkkkkllllllllllmmmmmmmmmmnnnnnnnnnnooooooooooppppppppppqqqqqqqqqqrrrrrrrrrrssssssssssttttttttttuuuuuuuuuuvvvvvvvvv

11:57:46.443 -> number of Bytes is: 220

11:57:47.987 -> Got: aaaaaaaaaabbbbbbbbbbccccccccccddddddddddeeeeeeeeeeffffffffffgggggggggghhhhhhhhhhiiiiiiiiiijjjjjjjjjjkkkkkkkkkkllllllllllmmmmmmmmmmnnnnnnnnnnooooooooooppppppppppqqqqqqqqqqrrrrrrrrrrssssssssssttttttttttuuuuuuuuuuvvvv

11:57:47.987 -> number of Bytes is: 215

11:57:49.507 -> Got: aaaaaaaaaabbbbbbbbbbccccccccccddddddddddeeeeeeeeeeffffffffffgggggggggghhhhhhhhhhiiiiiiiiiijjjjjjjjjjkkkkkkkkkkllllllllllmmmmmmmmmmnnnnnnnnnnooooooooooppppppppppqqqqqqqqqqrrrrrrrrrrssssssssssttttttttttuuuuuuuuu

11:57:49.507 -> number of Bytes is: 210

11:57:51.022 -> Got: aaaaaaaaaabbbbbbbbbbccccccccccddddddddddeeeeeeeeeeffffffffffgggggggggghhhhhhhhhhiiiiiiiiiijjjjjjjjjjkkkkkkkkkkllllllllllmmmmmmmmmmnnnnnnnnnnooooooooooppppppppppqqqqqqqqqqrrrrrrrrrrssssssssssttttttttttuuuu

11:57:51.022 -> number of Bytes is: 205

11:57:52.537 -> Got: aaaaaaaaaabbbbbbbbbbccccccccccddddddddddeeeeeeeeeeffffffffffgggggggggghhhhhhhhhhiiiiiiiiiijjjjjjjjjjkkkkkkkkkkllllllllllmmmmmmmmmmnnnnnnnnnnooooooooooppppppppppqqqqqqqqqqrrrrrrrrrrssssssssssttttttttt

11:57:52.537 -> number of Bytes is: 200

11:57:54.020 -> Got: aaaaaaaaaabbbbbbbbbbccccccccccddddddddddeeeeeeeeeeffffffffffgggggggggghhhhhhhhhhiiiiiiiiiijjjjjjjjjjkkkkkkkkkkllllllllllmmmmmmmmmmnnnnnnnnnnooooooooooppppppppppqqqqqqqqqqrrrrrrrrrrsssssssssstttt

11:57:54.020 -> number of Bytes is: 195

11:57:55.494 -> Got: aaaaaaaaaabbbbbbbbbbccccccccccddddddddddeeeeeeeeeeffffffffffgggggggggghhhhhhhhhhiiiiiiiiiijjjjjjjjjjkkkkkkkkkkllllllllllmmmmmmmmmmnnnnnnnnnnooooooooooppppppppppqqqqqqqqqqrrrrrrrrrrsssssssss

11:57:55.494 -> number of Bytes is: 190

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

11:58:27.192 -> number of Bytes is: 70

11:58:28.371 -> Got: aaaaaaaaaabbbbbbbbbbccccccccccddddddddddeeeeeeeeeeffffffffffgggg

11:58:28.371 -> number of Bytes is: 65

11:58:29.508 -> Got: aaaaaaaaaabbbbbbbbbbccccccccccddddddddddeeeeeeeeeefffffffff

11:58:29.508 -> number of Bytes is: 60

11:58:30.643 -> Got: aaaaaaaaaabbbbbbbbbbccccccccccddddddddddeeeeeeeeeeffff

11:58:30.643 -> number of Bytes is: 55

11:58:31.750 -> Got: aaaaaaaaaabbbbbbbbbbccccccccccddddddddddeeeeeeeee

11:58:31.750 -> number of Bytes is: 50

11:58:32.891 -> Got: aaaaaaaaaabbbbbbbbbbccccccccccddddddddddeeee

11:58:32.891 -> number of Bytes is: 45

11:58:33.992 -> Got: aaaaaaaaaabbbbbbbbbbccccccccccddddddddd

11:58:33.992 -> number of Bytes is: 40

11:58:35.095 -> Got: aaaaaaaaaabbbbbbbbbbccccccccccdddd

11:58:35.095 -> number of Bytes is: 35

11:58:36.163 -> Got: aaaaaaaaaabbbbbbbbbbccccccccc

11:58:36.163 -> number of Bytes is: 30

11:58:37.262 -> Got: aaaaaaaaaabbbbbbbbbbcccc

11:58:37.262 -> number of Bytes is: 25

11:58:38.330 -> Got: aaaaaaaaaabbbbbbbbb

11:58:38.330 -> number of Bytes is: 20

11:58:39.402 -> Got: aaaaaaaaaabbbb

11:58:39.402 -> number of Bytes is: 15

11:58:40.474 -> Got: aaaaaaaaa

11:58:40.474 -> number of Bytes is: 10

11:58:41.516 -> Got: aaaa

11:58:41.516 -> number of Bytes is: 5
