TravMcKee/Satellite-UHF-Radio-Beacon-system/Testing/Ground receiving station testing/RXDone interupt measurements/summary of results.docx

The below is the statistics using the measured values (blue on graph)

RX_int_mean = -8.3400e-08

RX_int_stddev = 2.8649e-06

RX_int_median = 1.5000e-08

max_time_diff = 4.2600e-06

min_time_diff = -5.6800e-06

The below is statistics using the absolute values (red on graphs)

Abs_RX_int_mean = 2.4058e-06

Abs_RX_int_stddev = 1.5194e-06

Abs_RX_int_median = 1.9250e-06

Abs_max_time_diff = 5.6800e-06

The below is the confidence intervals for measured values

H95 = 0

P95 = 1

CI95 = 1.0e-06 * (-0.8775, 0.7107)

H99 = 0

P99 = 1

CI99 = 1.0e-06 * ( -1.127, 0.960)

The below is the confidence intervals for absolute values

abs_H95 = 1

abs_P95 = 8.0546e-10

abs_CI95 = 1.0e-06 * (1.612, 3.200)

abs_H99 = 1

abs_P99 = 8.0546e-10

abs_CI99 = 1.0e-06 * (1.362, 3.449)
