TravMcKee/Satellite-UHF-Radio-Beacon-system/Testing/433 Red PCB testing files/Basic Cycle checks/Solar panel test results.docx

Test 1 – Solar panel checks, No capacitors

Clear and sunny day, temp approx. 34*C.

The solar panel test runs through the program Basic cycle checks where the systems runs through the Basic satellite program, Satellite launch (turns everything off for 3 seconds), then the satellite collects data, sends data, enters RX mode for 30 seconds, goes into the low power mode for 4 minutes and then repeats this process without the satellite launch. The SP value should count sequentially for every transmit if the radio/microprocessor does not reset, it the count resets to 1 then the beacon has reset itself as there was not enough power from the solar panels. The size of the data packet being sent is 50 Bytes and the voltage regulator used is the adafruit LM3671 Buck converter for power regulation (fed to the RAW pin of the APM module).

3 solar panels connected results

10:08:53.066 -> Feather LoRa RX Test!

10:08:53.168 -> LoRa radio init OK!

10:08:53.168 -> Set Freq to: 437.00

10:12:04.028 -> Received:

10:12:04.028 -> 49 44 3A 20 54 72 61 76 53 61 74 31 2C 42 56 3A

10:12:04.028 -> 20 32 38 37 2C 53 50 3A 20 31 2C 44 31 2C 20 38

10:12:04.028 -> 34 2C 44 32 3A 20 38 31 2C 44 33 3A 20 38 30 0

10:12:04.028 -> 0 0

10:12:04.028 -> Got: ID: TravSat1,BV: 287,SP: 1,D1, 84,D2: 81,D3: 80

10:12:04.028 -> number of Bytes is: 50

10:16:48.895 -> Received:

10:16:48.895 -> 49 44 3A 20 54 72 61 76 53 61 74 31 2C 42 56 3A

10:16:48.895 -> 20 35 30 2C 53 50 3A 20 32 2C 44 31 2C 20 31 32

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

12:16:56.337 -> 0 0

12:16:56.337 -> Got: ID: TravSat1,BV: 2,SP: 4,D1, 0,D2: 0,D3: 0

12:16:56.337 -> number of Bytes is: 50

*When the capacitors were added then enough energy was stored for a transmit that the system did not reset. There were 5 25V 2200uF capacitors used to store the energy.
