TravMcKee/Satellite-UHF-Radio-Beacon-system/Testing/433 Red PCB testing files/Data Checks/10 Bytes per packet - check/raw data - CRC Off - 4-5 CR - 100000 packets.docx

10 Bytes packet check, CRC off – Coding rate 4/5 – 10,000 Batches

12:37:02.533 -> Feather LoRa RX Test!

12:37:02.635 -> LoRa radio init OK!

12:37:02.669 -> Set Freq to: 437.00

12:37:09.568 -> check 1 ->10 packets of data received, Total packets dropped: 0

12:37:13.076 -> check 2 ->10 packets of data received, Total packets dropped: 0

12:37:16.560 -> check 3 ->10 packets of data received, Total packets dropped: 0

12:37:20.096 -> check 4 ->10 packets of data received, Total packets dropped: 0

12:37:23.571 -> check 5 ->10 packets of data received, Total packets dropped: 0

12:37:27.080 -> check 6 ->10 packets of data received, Total packets dropped: 0

12:37:30.616 -> check 7 ->10 packets of data received, Total packets dropped: 0

12:37:34.106 -> check 8 ->10 packets of data received, Total packets dropped: 0

12:37:37.610 -> check 9 ->10 packets of data received, Total packets dropped: 0

12:37:41.110 -> check 10 ->10 packets of data received, Total packets dropped: 0

12:37:44.604 -> check 11 ->10 packets of data received, Total packets dropped: 0

12:37:48.103 -> check 12 ->10 packets of data received, Total packets dropped: 0

12:37:51.613 -> check 13 ->10 packets of data received, Total packets dropped: 0

12:37:55.139 -> check 14 ->10 packets of data received, Total packets dropped: 0

12:37:58.627 -> check 15 ->10 packets of data received, Total packets dropped: 0

12:38:02.142 -> check 16 ->10 packets of data received, Total packets dropped: 0

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

14:37:04.697 -> check 2054 ->10 packets of data received, Total packets dropped: 15

14:37:08.202 -> check 2055 ->10 packets of data received, Total packets dropped: 15

14:37:11.703 -> check 2056 ->10 packets of data received, Total packets dropped: 15

14:37:15.207 -> check 2057 ->10 packets of data received, Total packets dropped: 15

14:37:18.711 -> check 2058 ->10 packets of data received, Total packets dropped: 15

14:37:22.216 -> check 2059 ->10 packets of data received, Total packets dropped: 15

14:37:25.723 -> check 2060 ->10 packets of data received, Total packets dropped: 15

14:37:29.230 -> check 2061 ->10 packets of data received, Total packets dropped: 15

14:37:32.734 -> check 2062 ->10 packets of data received, Total packets dropped: 15

14:37:36.234 -> check 2063 ->10 packets of data received, Total packets dropped: 15

14:37:39.744 -> check 2064 ->10 packets of data received, Total packets dropped: 15

14:37:43.250 -> check 2065 ->10 packets of data received, Total packets dropped: 15

14:37:46.757 -> check 2066 ->10 packets of data received, Total packets dropped: 15

14:37:50.262 -> check 2067 ->10 packets of data received, Total packets dropped: 15

14:37:53.764 -> check 2068 ->10 packets of data received, Total packets dropped: 15
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
