TravMcKee/Satellite-UHF-Radio-Beacon-system/VIVA and Interim report/Appendix A - Project Gantt chart.pdf

# Appendix A - Project Gantt chart ea

# te Small Sat UHF Identification and TT&C radio beacon

## Enter Company Name in cell B2. UNINSW Canberra - Thesis project

https://www.vertex42.com/ExcelTemplates/simple-gantt-chart.html

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

## Travis MCKee

e
Di

1

lls | 15 16 17 18 19 20 21 | 22 23 24 25 26 27 28 | 29 30 31 1 2 3 4 | 5 6 7 8 9 10 11 | 12 13 14 15 16 17 18 | 19 20 21 22 23 24 25 | 26 27 28 29 30 31 1 | 2 3 4 5 6 7 | 8 | 9 10 11 12 13 14 15 | 16 17 18 19 20 21 22 | 23 24 25 26 27 28 29 | 30 1 2 3 4 5 6 | 7 | 8 9 10 11 12 13 | 14 15 16 17 18 19 20 | 21 22 23 24 25 26 27 | 28 29 30 31 1 2 3 | 4 5 6 7 8 9 10 | 11 12 13 14 15 16 17 | 18 19 20 21 22 23 24 | 25 26
is
ro
TASK | ASSIGNED
TO
PROGRESS | START | END | M | T | W | T | F | S | S | M | T | W | T | F | S | S | M | T | W | T | F | S | S | M | T | W | T | F | S | S | M | T | W | T | F | S | S | M | T | W | T | F | S | S | M | T | W | T | F | S | S | M | T | W | T | F | S | S | M | T | W | T | F | S | S | M | T | W | T | F | S | S | M | T | W | T | F | S | S | M | T | W | T | F | S | S | M | T | W | T | F | S | S | M | T | W | T | F | S | S | M | T | W | T | F | S | S | M | T | W | T | F | S | S | M | T | W | T | F | S | S | M | T | W | T | F | S | S | M | T | W | T | F | S | S | M | T
ll
B8 Planning
ll
B9 | Scope Determination | 100% | 15-Jul-19 04-Aug-19
o
w
Literture Review | 100% | 15-Jun-19 04-Oct-19
General Research | 100% | 15-Jul-19 01-Sep-19
e
ce

Breadboard design and build

Initial system design | 100% | 12-Aug-19 25-Aug-19
Processor and comms build | 100% | 26-Aug-19 15-Sep-19
Ground Solar generation and regulation build | 100% | 16-Sep-19 22-Sep-19
Full breadboard intergration | 100% | 23-Sep-19 04-Oct-19
breadboard extra peripherals design and build | 100% | 26-Sep-19 17-Oct-19

Sample phase title block Testing and Evaluation

Initial testing | 100% | 16-Sep-19 22-Sep-19
Power cycle testing | 100% | 22-Sep-19 29-Sep-19
Solar Power Testing | 100% | 26-Sep-19 29-Sep-19
Short and full beacon cycle testing | 100% | 29-Sep-19 04-Oct-19
Extra peripherals testing | 100% | 29-Sep-19 04-Oct-19
VIVA presentation testing | 100% | 04-Oct-19 07-Oct-19
Initial testing plan | 0% | 07-Oct-19 08-Dec-19
Final testing plan | 0% | 09-Dec-19 31-Jan-20

Sample phase title block Incremental development milestones

breadboard Model for VIVA presentation | 100% | 12-Aug-19 07-Oct-19
Initial software development | 100% | 12-Aug-19 07-Oct-19
Initial breadboard testing | 100% | 29-Sep-19 07-Oct-19
Finial breadboard testing | 0% | 07-Oct-19 08-Dec-19
Intial PCB Design | 0% | 07-Oct-19 23-Dec-19
Initial PCB prototype | 0% | 23-Dec-19 19-Jan-20
Initial PCB testing | 0% | 19-Jan-20 26-Jan-20
Build, Test, Evaluate and Redesign cycle | 0% | 16-Jan-20 25-May-20
1st deliverable working PCB model | 0% | 10-Feb-20 10-Feb-20
Final PCB model | 0% | 25-May-20 25-May-20
Final model tested and complete | 0% | 25-May-20 31-May-20
Final software design for PCB model (seminar presentation) 0% | 01-Jun-20 06-Jun-20
e
ce

Documentation

Access approval forms | 100% | 16-Jul-19 | 16-Jul-19
TSG/WHS/Ethics plan | 100% | 16-Aug-19 16-Aug-19
Interim Report | 100% | 04-Oct-19 04-Oct-19
VIVA | 100% | 07-Oct-19 18-Oct-19
Final Report | 0% | 09-Jun-20 09-Jun-20
Deliverables | 0% | 15-Jun-20 15-Jun-20
Project Seminar | 0% | 25-May-20 05-Jun-20

Sample phase title block Extension

Full SSA system concept, design and protype | 0% | 11-Nov-19 08-Jun-20
Full Control intergration | 0% | 11-Nov-19 08-Jun-20
LEO tracking system concept and design | 0% | 11-Nov-19 08-Jun-20
Amatuer tracking system | 0% | 11-Nov-19 08-Jun-20

This is an empty row
is
ro

Insert new rows ABOVE this one

Week 18 | Week 19
Aug 26, 2019 | Sep 2, 2019 | Oct 14, 2019 | Oct 21, 2019 | Nov 18, 2019 | Nov 25, 2019

## W20 - Break

Sep 9, 2019 | Sep 16, 2019 | Sep 23, 2019 | Sep 30, 2019 | Oct 7, 2019 | Oct 28, 2019 | Nov 4, 2019 | Nov 11, 2019
Wed, 7/17/2019 | Week 15 | Week 16 W17 - Exams
Jul 15, 2019 | Jul 22, 2019 | Jul 29, 2019 | Aug 5, 2019

Project Start:

Display Week:

Aug 12, 2019

Week 1 | Week 2 | Week 3 | Week 4 | Week 5

Aug 19, 2019

Week 6 | Week 7 | W8 - Break W9 - Break | Week 10 | Week 11 | Week 12 | Week 13 | Week 14

## Week 24

## Week 26

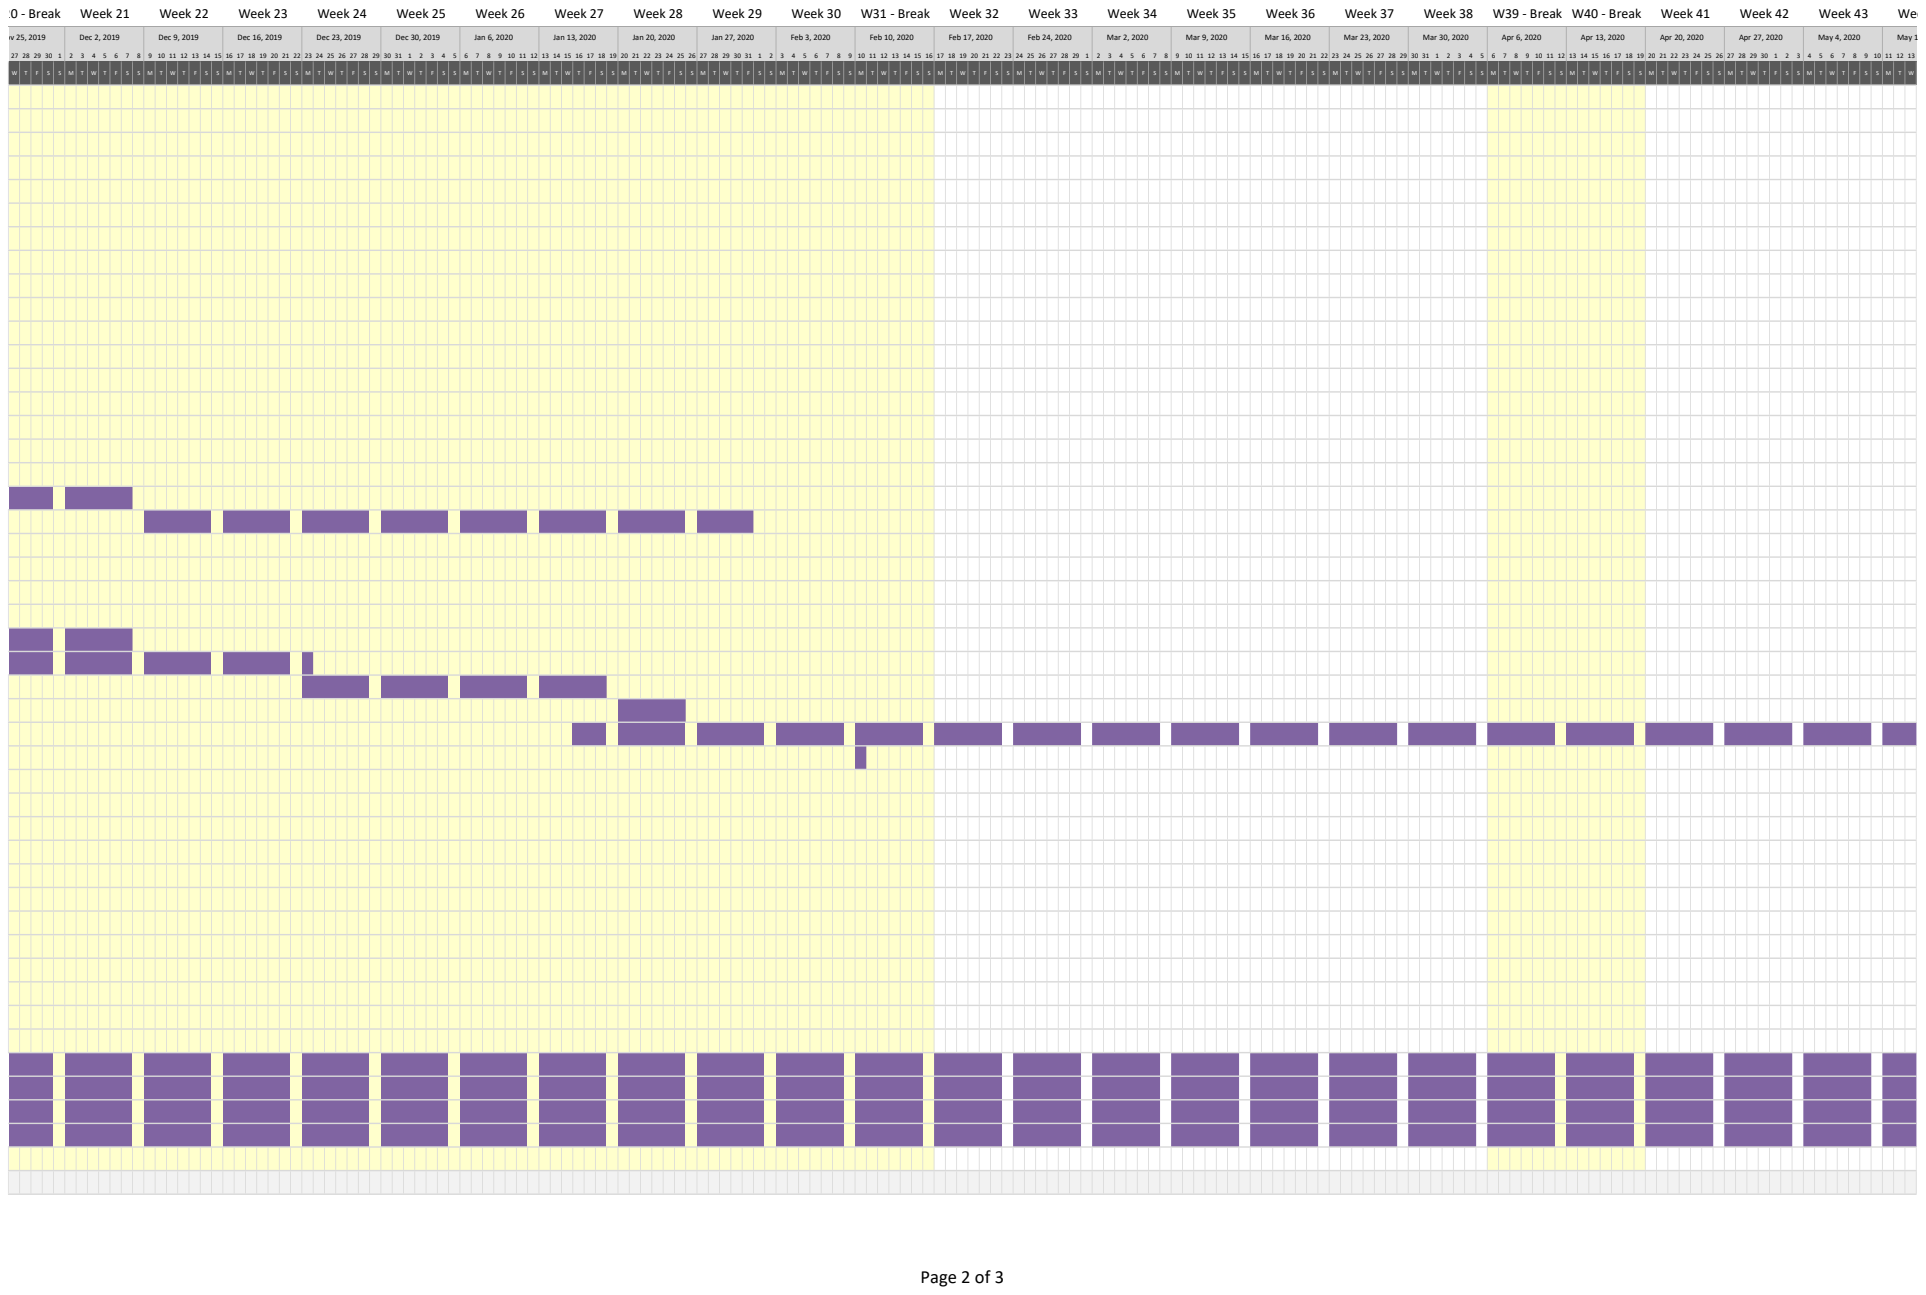
[picture p165: page 2]
Nov 25, 2019; Dec 30, 2019; Dec 23, 2019; Dec 16, 2019; Week 22; Dec 9, 2019; W20 - Break Week 21; Dec 2, 2019; Week 23; Week 30; Feb 3, 2020; W31 - Break; Feb 10, 2020; Week 32; Feb 17, 2020; Week 27; Jan 13, 2020; Week 28; Jan 20, 2020; Week 29; Jan 6, 2020; Jan 27, 2020; Week 25; Week 36; Mar 16, 2020; Week 37; Mar 23, 2020; Week 38; Mar 30, 2020; Week 33; Feb 24, 2020; Week 34; Mar 2, 2020; Week 35; Mar 9, 2020; Week 42; Apr 27, 2020; Week 43; May 4, 2020; Week 44; May 11, 2020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

## Week 48

## Week 49

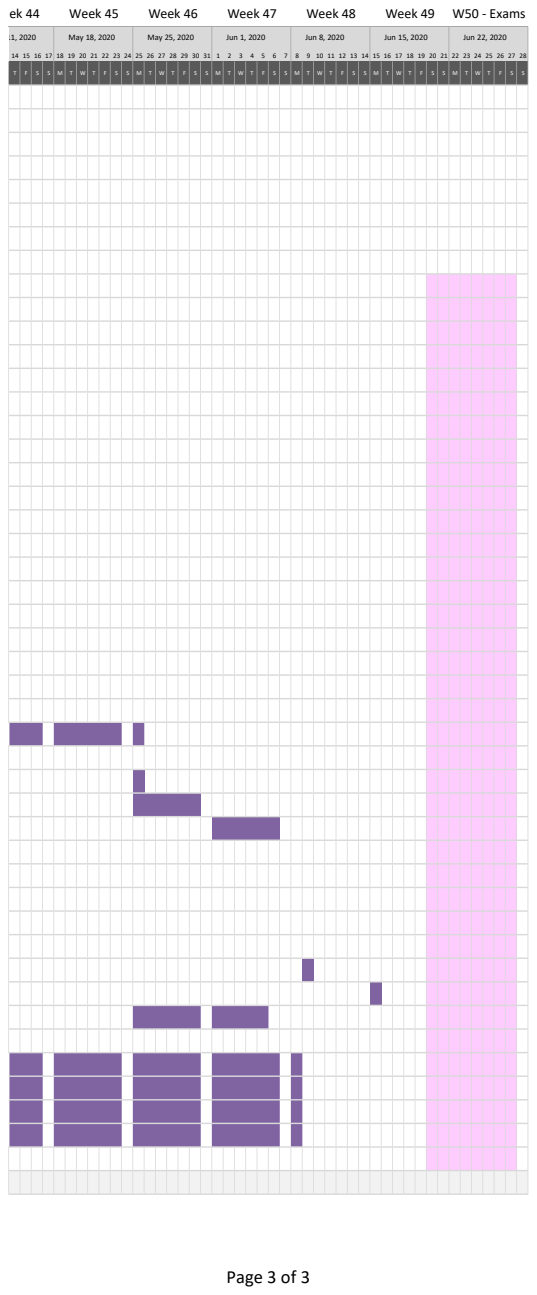
[picture p166: page 3]
Jun 8, 2020; Jun 15, 2020; W50 - Exams; Jun 22, 2020; Week 45; May 18, 2020; Week 46; May 25, 2020; Week 47; Jun 1, 2020; Page 3 of 3
