TravMcKee/Satellite-UHF-Radio-Beacon-system/Final report/Turnitin submission receipt.pdf

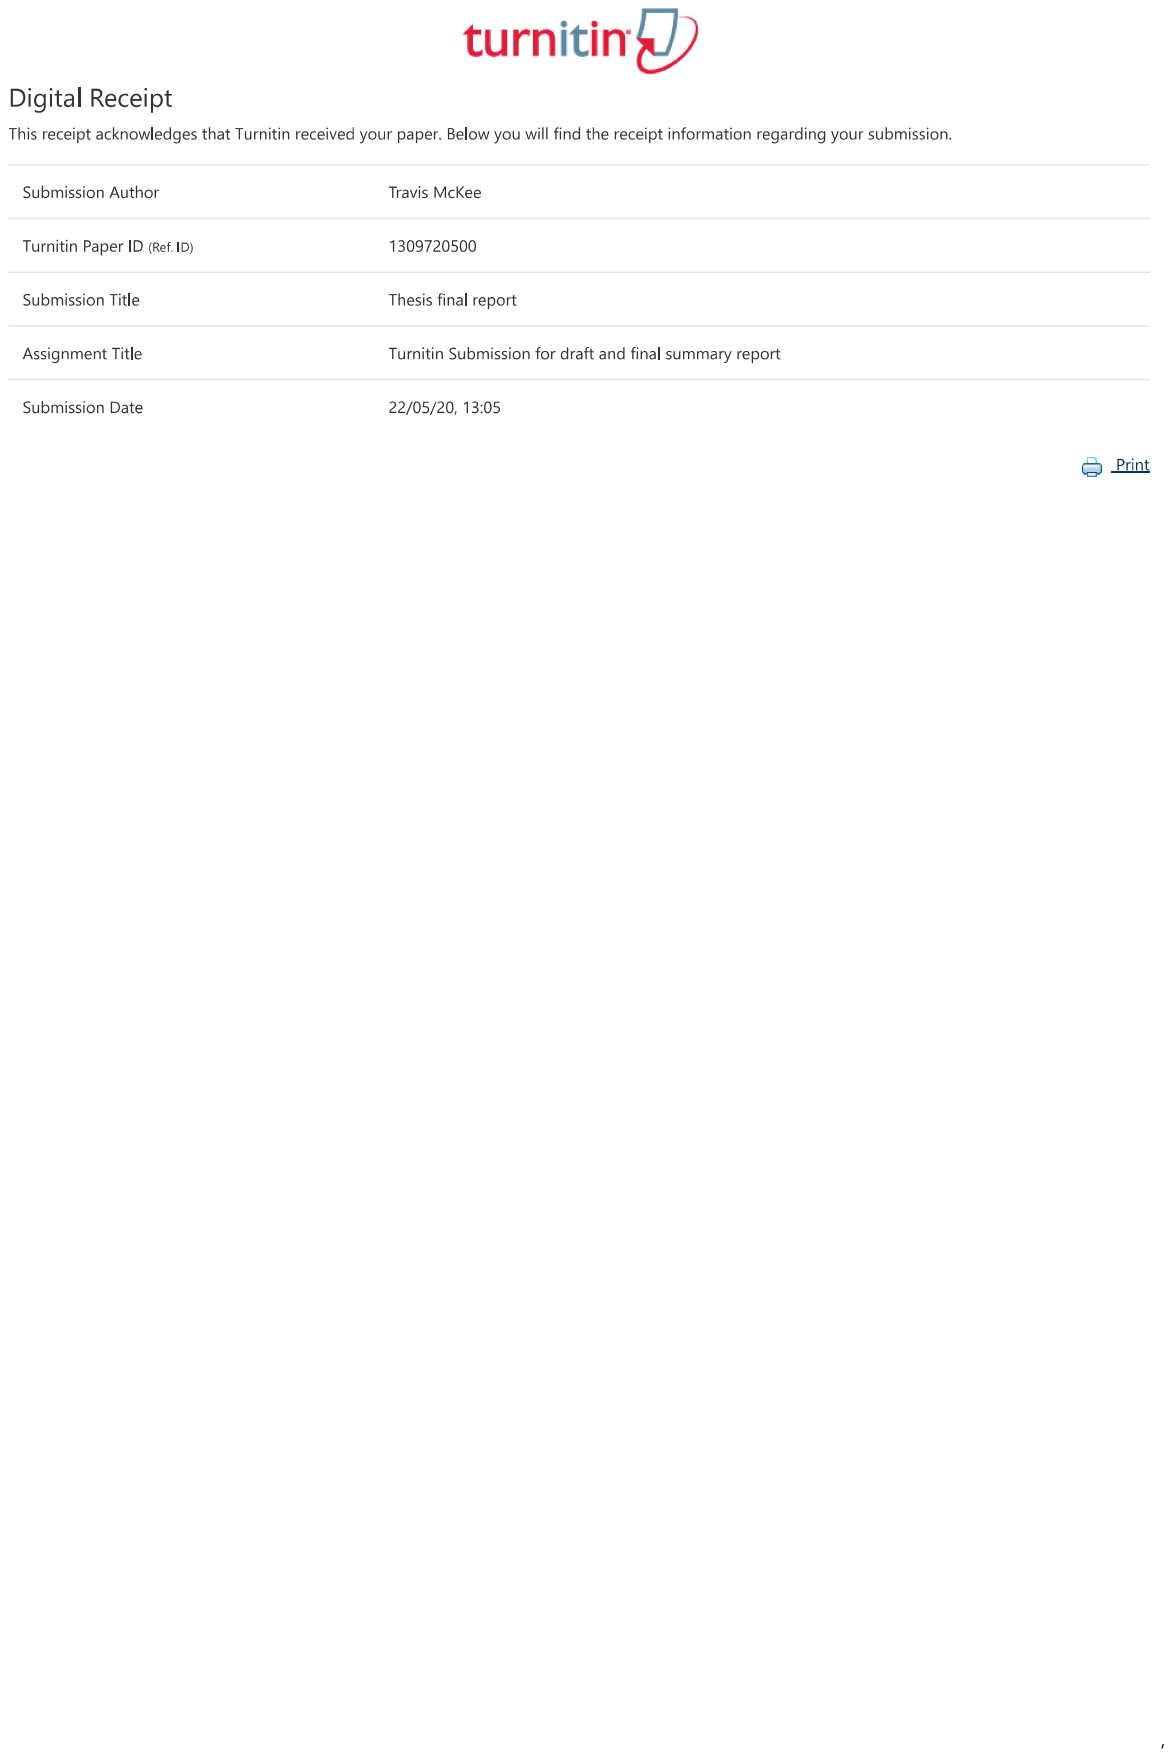
[picture p167: page 1]
