TravMcKee/Satellite-UHF-Radio-Beacon-system/User guide/Satellite beacon software flow chart.pdf

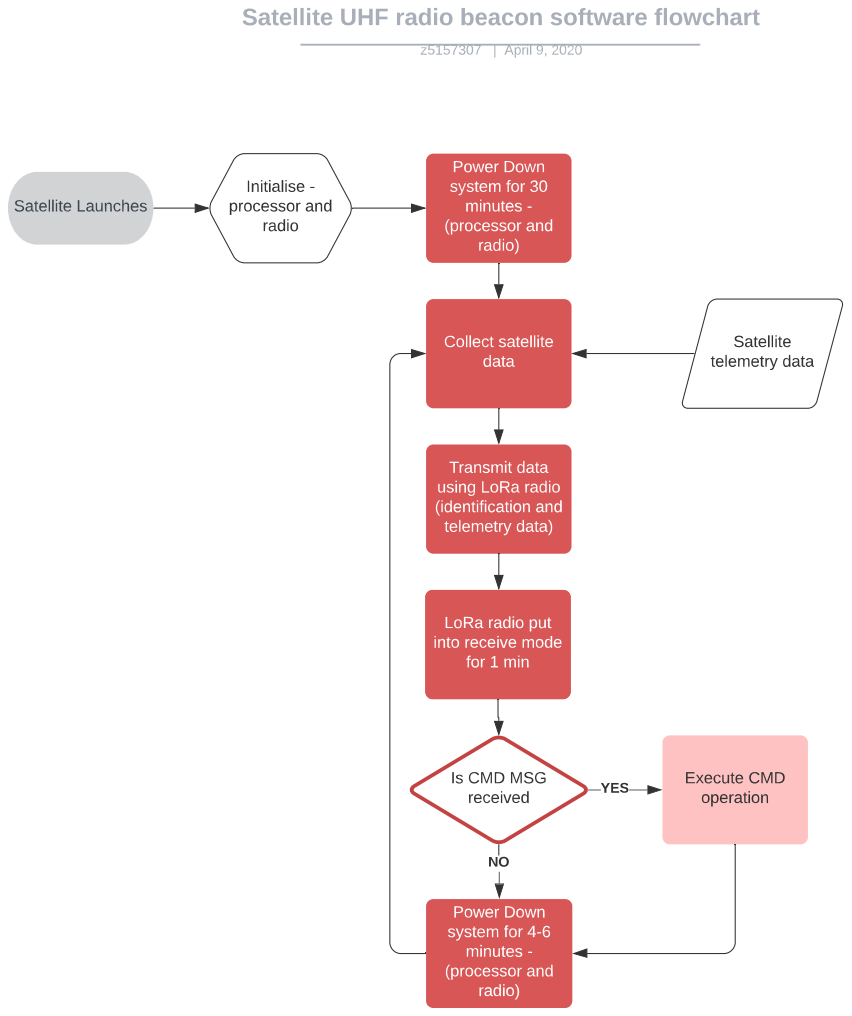
[picture p168: page 1]
