TravMcKee/Satellite-UHF-Radio-Beacon-system/User guide/Satellite ground station software flow chart.pdf

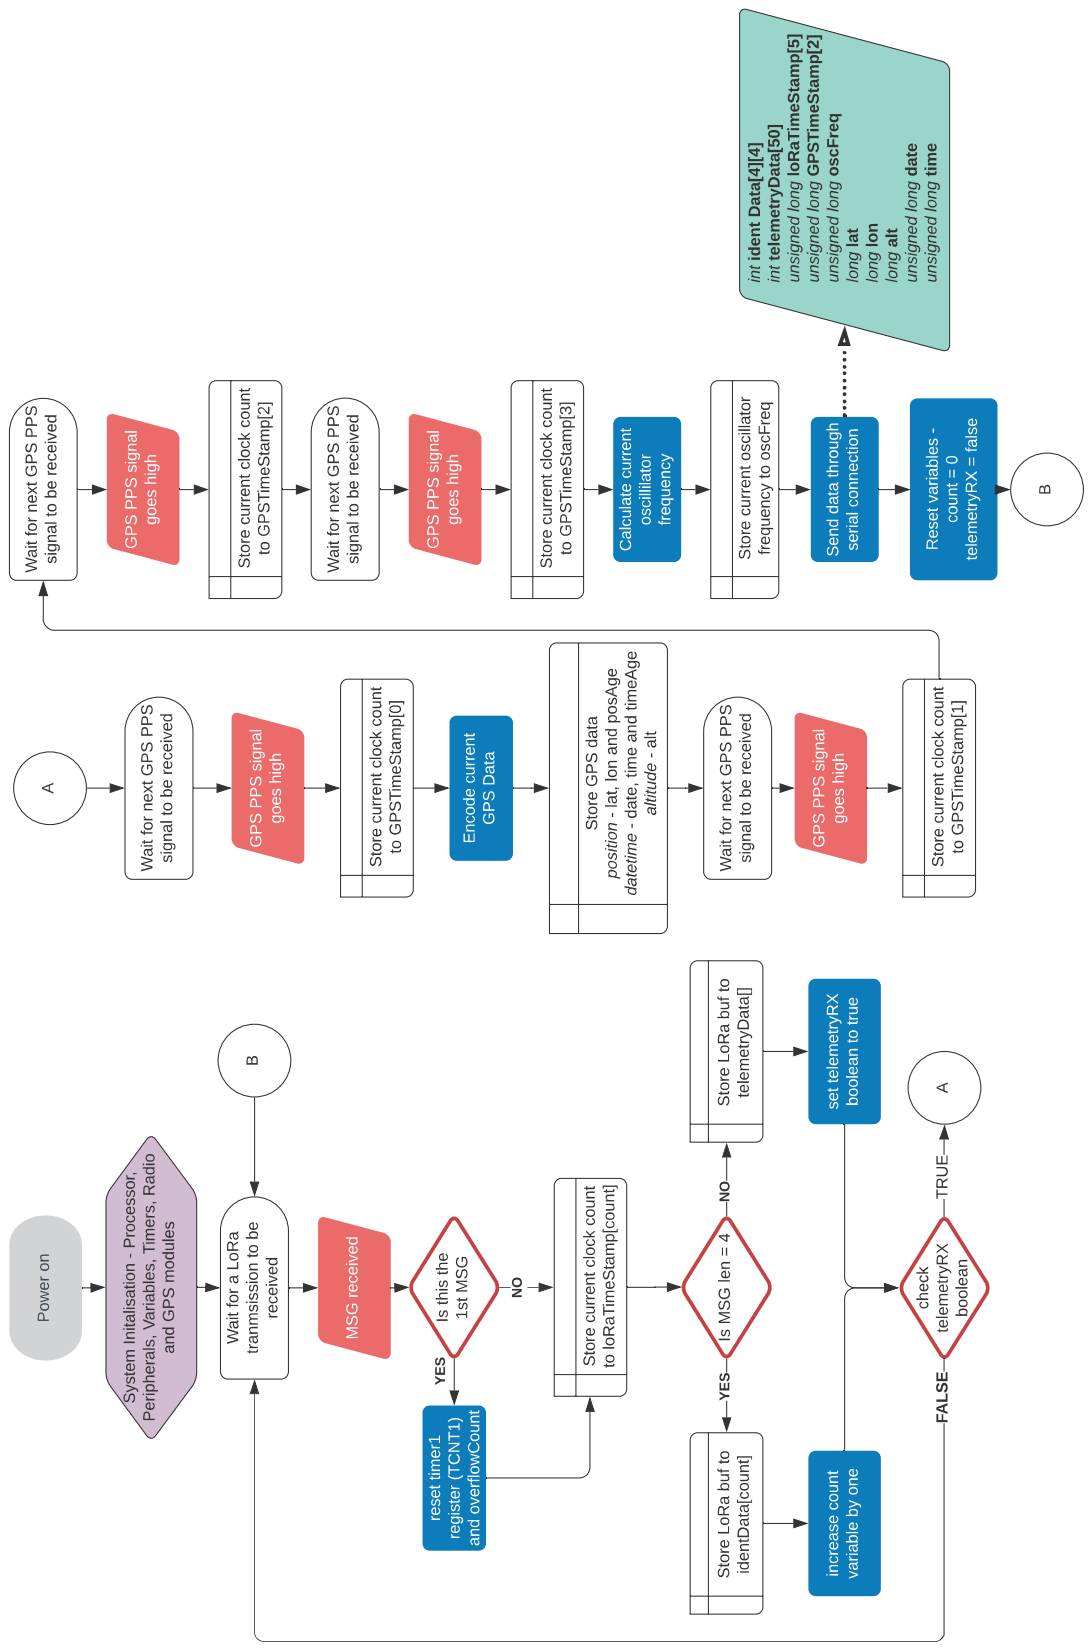
[picture p169: page 1]
