TravMcKee/Satellite-UHF-Radio-Beacon-system/Additional resources/LoRa RFM95 Breadboard/RFM95LORA_Breadboard-master/RFM95BreadBoard4LORA.pdf

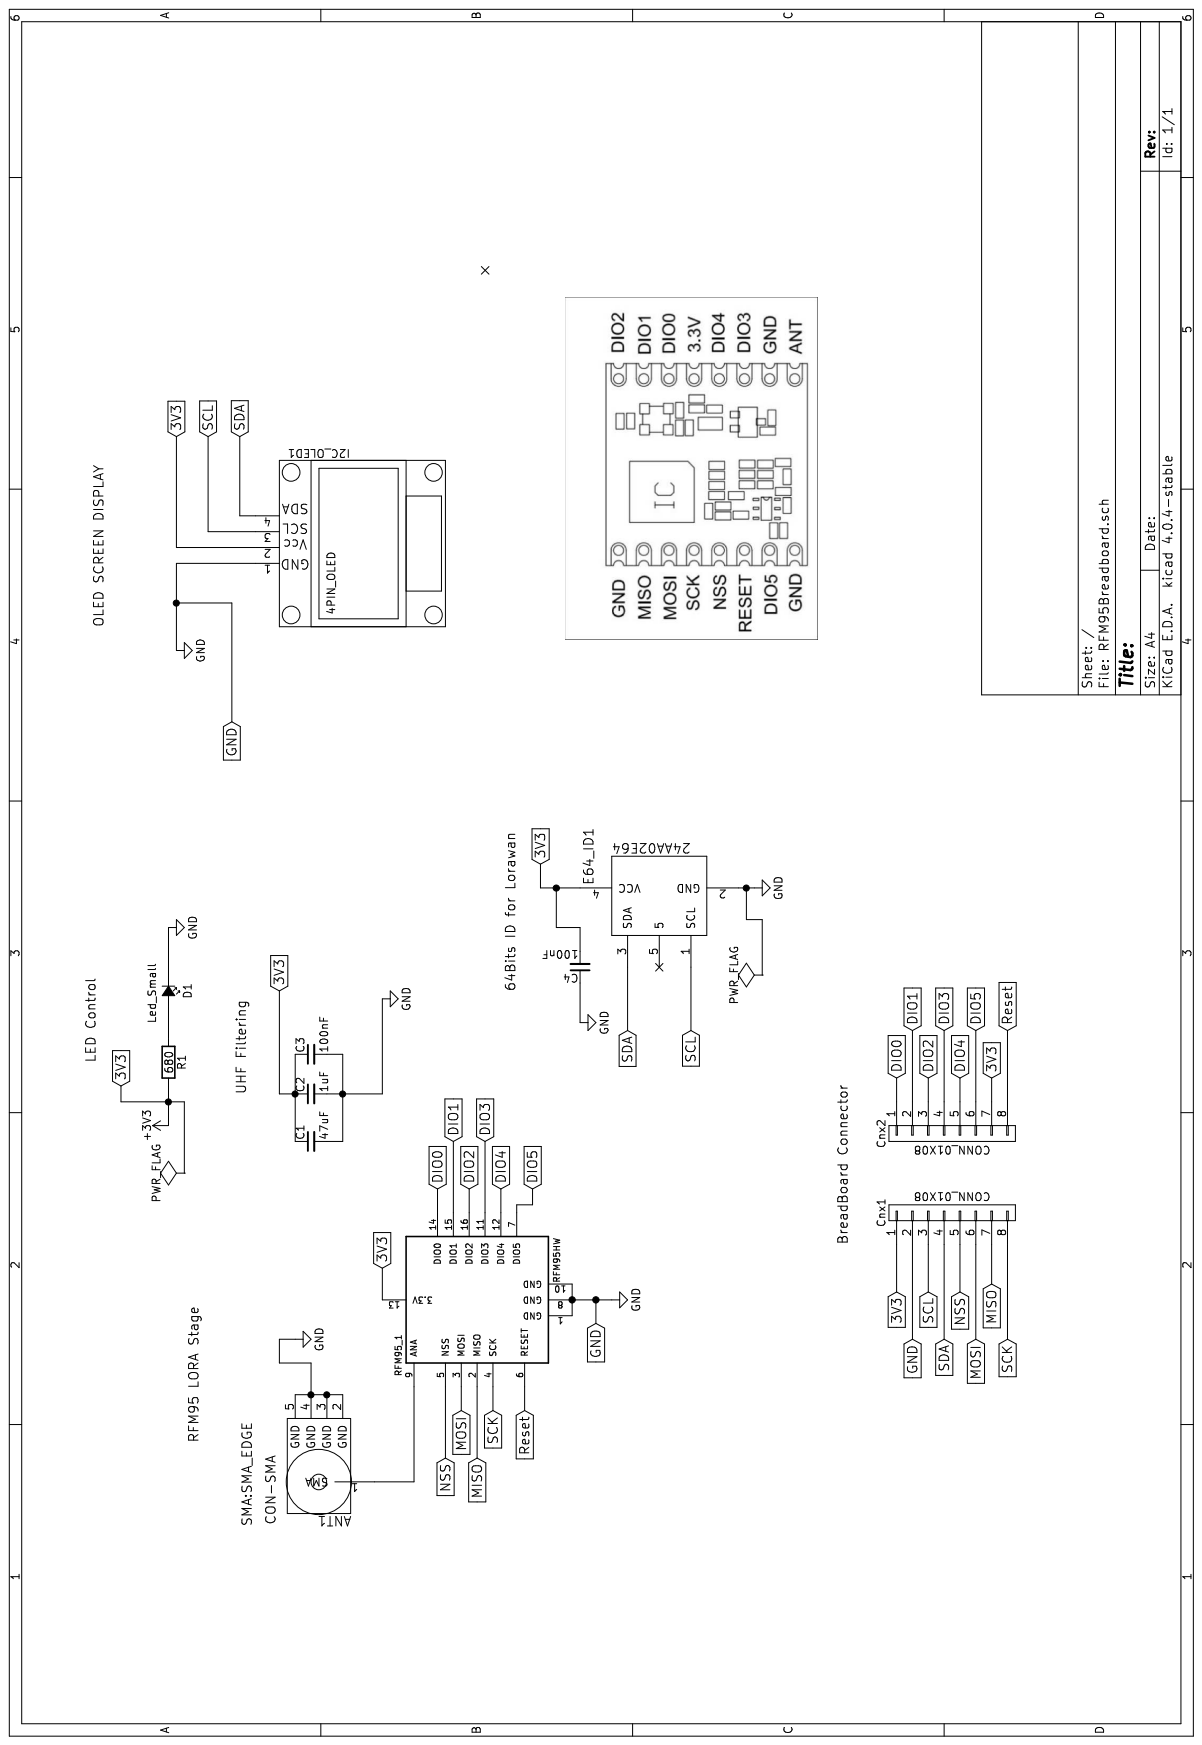
[picture p170: page 1]
