TravMcKee/Satellite-UHF-Radio-Beacon-system/Additional resources/Adafruit-LM3671-Buck-Converter-PCB-master/Adafruit LM3671 Buck.brd

## EAGLE design Additional resources/Adafruit-LM3671-Buck-Converter-PCB-master/Adafruit LM3671 Buck.brd (2020-06-12)

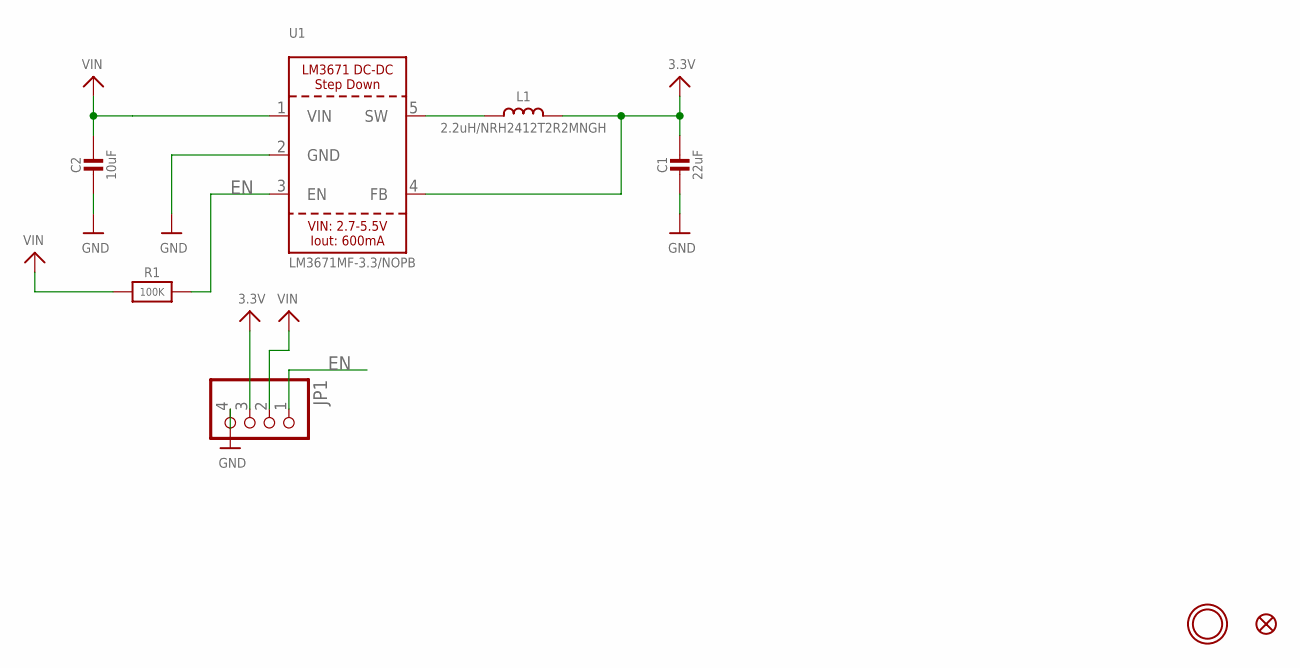
[picture p179: schematic Adafruit LM3671 Buck.sch]

Parts:
C1: 22uF; 0805-NO
C2: 10uF; 0805-NO
FID1: FIDUCIAL""; FIDUCIAL_1MM
JP1: HEADER-1X4ROUND; 1X04_ROUND
L1: 2.2uH/NRH2412T2R2MNGH; INDUCTOR_TAIYOYUDEN_NRH2412T
R1: 100K; 0805-NO
U1: LM3671MF-3.3/NOPB; SOT23-5
U$9: MOUNTINGHOLE2.5; MOUNTINGHOLE_2.5_PLATED

Connections:
3.3V: C1.1, JP1.3, L1.2, U1.4 (FB)
EN: JP1.1, R1.2, U1.3 (EN)
GND: C1.2, C2.2, JP1.4, U1.2 (GND)
unnamed: L1.1, U1.5 (SW)
VIN: C2.1, JP1.2, R1.1, U1.1 (VIN)

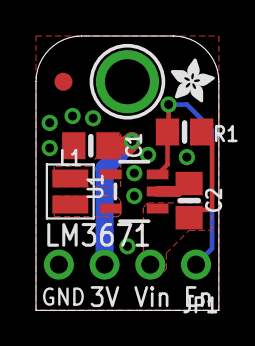
[picture p180: board Adafruit LM3671 Buck.brd from above]

Board: 2 copper layers, 10.2 x 15.2 mm, 10 parts (1 on the bottom side), 5 nets.

Other parts of the board:
U$10: PCBFEAT-REV-040
U$11: ADAFRUIT_2.5MM
